albaniac/Teplica/Proteus_USB_Distance/Gerber/Proteus_USB_Distance - CADCAM Mechanical 1.TXT

G04 PROTEUS RS274X GERBER FILE*
%FSLAX24Y24*%
%MOIN*%
%ADD43C,0.0050*%
%ADD73C,0.0080*%
G54D43*
X+11545Y+1278D02*
X+11545Y+1632D01*
X+12293Y+1632D01*
X+12293Y+1278D01*
X+11545Y+1278D01*
X+11547Y-1918D02*
X+11547Y-1564D01*
X+12295Y-1564D01*
X+12295Y-1918D01*
X+11547Y-1918D01*
G54D73*
X-12538Y-8065D02*
X+13058Y-8065D01*
X+13058Y+7624D01*
X-12538Y+7624D01*
X-12538Y-8065D01*
M00*
