albaniac/Teplica/Proteus Teplitca2/GERBER/Teplitca2_1 - CADCAM Mechanical 1.TXT

G04 PROTEUS RS274X GERBER FILE*
%FSLAX24Y24*%
%MOIN*%
%ADD17C,0.0080*%
G54D17*
X-57840Y-34693D02*
X+58563Y-34693D01*
X+58563Y+36302D01*
X-57840Y+36302D01*
X-57840Y-34693D01*
M00*
