albaniac/Teplica/Proteus Teplitca1/GERBER/Teplitca1_1 - CADCAM Mechanical 1.TXT

G04 PROTEUS RS274X GERBER FILE*
%FSLAX24Y24*%
%MOIN*%
%ADD18C,0.0080*%
G54D18*
X-57840Y-34693D02*
X+58563Y-34693D01*
X+58563Y+48073D01*
X-57840Y+48073D01*
X-57840Y-34693D01*
M00*
