albaniac/Teplica/SOFT/lang/en.ini.richTextBox1.rtf

To add SMS to device click the "Add SMS" button - after entering params new SMS will be saved to the device automatically.

By clicking the "SMS list" button you can view entered SMS list, saved locally. This list is for help purposes only.

Any SMS, added by clicking the "Add SMS" button is saved to the device automatically. In the current version of firmware it is not possible to get list of SMS, stored in device. Uniqueness of SMS is computed based on SMS text - if the SMS with such text already exists - it will be overwritten in the device.

Default commands are:

1. #1 - open windows;
2. #0 - close windows;
3. #4 - turn watering on;
4. #6 - turn watering off;
5. #8 - turn device into automatic work mode;
6. #9 - get status SMS*.
7. #5 - request balance (received via SMS);

*You can receive status SMS by simple make call to the device phone number.
