albaniac/Teplica/ProteusGreenhouseDUE0_1/Gerber/ProteusGreenhouseDUE0_7 - CADCAM Mechanical 1.TXT

G04 PROTEUS RS274X GERBER FILE*
%FSLAX24Y24*%
%MOIN*%
%ADD90C,0.0050*%
%ADD10C,0.0080*%
G54D90*
X+56833Y-14618D02*
X+56833Y-14264D01*
X+57581Y-14264D01*
X+57581Y-14618D01*
X+56833Y-14618D01*
X+56833Y-11862D02*
X+56833Y-11508D01*
X+57581Y-11508D01*
X+57581Y-11862D01*
X+56833Y-11862D01*
X+56832Y-20108D02*
X+56832Y-19754D01*
X+57580Y-19754D01*
X+57580Y-20108D01*
X+56832Y-20108D01*
X+56832Y-17352D02*
X+56832Y-16998D01*
X+57580Y-16998D01*
X+57580Y-17352D01*
X+56832Y-17352D01*
G54D10*
X-57840Y-34693D02*
X+58563Y-34693D01*
X+58563Y+36302D01*
X-57840Y+36302D01*
X-57840Y-34693D01*
M00*
