albaniac/Teplica/ProteusGreenhouseDUE0_1/DOC/show.pdf

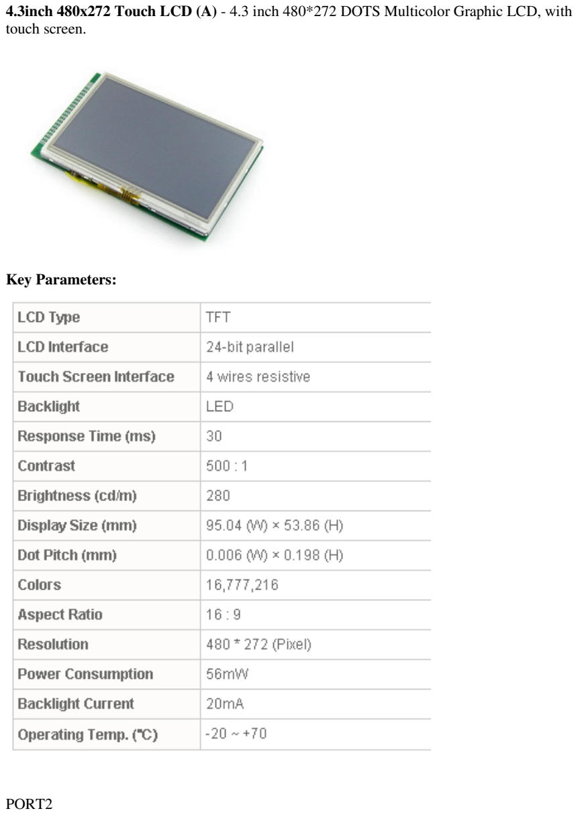
[picture p23: page 1]

4.3inch 480x272 Touch LCD (A) - 4.3 inch 480*272 DOTS Multicolor Graphic LCD, with touch screen.

Key Parameters:

PORT2

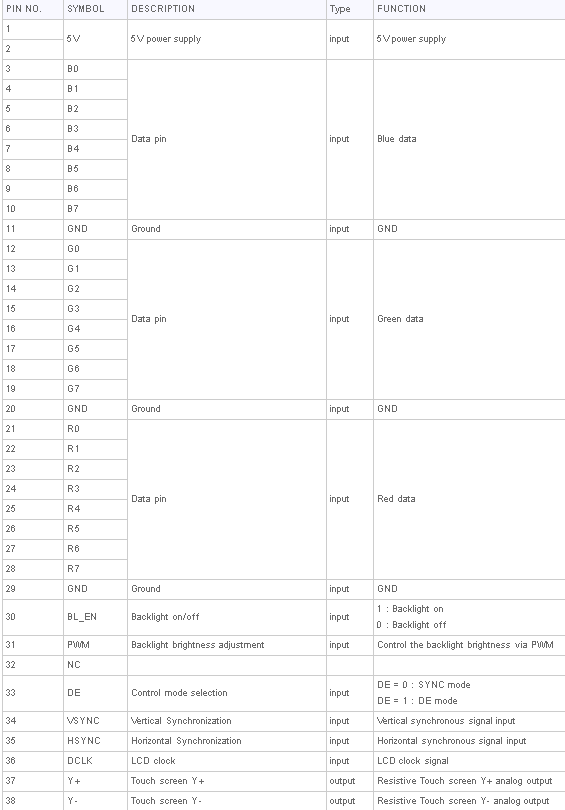
[picture p24: page 2]
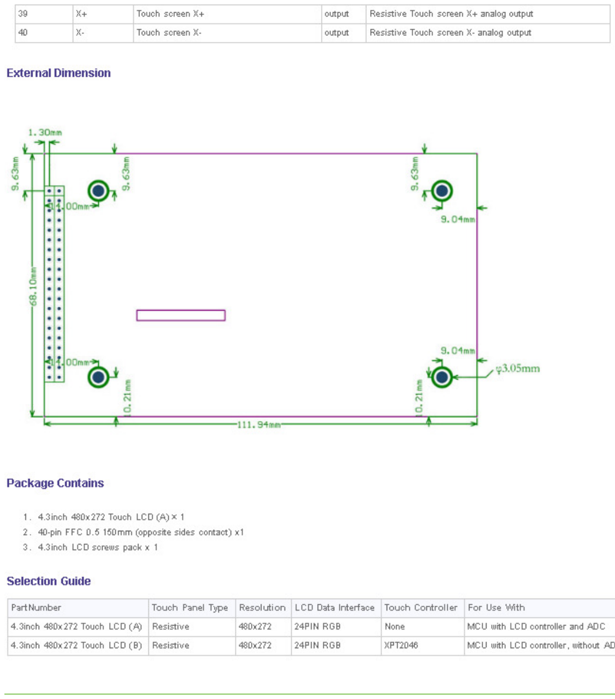
[picture p25: page 3]
