albaniac/Teplica/DOC/HTB1qAwCckSWBuNjSszdq6zeSpXaJ.jpg

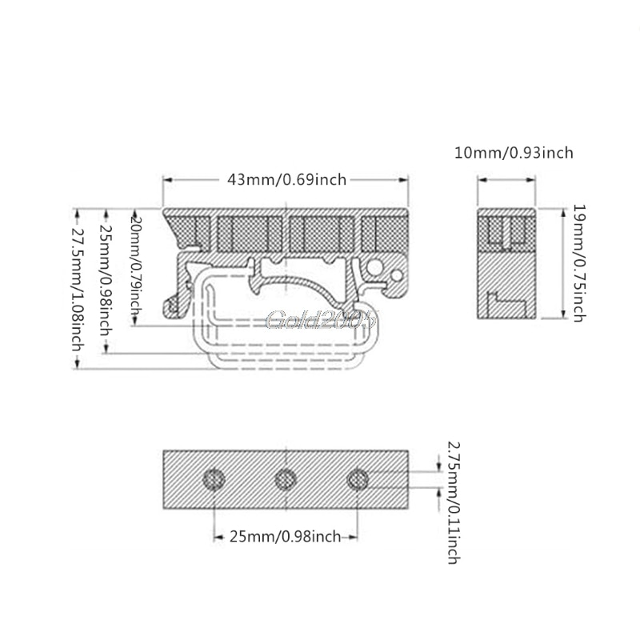
DOC/HTB1qAwCckSWBuNjSszdq6zeSpXaJ.jpg
