albaniac/Teplica/DOC/rj11_02.jpg

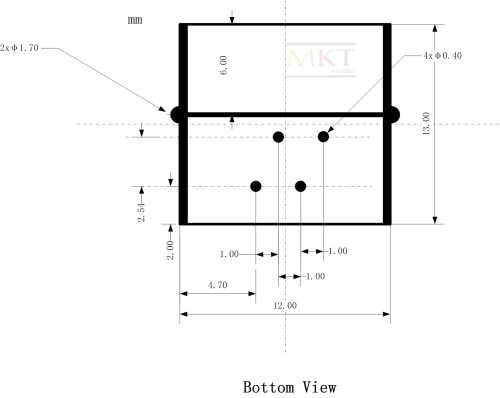
DOC/rj11_02.jpg
