albaniac/Teplica/DOC/rj11_03.jpg

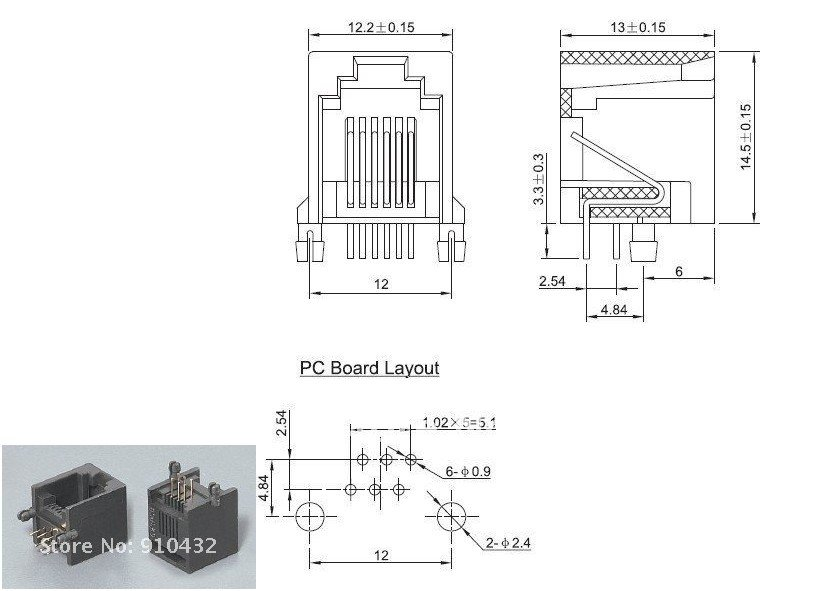
DOC/rj11_03.jpg
