albaniac/Teplica/DOC/rj11_04.jpg

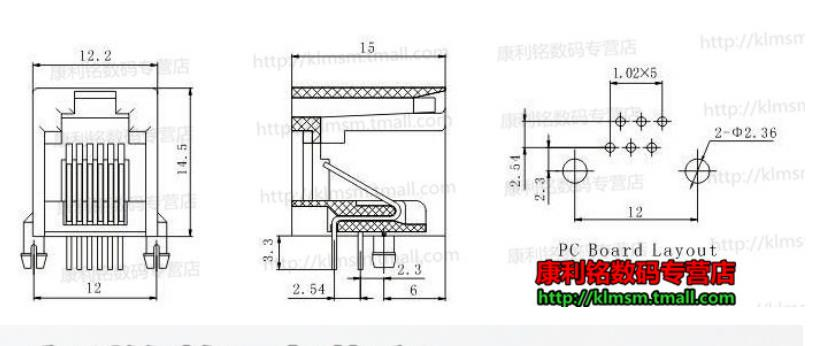
DOC/rj11_04.jpg
