albaniac/Teplica/DOC/RJ11I.gif

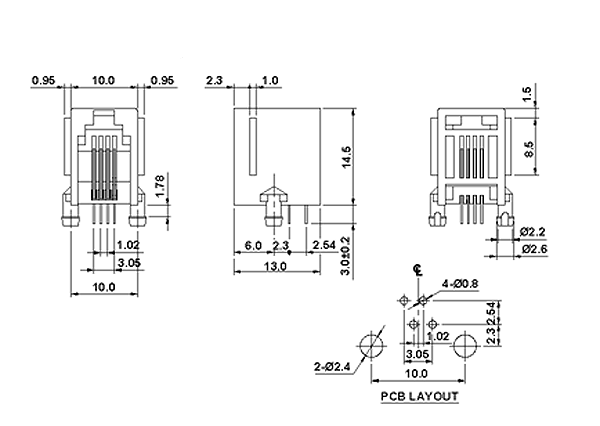
DOC/RJ11I.gif
