albaniac/Teplica/ProteusGreenhouseDUE0_1/DOC/s-l500 (1).jpg

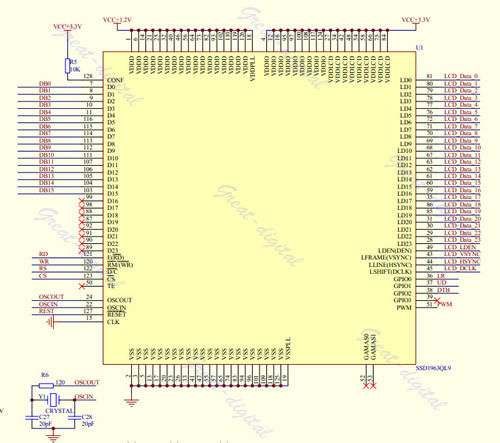
ProteusGreenhouseDUE0_1/DOC/s-l500 (1).jpg
