albaniac/Teplica/ProteusGreenhouseDUE0_1/DOC/s-l500.jpg

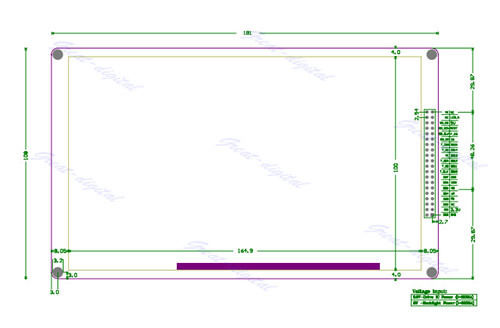
ProteusGreenhouseDUE0_1/DOC/s-l500.jpg
