albaniac/Teplica/ProteusGreenhouseDUE0_1/DOC/SD разъем.png

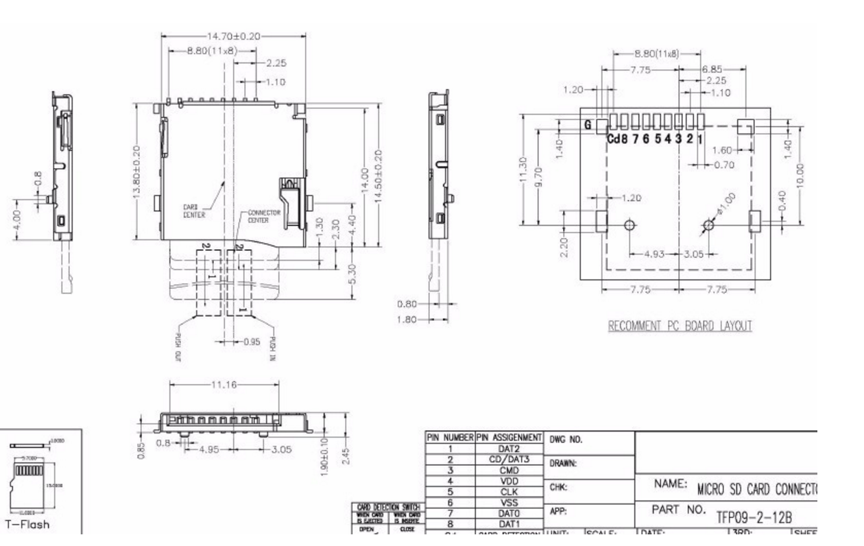
ProteusGreenhouseDUE0_1/DOC/SD разъем.png
