albaniac/Teplica/ProteusGreenhouseDUE0_1/DOC/shield-arduino-sd-card.jpg

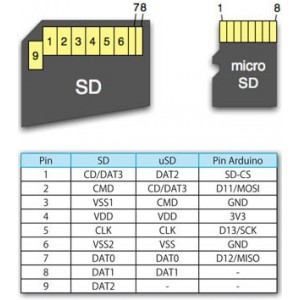
ProteusGreenhouseDUE0_1/DOC/shield-arduino-sd-card.jpg
