albaniac/Teplica/ProteusGreenhouseDUE0_1/DOC/TFT4.3.jpg

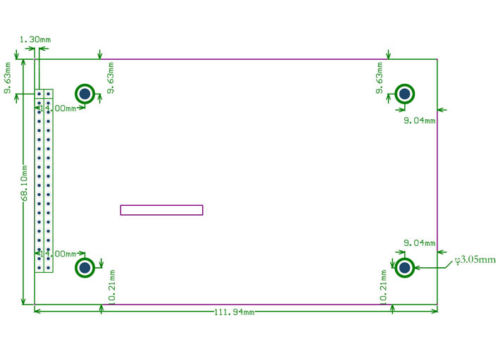
ProteusGreenhouseDUE0_1/DOC/TFT4.3.jpg
