albaniac/Teplica/ProteusGreenhouseDUE0_1/DOC/TFT4.3_1.jpg

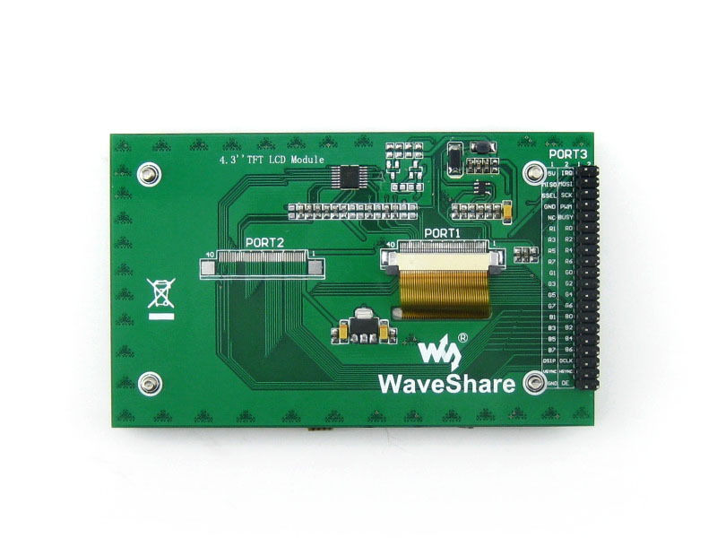
ProteusGreenhouseDUE0_1/DOC/TFT4.3_1.jpg
