albaniac/Teplica/ProteusGreenhouseSTM32_Base_01/DOC/STM32F407ZGT6 module.jpg

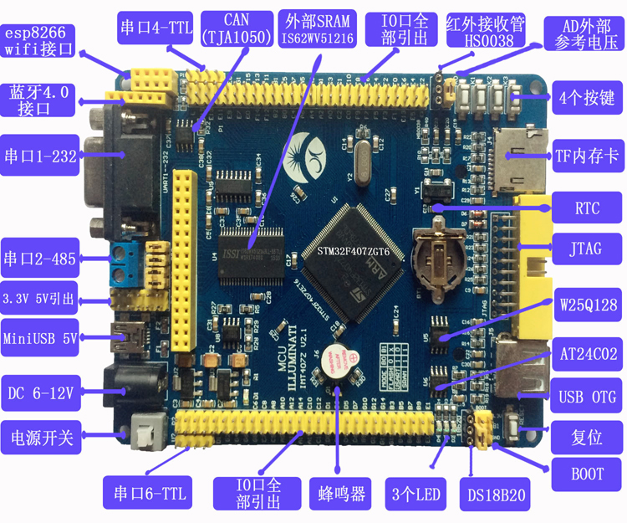
ProteusGreenhouseSTM32_Base_01/DOC/STM32F407ZGT6 module.jpg
