albaniac/Teplica/ProteusGreenhouseSTM32_Base_01/DOC/Подключение дисплея.jpg

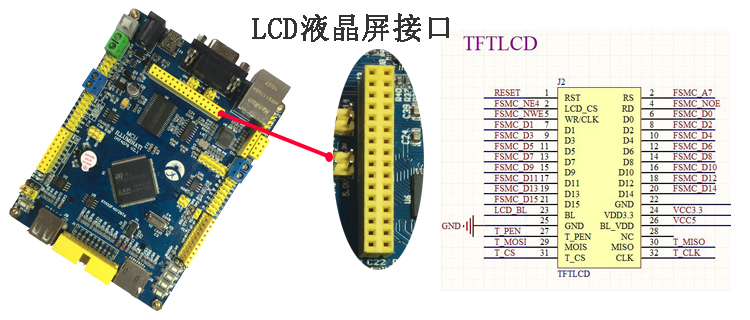
ProteusGreenhouseSTM32_Base_01/DOC/Подключение дисплея.jpg
