albaniac/Teplica/DOC/Цены базовый модуль.xls

Bill Of Materials for Теплица
Design Title |  |  | Теплица
Author |  |  | Мосейчук А.В.
Document Number
Revision |  |  | 1.1
Design Created |  |  | 8 декабря 2013 г.
Design Last Modified |  |  | 22 февраля 2018 г.
Total Parts In Design |  |  | 287
Category | Quantity | References | Value | Цена | Сумма
Capacitors | 29 | C1,C7-C10,C14-C17,C19-C20,C22-C25,C27,C30-C33,C35-C37,C57-C58,C61-C63,C87 | 100n | 0.5 ₽ | 14.5 ₽
Capacitors | 3 | C2,C6,C12 | 2200u | 40.0 ₽ | 120.0 ₽
Capacitors | 1 | C3 | 0.1uF | 0.5 ₽ | 0.5 ₽
Capacitors | 4 | C4-C5,C28,C45 | 47u | 10.0 ₽ | 40.0 ₽
Capacitors | 2 | C11,C44 | 100n | 0.5 ₽ | 1.0 ₽
Capacitors | 1 | C13 | 100u | 0.5 ₽ | 0.5 ₽
Capacitors | 8 | C18,C34,C55,C59,C64-C67 | 10u | 0.5 ₽ | 4.0 ₽
Capacitors | 2 | C21,C54 | 100n | 0.5 ₽ | 1.0 ₽
Capacitors | 21 | C26,C40,C68-C86 | 100n | 0.5 ₽ | 10.5 ₽
Capacitors | 1 | C29 | 1n | 0.5 ₽ | 0.5 ₽
Capacitors | 7 | C38-C39,C41,C50-C51,C53,C60 | 22pF | 0.5 ₽ | 3.5 ₽
Capacitors | 1 | C42 | 100n | 0.5 ₽ | 0.5 ₽
Capacitors | 1 | C43 | 1u | 0.5 ₽ | 0.5 ₽
Capacitors | 4 | C46-C49 | 5pf | 0.5 ₽ | 2.0 ₽
Capacitors | 1 | C52 | 10n | 0.5 ₽ | 0.5 ₽
Capacitors | 1 | C56 | 47u | 10.0 ₽ | 10.0 ₽
Resistors | 9 | R1-R2,R7-R8,R77-R78,R81-R83 | 10K | 0.3 ₽ | 2.7 ₽
Resistors | 1 | R3 | 0 | 0.3 ₽ | 0.3 ₽
Resistors | 2 | R4-R5 | 39 | 0.3 ₽ | 0.6 ₽
Resistors | 1 | R6 | 6.8K | 0.3 ₽ | 0.3 ₽
Resistors | 1 | R9 | 200 | 0.3 ₽ | 0.3 ₽
Resistors | 8 | R10,R14-R16,R38-R40,R47 | 100K | 0.3 ₽ | 2.4 ₽
Resistors | 5 | R11,R19,R49-R50,R54 | 1.0K | 0.3 ₽ | 1.5 ₽
Resistors | 9 | R12,R22-R23,R58,R62,R66,R68,R75,R79 | 10K | 0.3 ₽ | 2.7 ₽
Resistors | 13 | R13,R20-R21,R32-R34,R36,R44,R46,R48,R74,R76,R80 | 10K | 0.3 ₽ | 3.9 ₽
Resistors | 3 | R17,R60-R61 | 51 | 0.3 ₽ | 0.9 ₽
Resistors | 2 | R18,R31 | 1.3 | 0.3 ₽ | 0.6 ₽
Resistors | 1 | R24 | 10K | 0.3 ₽ | 0.3 ₽
Resistors | 4 | R25-R28 | 1.5K | 0.3 ₽ | 1.2 ₽
Resistors | 8 | R29-R30,R37,R59,R63-R65,R71 | 1.0K | 0.3 ₽ | 2.4 ₽
Resistors | 1 | R35 | 5.1K | 0.3 ₽ | 0.3 ₽
Resistors | 3 | R41,R69-R70 | 4,7K | 0.3 ₽ | 0.9 ₽
Resistors | 1 | R42 | 100K | 0.3 ₽ | 0.3 ₽
Resistors | 1 | R43 | 2.7K | 0.3 ₽ | 0.3 ₽
Resistors | 1 | R45 | 47K | 0.3 ₽ | 0.3 ₽
Resistors | 1 | R51 | 3.3K | 0.3 ₽ | 0.3 ₽
Resistors | 1 | R52 | 6.9K | 0.3 ₽ | 0.3 ₽
Resistors | 1 | R53 | 2.2K | 0.3 ₽ | 0.3 ₽
Resistors | 2 | R55-R56 | 1.0K | 0.3 ₽ | 0.6 ₽
Resistors | 1 | R57 | 560 | 0.3 ₽ | 0.3 ₽
Resistors | 1 | R67 | 10K | 0.3 ₽ | 0.3 ₽
Resistors | 1 | R72 | 3.3K | 0.3 ₽ | 0.3 ₽
Resistors | 1 | R73 | 6.8K | 0.3 ₽ | 0.3 ₽
Integrated Circuits | 3 | U1-U2,U19 | MCP23017 | 47.0 ₽ | 141.0 ₽
Integrated Circuits | 1 | U3 | ESP8266_07 | 360.0 ₽ | 360.0 ₽
Integrated Circuits | 1 | U4 | ULN2003A | 6.0 ₽ | 6.0 ₽
Integrated Circuits | 1 | U5 | P82B715TD | 50.0 ₽ | 50.0 ₽
Integrated Circuits | 1 | U6 | ATSAM3X8EA | 420.0 ₽ | 420.0 ₽
Integrated Circuits | 1 | U7 | ATMEGA16U2 | 100.0 ₽ | 100.0 ₽
Integrated Circuits | 1 | U8 | NE555 | 10.0 ₽ | 10.0 ₽
Integrated Circuits | 1 | U9 | LMX358ASA | 10.0 ₽ | 10.0 ₽
Integrated Circuits | 1 | U10 | MAX485 | 10.0 ₽ | 10.0 ₽
Integrated Circuits | 1 | U11 | AT24C32 | 10.0 ₽ | 10.0 ₽
Integrated Circuits | 2 | U12-U13 | 74HC595 | 10.0 ₽ | 20.0 ₽
Integrated Circuits | 1 | U14 | SIM800C | 210.0 ₽ | 210.0 ₽
Integrated Circuits | 1 | U15 | DS3231A | 45.0 ₽ | 45.0 ₽
Integrated Circuits | 1 | U16 | AMS1117 | 8.0 ₽ | 8.0 ₽
Integrated Circuits | 1 | U17 | 74HC125 | 10.0 ₽ | 10.0 ₽
Integrated Circuits | 1 | U18 | DHT22 | 0.0 ₽ | 0.0 ₽
Integrated Circuits | 1 | U20 | LORA1276 | 0.0 ₽ | 0.0 ₽
Integrated Circuits | 2 | U21-U22 | DS18B20 | 80.0 ₽ | 160.0 ₽
Transistors | 2 | Q1,Q3 | BC847B | 5.0 ₽ | 10.0 ₽
Transistors | 9 | Q2,Q4-Q11 | FDN340 | 5.0 ₽ | 45.0 ₽
Diodes | 1 | D1 | AOZ8212CI-05 | 10.0 ₽ | 10.0 ₽
Diodes | 3 | D2,D6,D11 | LED-GREEN | 5.0 ₽ | 15.0 ₽
Diodes | 3 | D3,D5,D10 | LED-RED | 5.0 ₽ | 15.0 ₽
Diodes | 3 | D4,D9,D13 | 1N4148WS-7_1 | 10.0 ₽ | 30.0 ₽
Diodes | 4 | D7-D8,D12,D14 | LED | 5.0 ₽ | 20.0 ₽
Diodes | 2 | D15,D17 | PRTR5V0U2X | 10.0 ₽ | 20.0 ₽
Diodes | 1 | D16 | DL4001 | 7.0 ₽ | 7.0 ₽
Miscellaneous | 1 | CI1 | 3.3V | 100.0 ₽ | 100.0 ₽
Miscellaneous | 1 | EN1 | ENCODER | 0.0 ₽ | 0.0 ₽
Miscellaneous | 2 | F1-F2 | MF-MSMF050-2 500mA | 5.0 ₽ | 10.0 ₽
Miscellaneous | 2 | J1,J3 | CONN-DIL20-1 | 20.0 ₽ | 40.0 ₽
Miscellaneous | 10 | J2,J6,J13,J17,J21-J23,J35-J37 | RJ-4U | 7.0 ₽ | 70.0 ₽
Miscellaneous | 1 | J4 | CONN-2X5-P1_27 | 10.0 ₽ | 10.0 ₽
Miscellaneous | 1 | J5 | CONN-DIL40 | 30.0 ₽ | 30.0 ₽
Miscellaneous | 1 | J7 | SD_TFT | 10.0 ₽ | 10.0 ₽
Miscellaneous | 8 | J8,J10,J14-J15,J24-J26,J31 | CONN-SIL1 | 1.0 ₽ | 8.0 ₽
Miscellaneous | 2 | J9,J40 | USB_MICROB | 20.0 ₽ | 40.0 ₽
Miscellaneous | 3 | J11,J27-J28 | CONN-SIL4 | 5.0 ₽ | 15.0 ₽
Miscellaneous | 1 | J12 | CON_POWER | 10.0 ₽ | 10.0 ₽
Miscellaneous | 4 | J16,J19,J30,J32 | CONN-SIL2 | 3.0 ₽ | 12.0 ₽
Miscellaneous | 1 | J18 | CONN-DIL6 | 5.0 ₽ | 5.0 ₽
Miscellaneous | 1 | J20 | CONN-DIL8 | 5.0 ₽ | 5.0 ₽
Miscellaneous | 2 | J29,J38 | CONN-DIL10 | 10.0 ₽ | 20.0 ₽
Miscellaneous | 1 | J33 | TBLOCK-I2 | 5.0 ₽ | 5.0 ₽
Miscellaneous | 1 | J34 | CONN-SIL3 | 10.0 ₽ | 10.0 ₽
Miscellaneous | 1 | J39 | SIM_KA_179 | 20.0 ₽ | 20.0 ₽
Miscellaneous | 8 | J1_RJ45,J2_RJ45,J3_RJ45,J4_RJ45,J5_RJ45,J6_RJ45,J7_RJ45,J8_RJ45 | CONN-RJ45 | 20.0 ₽ | 160.0 ₽
Miscellaneous | 5 | L1-L4,L7 | 330nH | 5.0 ₽ | 25.0 ₽
Miscellaneous | 1 | LCD1_ST7920 | ST7920 | 0.0 ₽ | 0.0 ₽
Miscellaneous | 1 | LS1 | SOUNDER | 15.0 ₽ | 15.0 ₽
Miscellaneous | 2 | RF1,RF4 | IPEX UFL/IPX | 10.0 ₽ | 20.0 ₽
Miscellaneous | 1 | RF2 | AN1603_868 | 0.0 ₽ | 0.0 ₽
Miscellaneous | 1 | SW1 | BUTTON2 | 5.0 ₽ | 5.0 ₽
Miscellaneous | 1 | SW2 | BUTTON3 | 5.0 ₽ | 5.0 ₽
Miscellaneous | 1 | X1 | CRYSTAL_KX_7 | 15.0 ₽ | 15.0 ₽
Miscellaneous | 1 | X2 | FC145_32768 | 22.0 ₽ | 22.0 ₽
Miscellaneous | 1 | X3 | CSTCE16M0V53R0 | 27.0 ₽ | 27.0 ₽
 | 1 | Печатная плата |  | 300.0 ₽ | 300.0 ₽
 | 1 | DC/DC12 |  | 65.0 ₽ | 65.0 ₽
 | 1 | DC/DC4 |  | 24.0 ₽ | 24.0 ₽
 | 1 | Сборка |  | 3000.0 ₽ | 3000.0 ₽
 | 1 | CR2032 |  | 30.0 ₽ | 30.0 ₽
 |  |  |  |  | 6109.4 ₽
