albaniac/Teplica/DOC/Цены большой модуль.xls

Bill Of Materials for Теплица
Design Title |  |  | Теплица
Author |  |  | Мосейчук А.В.
Document Number
Revision |  |  | 1.1
Design Created |  |  | 8 декабря 2013 г.
Design Last Modified |  |  | 27 января 2018 г.
Total Parts In Design |  |  | 553
Category | Quantity | References | Value | Цена | Сумма
Capacitors | 58 | C1,C7-C10,C14-C27,C32-C33,C35-C41,C66-C73,C134-C155 | 0.22u | 1.0 ₽ | 58.0 ₽
Capacitors | 3 | C2,C6,C12 | 2200u | 40.0 ₽ | 120.0 ₽
Capacitors | 1 | C3 | 0.1uF | 0.5 ₽ | 0.5 ₽
Capacitors | 5 | C4-C5,C28,C30,C88 | 47u | 10.0 ₽ | 50.0 ₽
Capacitors | 4 | C11,C29,C31,C87 | 1n | 0.5 ₽ | 2.0 ₽
Capacitors | 1 | C13 | 100u | 0.5 ₽ | 0.5 ₽
Capacitors | 9 | C34,C102-C104,C128-C131,C133 | 10u | 0.5 ₽ | 4.5 ₽
Capacitors | 7 | C44,C83-C84,C96-C99 | 22pF | 0.5 ₽ | 3.5 ₽
Capacitors | 20 | C82,C106-C121,C123-C125 | 100n | 0.5 ₽ | 10.0 ₽
Capacitors | 1 | C85 | 100n | 0.5 ₽ | 0.5 ₽
Capacitors | 1 | C86 | 1u | 0.5 ₽ | 0.5 ₽
Capacitors | 4 | C90-C93 | 5pf | 0.5 ₽ | 2.0 ₽
Capacitors | 2 | C100,C105 | 10n | 0.5 ₽ | 1.0 ₽
Capacitors | 1 | C101 | 100n | 0.5 ₽ | 0.5 ₽
Resistors | 12 | R1-R2,R7-R8,R11,R13,R17-R18,R20-R21,R180-R181 | 10K | 0.3 ₽ | 3.6 ₽
Resistors | 1 | R3 | 0 | 0.3 ₽ | 0.3 ₽
Resistors | 2 | R4-R5 | 39 | 0.3 ₽ | 0.6 ₽
Resistors | 1 | R6 | 6.8K | 0.3 ₽ | 0.3 ₽
Resistors | 12 | R9,R12,R22,R75,R84,R92,R126,R140,R164,R179,R190,R200 | 10K | 0.3 ₽ | 3.6 ₽
Resistors | 9 | R10,R14-R16,R24,R38-R40,R47 | 100K | 0.3 ₽ | 2.7 ₽
Resistors | 1 | R19 | 11k | 0.3 ₽ | 0.3 ₽
Resistors | 36 | R23,R88-R90,R93-R106,R111-R115,R117-R118,R121-R125,R182-R187 | 0 | 0.3 ₽ | 10.8 ₽
Resistors | 4 | R25-R28 | 1.5K | 0.3 ₽ | 1.2 ₽
Resistors | 14 | R29-R30,R32-R33,R37,R81,R86-R87,R91,R107-R110,R131 | 1.0K | 0.3 ₽ | 4.2 ₽
Resistors | 1 | R31 | 11 | 0.3 ₽ | 0.3 ₽
Resistors | 16 | R34,R44,R48,R144-R148,R153,R162,R173,R175,R177,R188-R189,R192 | 10K | 0.3 ₽ | 4.8 ₽
Resistors | 10 | R35,R165-R172,R196 | 100 | 0.3 ₽ | 3.0 ₽
Resistors | 7 | R36,R42,R49-R50,R191,R193-R194 | 100K | 0.3 ₽ | 2.1 ₽
Resistors | 5 | R41,R127-R130 | 4,7K | 0.3 ₽ | 1.5 ₽
Resistors | 1 | R43 | 2.7K | 0.3 ₽ | 0.3 ₽
Resistors | 10 | R45,R149-R152,R154,R163,R174,R176,R178 | 47K | 0.3 ₽ | 3.0 ₽
Resistors | 2 | R46,R195 | 100 | 0.3 ₽ | 0.6 ₽
Resistors | 1 | R51 | 3.3K | 0.3 ₽ | 0.3 ₽
Resistors | 1 | R52 | 6.9K | 0.3 ₽ | 0.3 ₽
Resistors | 2 | R70-R71 | 1.0K | 0.3 ₽ | 0.6 ₽
Resistors | 2 | R72-R73 | 22 | 0.3 ₽ | 0.6 ₽
Resistors | 1 | R74 | 560 | 0.3 ₽ | 0.3 ₽
Resistors | 2 | R77,R79 | 22 | 0.3 ₽ | 0.6 ₽
Resistors | 1 | R116 | 10K | 0.3 ₽ | 0.3 ₽
Resistors | 1 | R132 | 6.8K | 0.3 ₽ | 0.3 ₽
Resistors | 1 | R133 | 3.3K | 0.3 ₽ | 0.3 ₽
Resistors | 5 | R134-R137,R156 | 1.0K | 0.3 ₽ | 1.5 ₽
Resistors | 1 | R138 | 3.3K | 0.3 ₽ | 0.3 ₽
Resistors | 1 | R139 | 6.8K | 0.3 ₽ | 0.3 ₽
Resistors | 3 | R141-R143 | 510 | 0.3 ₽ | 0.9 ₽
Resistors | 1 | R155 | 2.2K | 0.3 ₽ | 0.3 ₽
Resistors | 3 | R157-R159 | 51 | 0.3 ₽ | 0.9 ₽
Resistors | 1 | R161 | 11K | 0.3 ₽ | 0.3 ₽
Resistors | 1 | R201 | 200 | 0.3 ₽ | 0.3 ₽
Integrated Circuits | 1 | U1 | ATSAM3X8EA | 420.0 ₽ | 420.0 ₽
Integrated Circuits | 1 | U2 | ATMEGA16U2 | 100.0 ₽ | 100.0 ₽
Integrated Circuits | 6 | U3-U5,U7-U8,U28 | MCP23S17/MCP20S17 | 50.0 ₽ | 300.0 ₽
Integrated Circuits | 3 | U6,U21-U22 | DS18B20 | 80.0 ₽ | 240.0 ₽
Integrated Circuits | 1 | U9 | LMX358ASA | 10.0 ₽ | 10.0 ₽
Integrated Circuits | 1 | U10 | MAX485 | 10.0 ₽ | 10.0 ₽
Integrated Circuits | 3 | U11,U29-U30 | P82B715TD | 50.0 ₽ | 150.0 ₽
Integrated Circuits | 4 | U12-U15 | 74HC595 | 10.0 ₽ | 40.0 ₽
Integrated Circuits | 1 | U16 | AMS1117 | 8.0 ₽ | 8.0 ₽
Integrated Circuits | 1 | U17 | 74HC125 | 10.0 ₽ | 10.0 ₽
Integrated Circuits | 2 | U18,U23 | DHT22 | 0.0 ₽ | 0.0 ₽
Integrated Circuits | 1 | U20 | DS3231A | 45.0 ₽ | 45.0 ₽
Integrated Circuits | 1 | U24 | SIM800C | 210.0 ₽ | 210.0 ₽
Integrated Circuits | 2 | U25-U26 | AT24C32 | 10.0 ₽ | 20.0 ₽
Integrated Circuits | 1 | U27 | NE555 | 10.0 ₽ | 10.0 ₽
Transistors | 12 | Q1,Q3,Q6-Q8,Q10-Q16 | BC847B | 5.0 ₽ | 60.0 ₽
Transistors | 3 | Q2,Q4-Q5 | FDN340 | 5.0 ₽ | 15.0 ₽
Transistors | 5 | Q9,Q17-Q20 | FDN340P | 5.0 ₽ | 25.0 ₽
Diodes | 3 | D1,D8,D38 | AOZ8212CI-05 | 10.0 ₽ | 30.0 ₽
Diodes | 4 | D2,D5,D11-D12 | LED-GREEN | 5.0 ₽ | 20.0 ₽
Diodes | 4 | D3-D4,D10,D22 | LED-RED | 5.0 ₽ | 20.0 ₽
Diodes | 1 | D6 | DL4001 | 10.0 ₽ | 10.0 ₽
Diodes | 83 | D7,D9,D13-D20,D26-D32,D36-D37,D45-D48,D57-D76,D100-D139 | 1N4148WS-7_1 | 10.0 ₽ | 830.0 ₽
Diodes | 7 | D21,D23-D25,D33-D35 | LED | 5.0 ₽ | 35.0 ₽
Miscellaneous | 1 | BAT1 |  | 20.0 ₽ | 20.0 ₽
Miscellaneous | 2 | DSW1-DSW2 | DIPSW_2 | 10.0 ₽ | 20.0 ₽
Miscellaneous | 1 | EN1 | ENCODER | 0.0 ₽ | 0.0 ₽
Miscellaneous | 2 | F1-F2 | MF-MSMF050-2 500mA | 5.0 ₽ | 10.0 ₽
Miscellaneous | 4 | J1-J4 | TBLOCK-M12 | 50.0 ₽ | 200.0 ₽
Miscellaneous | 13 | J5-J6,J15,J17,J31,J35,J39-J40,J47,J67-J69,J77 | RJ-4U | 7.0 ₽ | 91.0 ₽
Miscellaneous | 3 | J7-J8,J13 | CONN-DIL20-1 | 20.0 ₽ | 60.0 ₽
Miscellaneous | 2 | J9,J27 | USB_MICROB | 20.0 ₽ | 40.0 ₽
Miscellaneous | 1 | J10 | CONN-2X5-P1_27 | 10.0 ₽ | 10.0 ₽
Miscellaneous | 2 | J11,J72 | PWMH | 0.0 ₽ | 0.0 ₽
Miscellaneous | 3 | J12,J36,J75 | CONN-DIL6 | 10.0 ₽ | 30.0 ₽
Miscellaneous | 1 | J14 | CONN-DIL40 | 30.0 ₽ | 30.0 ₽
Miscellaneous | 1 | J16 | SD_TFT | 10.0 ₽ | 10.0 ₽
Miscellaneous | 11 | J18,J20,J28,J32-J33,J44-J45,J49-J50,J52,J60 | CONN-SIL1 | 0.0 ₽ | 0.0 ₽
Miscellaneous | 2 | J19,J38 | CONN-DIL8 | 0.0 ₽ | 0.0 ₽
Miscellaneous | 2 | J21,J70 | POWER | 15.0 ₽ | 30.0 ₽
Miscellaneous | 2 | J22,J71 | ADCL | 5.0 ₽ | 10.0 ₽
Miscellaneous | 1 | J23 | ADCH | 5.0 ₽ | 5.0 ₽
Miscellaneous | 1 | J24 | CONN-DIL36 | 0.0 ₽ | 0.0 ₽
Miscellaneous | 1 | J25 | COMMUNICATION | 0.0 ₽ | 0.0 ₽
Miscellaneous | 2 | J26,J73 | PWML | 0.0 ₽ | 0.0 ₽
Miscellaneous | 3 | J29,J53-J54 | CONN-SIL4 | 5.0 ₽ | 15.0 ₽
Miscellaneous | 1 | J30 | CON_POWER | 10.0 ₽ | 10.0 ₽
Miscellaneous | 4 | J34,J37,J58,J61 | CONN-SIL2 | 5.0 ₽ | 20.0 ₽
Miscellaneous | 1 | J41 | SIM_HOLDER | 24.0 ₽ | 24.0 ₽
Miscellaneous | 21 | J42,J10_RJ45,J11_RJ45,J12_RJ45,J13_RJ45,J14_RJ45,J15_RJ45,J16_RJ45,J17_RJ45,J18_RJ45,J19_RJ45,J1_RJ45,J20_RJ45,J2_RJ45,J3_RJ45,J4_RJ45,J5_RJ45,J6_RJ45,J7_RJ45,J8_RJ45,J9_RJ45 | CONN-RJ45 | 20.0 ₽ | 420.0 ₽
Miscellaneous | 1 | J46 | CONN-DIL12 | 10.0 ₽ | 10.0 ₽
Miscellaneous | 1 | J48 | CONN-SIL8 | 10.0 ₽ | 10.0 ₽
Miscellaneous | 6 | J55,J59,J63-J66 | CONN-SIL3 | 10.0 ₽ | 60.0 ₽
Miscellaneous | 1 | J57 | CONN-DIL10 | 10.0 ₽ | 10.0 ₽
Miscellaneous | 1 | J62 | TBLOCK-I2 | 5.0 ₽ | 5.0 ₽
Miscellaneous | 4 | L1-L4 | 330nH | 5.0 ₽ | 20.0 ₽
Miscellaneous | 1 | LCD1 | ST7920 | 0.0 ₽ | 0.0 ₽
Miscellaneous | 1 | LED1 | CON4_LEDRGB | 10.0 ₽ | 10.0 ₽
Miscellaneous | 1 | LS1 | SOUNDER | 15.0 ₽ | 15.0 ₽
Miscellaneous | 1 | RF1 | RF-MCX-2S | 10.0 ₽ | 10.0 ₽
Miscellaneous | 1 | RF2 | IPEX UFL/IPX | 10.0 ₽ | 10.0 ₽
Miscellaneous | 1 | RV1 | 10K | 20.0 ₽ | 20.0 ₽
Miscellaneous | 1 | SW1 | BUTTON2 | 5.0 ₽ | 5.0 ₽
Miscellaneous | 1 | SW2 | BUTTON3 | 5.0 ₽ | 5.0 ₽
Miscellaneous | 1 | X1 | CSTCE12M0G55Z-R0 | 27.0 ₽ | 27.0 ₽
Miscellaneous | 1 | X2 | CRYSTAL_32768 | 22.0 ₽ | 22.0 ₽
Miscellaneous | 1 | X4 | CSTCE16M0V53R0 | 27.0 ₽ | 27.0 ₽
 | 1 | Печатная плата |  | 1000.0 ₽ | 1000.0 ₽
 | 1 | DC/DC12 |  | 65.0 ₽ | 65.0 ₽
 | 1 | DC/DC4 |  | 24.0 ₽ | 24.0 ₽
 | 1 | CR2032 |  | 30.0 ₽ | 30.0 ₽
 | 1 | Сборка |  | 3500.0 ₽ | 3500.0 ₽
 | 1 | ESP8266_01 |  | 120.0 ₽ | 120.0 ₽
 |  |  |  |  | FALSE
