albaniac/Teplica/ProteusGreenhouseDUE0_1/Gerber/ProteusGreenhouseDUE0_7 - CADCAM Top Solder Resist.TXT

G04 PROTEUS RS274X GERBER FILE*
%FSLAX24Y24*%
%MOIN*%
%ADD47C,0.0500*%
%ADD91R,0.1000X0.1000*%
%ADD92C,0.1780*%
%ADD21R,0.0120X0.0610*%
%ADD22R,0.0610X0.0120*%
%ADD93C,0.1181*%
%ADD94R,0.0600X0.0600*%
%ADD25R,0.0390X0.0370*%
%ADD26R,0.0370X0.0390*%
%ADD95R,0.0710X0.0260*%
%ADD96R,0.1540X0.0690*%
%ADD29R,0.0490X0.0710*%
%ADD72R,0.0570X0.0470*%
%ADD73R,0.0240X0.0710*%
%ADD97R,0.0400X0.0900*%
%ADD31R,0.0220X0.0590*%
%ADD39C,0.1000*%
%ADD33R,0.0570X0.0370*%
%ADD98R,0.0700X0.0600*%
%AMDIL089*4,1,8,-0.0600,0.0280,
-0.0480,0.0400,0.0480,0.0400,0.0600,0.0280,0.0600,-0.0280,
0.0480,-0.0400,-0.0480,-0.0400,-0.0600,-0.0280,-0.0600,0.0280,0*
*%
%ADD99DIL089*%
%ADD100R,0.0600X0.0700*%
%ADD32C,0.0800*%
%ADD101C,0.2100*%
%ADD102C,0.1300*%
%ADD40R,0.0650X0.0430*%
%ADD41R,0.0430X0.0650*%
%ADD103R,0.0450X0.1000*%
%ADD104R,0.1000X0.0450*%
%ADD44C,0.1320*%
%ADD105C,0.1500*%
%ADD106R,0.0700X0.0700*%
%ADD66C,0.0700*%
%ADD48R,0.0370X0.0570*%
%ADD45C,0.1200*%
%ADD107R,0.0800X0.1000*%
%ADD108R,0.1700X0.1000*%
%ADD109R,0.0550X0.0550*%
%ADD110R,0.0750X0.0240*%
%ADD111R,0.0240X0.0750*%
%ADD112R,0.0318X0.0829*%
%ADD113R,0.0829X0.0318*%
%ADD54R,0.1260X0.0770*%
%ADD114R,0.1500X0.0987*%
%ADD115R,0.1460X0.0560*%
%ADD57R,0.0350X0.0160*%
%ADD116R,0.0700X0.1500*%
%ADD117C,0.1100*%
%ADD60R,0.0610X0.0870*%
%ADD61R,0.0710X0.0450*%
%ADD62R,0.0930X0.0960*%
%ADD118R,0.0550X0.0600*%
%ADD119R,0.0600X0.0550*%
%ADD65R,0.0890X0.0710*%
%ADD59C,0.0900*%
%ADD67C,0.0550*%
%ADD120R,0.1223X0.0790*%
%ADD121C,0.0760*%
%ADD74R,0.0410X0.0180*%
%ADD75R,0.0180X0.0410*%
%ADD122R,0.1100X0.2200*%
%ADD10C,0.0080*%
G54D47*
X+45750Y-14250D03*
X+45750Y-15000D03*
X-22750Y+8000D03*
X-22750Y+8750D03*
X-20750Y+26750D03*
X-9000Y+27250D03*
X-16250Y+24250D03*
X-29000Y+24250D03*
X-15750Y-24500D03*
X-1000Y-24500D03*
X+15500Y-24500D03*
X-4750Y-500D03*
X-4750Y-4000D03*
X-4000Y-4000D03*
X-4000Y-250D03*
X+41750Y+8000D03*
X+14000Y-30250D03*
X+54000Y+17250D03*
X+0Y-30250D03*
X-31750Y+11000D03*
X-41000Y+21000D03*
X+49500Y-15000D03*
X+29500Y+12000D03*
X+29500Y+11500D03*
X-24750Y-6750D03*
X-42000Y+16500D03*
X-35000Y-20500D03*
X+46500Y+11750D03*
X+44500Y-15750D03*
X+53500Y-18000D03*
X+53500Y+8750D03*
X-40500Y+13750D03*
X-40500Y+11750D03*
X+13000Y+15000D03*
X-7500Y+33250D03*
X-21000Y+15250D03*
X-21000Y+12000D03*
X-21000Y+12750D03*
X-13500Y-17500D03*
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
