albaniac/Teplica/Proteus_USB_Distance/Gerber/Proteus_USB_Distance - CADCAM Bottom Solder Resist.TXT

G04 PROTEUS RS274X GERBER FILE*
%FSLAX24Y24*%
%MOIN*%
%ADD32C,0.0500*%
%ADD14C,0.1400*%
%ADD35R,0.1000X0.1000*%
%ADD19C,0.0550*%
%AMDIL031*4,1,8,-0.0600,0.0280,
-0.0480,0.0400,0.0480,0.0400,0.0600,0.0280,0.0600,-0.0280,
0.0480,-0.0400,-0.0480,-0.0400,-0.0600,-0.0280,-0.0600,0.0280,0*
*%
%ADD37DIL031*%
%ADD42C,0.1000*%
%ADD73C,0.0080*%
G54D32*
X-2500Y+250D03*
X-2000Y-3000D03*
X+9000Y-5500D03*
X+6558Y-308D03*
X+1125Y+2800D03*
X+1750Y-1500D03*
X+10697Y+2786D03*
X+5620Y-1980D03*
X+5812Y-3394D03*
X+4750Y+1000D03*
X+4750Y-2750D03*
X+0Y-750D03*
X+3750Y+3500D03*
X-500Y+250D03*
X+1500Y-3000D03*
X-500Y+1750D03*
X+3266Y+500D03*
X-1993Y+3504D03*
X-1635Y+4678D03*
X-500Y-250D03*
X-2996Y+3403D03*
X-3672Y-38D03*
X-1189Y-2060D03*
X-5790Y-4220D03*
X-5681Y+3160D03*
X+10704Y+5241D03*
X+10693Y+4079D03*
X+1750Y+3000D03*
X-4710Y-2739D03*
X+2011Y+534D03*
X-7795Y+2861D03*
G54D14*
X-11344Y+6530D03*
X+11883Y+6530D03*
X-11344Y-6855D03*
X+11883Y-6855D03*
G54D35*
X+3110Y+5733D03*
X+3110Y+4733D03*
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
