albaniac/Teplica/Proteus TeplicaMotor/TeplicaMotor2/TeplicaMotor2 - CADCAM Top Solder Resist.TXT

G04 PROTEUS RS274X GERBER FILE*
%FSLAX24Y24*%
%MOIN*%
%ADD26C,0.0500*%
%ADD27C,0.1400*%
%ADD28R,0.0550X0.0600*%
%ADD22C,0.0800*%
%ADD15C,0.1200*%
%ADD29C,0.1100*%
%ADD19R,0.0370X0.0570*%
%ADD72R,0.0600X0.0700*%
%ADD73R,0.1000X0.1000*%
%ADD30C,0.2900*%
%ADD31C,0.1500*%
%ADD21R,0.0830X0.0830*%
%ADD23C,0.0080*%
G54D26*
X-32440Y+2598D03*
X-33807Y+13836D03*
X-34308Y+16568D03*
X-32750Y+16250D03*
X-28385Y+9330D03*
X-31496Y+8385D03*
X-35108Y+16635D03*
X-34212Y+2755D03*
X-34629Y+10192D03*
X-35633Y+6714D03*
X-35393Y+2362D03*
X-31000Y+7559D03*
X-28988Y+9330D03*
X-33000Y+2250D03*
X-35000Y+8188D03*
X-33742Y+11132D03*
X-35300Y+13469D03*
X-35270Y+12544D03*
G54D27*
X-22670Y+5834D03*
X-22670Y+1110D03*
X-23457Y+3472D03*
X-17867Y+5834D03*
X-17867Y+1110D03*
G54D28*
X-35039Y+472D03*
X-34669Y+1222D03*
X-35409Y+1222D03*
G54D22*
X-29717Y+4383D03*
X-29245Y+3438D03*
X-28796Y+4383D03*
X-28339Y+3438D03*
G54D15*
X-31331Y+2297D03*
X-26725Y+2336D03*
G54D27*
X-22658Y+12488D03*
X-22658Y+7763D03*
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
