albaniac/Teplica/Proteus Teplitca2/GERBER/Teplitca2_1 - CADCAM Top Solder Resist.TXT

G04 PROTEUS RS274X GERBER FILE*
%FSLAX24Y24*%
%MOIN*%
%ADD41C,0.0500*%
%ADD42R,0.1000X0.1000*%
%ADD43C,0.1780*%
%ADD44C,0.1300*%
%ADD20C,0.1320*%
%ADD45C,0.0800*%
%ADD46C,0.2100*%
%ADD23R,0.0570X0.0370*%
%ADD47R,0.0600X0.0550*%
%ADD25R,0.0370X0.0570*%
%ADD48C,0.1500*%
%ADD27R,0.0430X0.0650*%
%ADD28R,0.0650X0.0430*%
%ADD49R,0.0700X0.0600*%
%ADD50R,0.0600X0.0700*%
%ADD73R,0.0930X0.0960*%
%ADD30R,0.0960X0.0930*%
%ADD26C,0.1200*%
%ADD51C,0.0900*%
%ADD17C,0.0080*%
G54D41*
X-29000Y+12750D03*
X-32500Y+14250D03*
X-18250Y+8250D03*
X-27500Y+8250D03*
X-40000Y+25750D03*
X-30250Y+25500D03*
X-18000Y+25750D03*
X-14000Y+25750D03*
X-11600Y+24710D03*
X-8250Y+25750D03*
X-5750Y+25500D03*
X-3000Y+25500D03*
X+22500Y+25000D03*
X+25900Y+24740D03*
X+27990Y+24720D03*
X-47000Y+17250D03*
X-45730Y+7740D03*
X+40750Y+25500D03*
X+42000Y+25750D03*
X+12750Y-20250D03*
X+41250Y-2750D03*
X+24500Y+2250D03*
X+36260Y-7760D03*
X+26500Y-11000D03*
X+26500Y-27000D03*
X+29500Y-15250D03*
X-30250Y+14250D03*
X-28250Y+1750D03*
X-23000Y+1750D03*
X-40000Y+17250D03*
X-22250Y+9250D03*
X+42610Y+12250D03*
X+21750Y-10907D03*
X-49750Y+7000D03*
X+20500Y-16000D03*
X+33000Y+27250D03*
X+16250Y+21500D03*
X+33000Y+21500D03*
X+35500Y+26750D03*
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
