albaniac/Teplica/Proteus TeplicaMotor/Gerber/TeplicaMotor1 - CADCAM Bottom Solder Resist.TXT

G04 PROTEUS RS274X GERBER FILE*
%FSLAX24Y24*%
%MOIN*%
%ADD27C,0.0500*%
%ADD28C,0.1400*%
%ADD72C,0.0800*%
%ADD73C,0.1100*%
%ADD31R,0.1000X0.1000*%
%ADD19C,0.0600*%
%ADD32C,0.2900*%
%ADD24C,0.0700*%
%ADD33C,0.1500*%
%ADD25C,0.0080*%
G54D27*
X-31000Y+6000D03*
X-31000Y+12250D03*
X-33000Y+11750D03*
X-34000Y+11750D03*
X-35000Y+9500D03*
X-30500Y+1250D03*
X-30250Y+10500D03*
X-32750Y+16250D03*
X-32750Y+13000D03*
X-30250Y+12500D03*
X-33250Y+10000D03*
X-33250Y+9000D03*
X-35250Y+15000D03*
X-32000Y+5250D03*
X-35314Y+4830D03*
X-35500Y+4000D03*
X-37145Y+9645D03*
X-28500Y+9250D03*
X-33500Y+10500D03*
X-26750Y+13500D03*
X-26750Y+4250D03*
X-33500Y+3500D03*
X-33582Y+17952D03*
X-13140Y+13550D03*
G54D28*
X-22670Y+5834D03*
X-22670Y+1110D03*
X-23457Y+3472D03*
X-17867Y+5834D03*
X-17867Y+1110D03*
G54D72*
X-28289Y+14108D03*
X-28762Y+15053D03*
X-29211Y+14108D03*
X-29667Y+15053D03*
G54D28*
X-26675Y+16194D03*
X-31281Y+16155D03*
X-22658Y+12488D03*
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
