albaniac/Teplica/Proteus Teplitca1/GERBER/Teplitca1_1 - CADCAM Top Solder Resist.TXT

G04 PROTEUS RS274X GERBER FILE*
%FSLAX24Y24*%
%MOIN*%
%ADD22C,0.0500*%
%ADD45R,0.1000X0.1000*%
%ADD46C,0.1780*%
%ADD47C,0.1300*%
%ADD48R,0.0700X0.0700*%
%ADD36C,0.0700*%
%ADD23C,0.1320*%
%ADD49C,0.0800*%
%ADD50C,0.2100*%
%ADD51C,0.1100*%
%ADD27R,0.0570X0.0370*%
%ADD28R,0.0370X0.0570*%
%ADD52R,0.0600X0.0700*%
%ADD53R,0.0700X0.0600*%
%ADD54R,0.0600X0.0550*%
%ADD55R,0.1000X0.0450*%
%ADD56C,0.1500*%
%ADD32R,0.0330X0.0200*%
%ADD33R,0.0200X0.0330*%
%ADD34R,0.0930X0.0960*%
%ADD35R,0.0960X0.0930*%
%ADD57C,0.1400*%
%ADD26C,0.0900*%
%ADD18C,0.0080*%
G54D22*
X-41000Y+37500D03*
X-35500Y+38500D03*
X-33500Y+38250D03*
X-29500Y+38000D03*
X-27500Y+38000D03*
X-23750Y+37750D03*
X-18250Y+36500D03*
X-13500Y+38500D03*
X-11500Y+37750D03*
X-5500Y+37750D03*
X+10500Y+38000D03*
X+13750Y+38000D03*
X-45000Y+35250D03*
X-46750Y+32500D03*
X-47500Y+28000D03*
X-48000Y+25000D03*
X-46000Y+21500D03*
X-46250Y+18750D03*
X-47140Y+11564D03*
X+41328Y+38239D03*
X+47250Y+38500D03*
X-24000Y-18750D03*
X+18250Y-22000D03*
X-53000Y+23000D03*
X-53416Y+27590D03*
X-53468Y+34565D03*
X-53500Y-750D03*
X-11260Y+43780D03*
X+51000Y+1500D03*
X-6250Y+4500D03*
X+25750Y+6250D03*
X-33000Y+250D03*
X-30326Y+8556D03*
X-22159Y+11035D03*
X+37250Y+11250D03*
X+27500Y-27000D03*
X+40328Y+3900D03*
X+41390Y+3500D03*
X+16930Y-11750D03*
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
