albaniac/Teplica/Proteus Teplitca2/Teplitca2_1.PDF

J27
J21

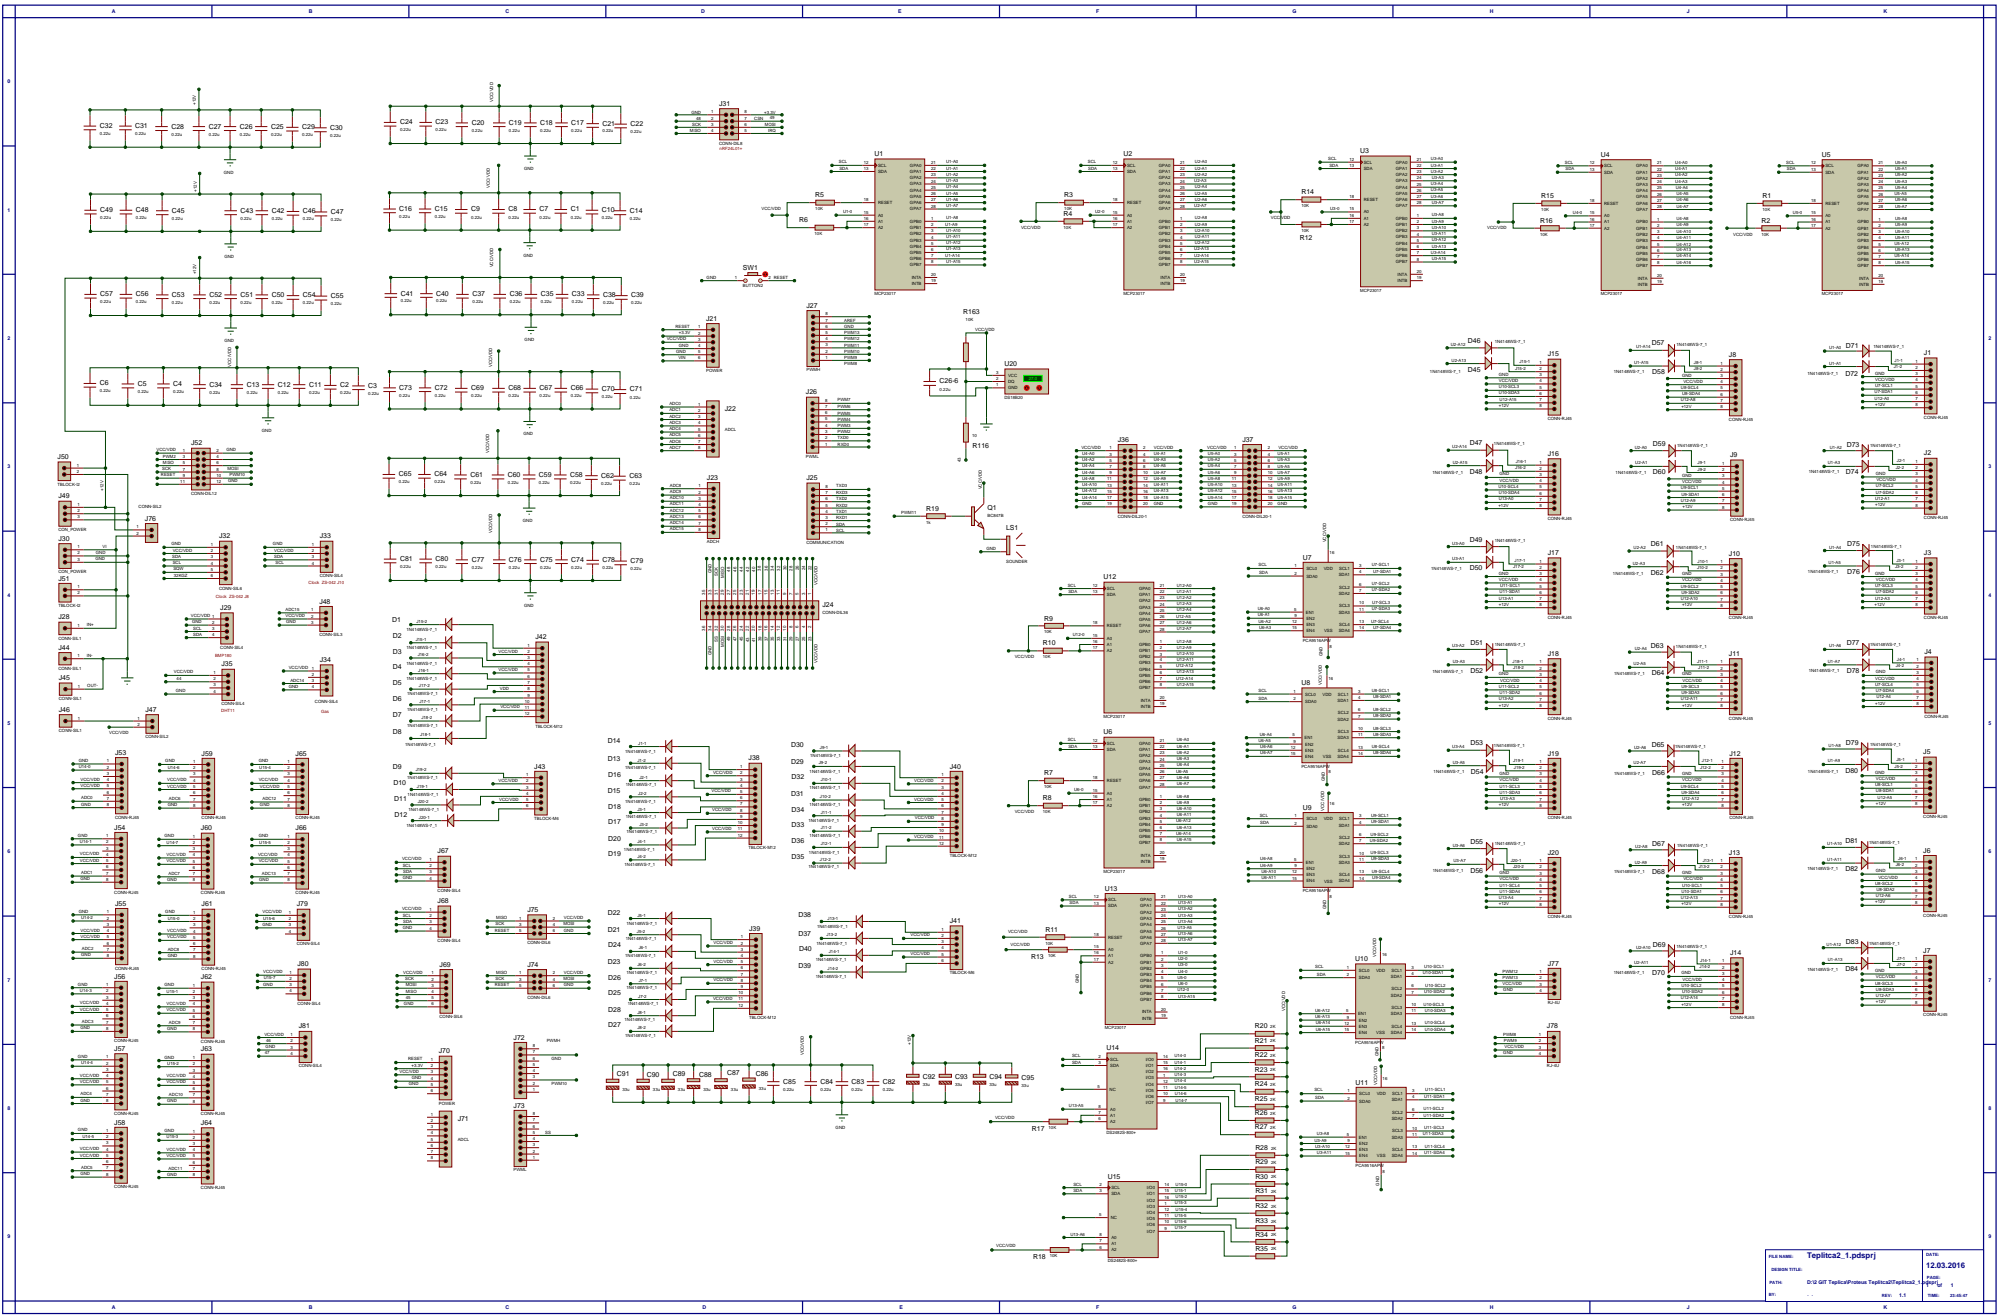
[picture p61: page 1]

VCC/VDD

VCC/VDD VCC/VDD VCC/VDD

VCC/VDD VCC/VDD GND GND
