albaniac/Teplica/ProteusGreenhouseDUE0_1/DOC/New Project.pdf

J5

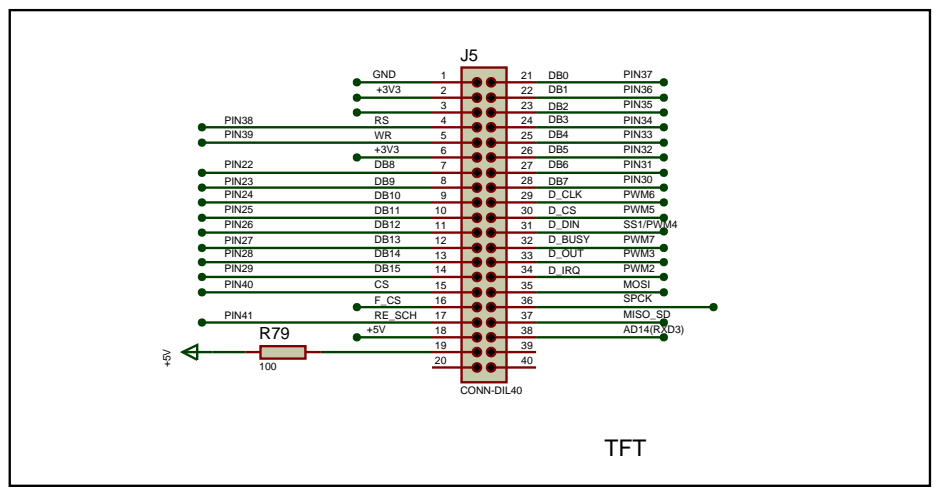
[picture p62: page 1]
GND +3V3; D_CLK; PWM6; PWM5; D_DIN; SS1/PWM4; D_BUSY; PWM7; D_OUT; PWM3; D_IRQ; PWM2; MOSI SPCK MISO_SD AD14(RXD3); PIN37; PIN36; PIN35; PIN34; PIN33; PIN32; PIN31; PIN30; PIN22; PIN23; PIN24; PIN25; PIN26; PIN27; PIN28; PIN29; PIN39; PIN38; PIN40; PIN41; RE_SCH

CONN-DIL40
Разъем TFT дисплея
