albaniac/Teplica/Proteus universal module DUE/Universal controller_SAM3X8E_01.PDF

J11

C7

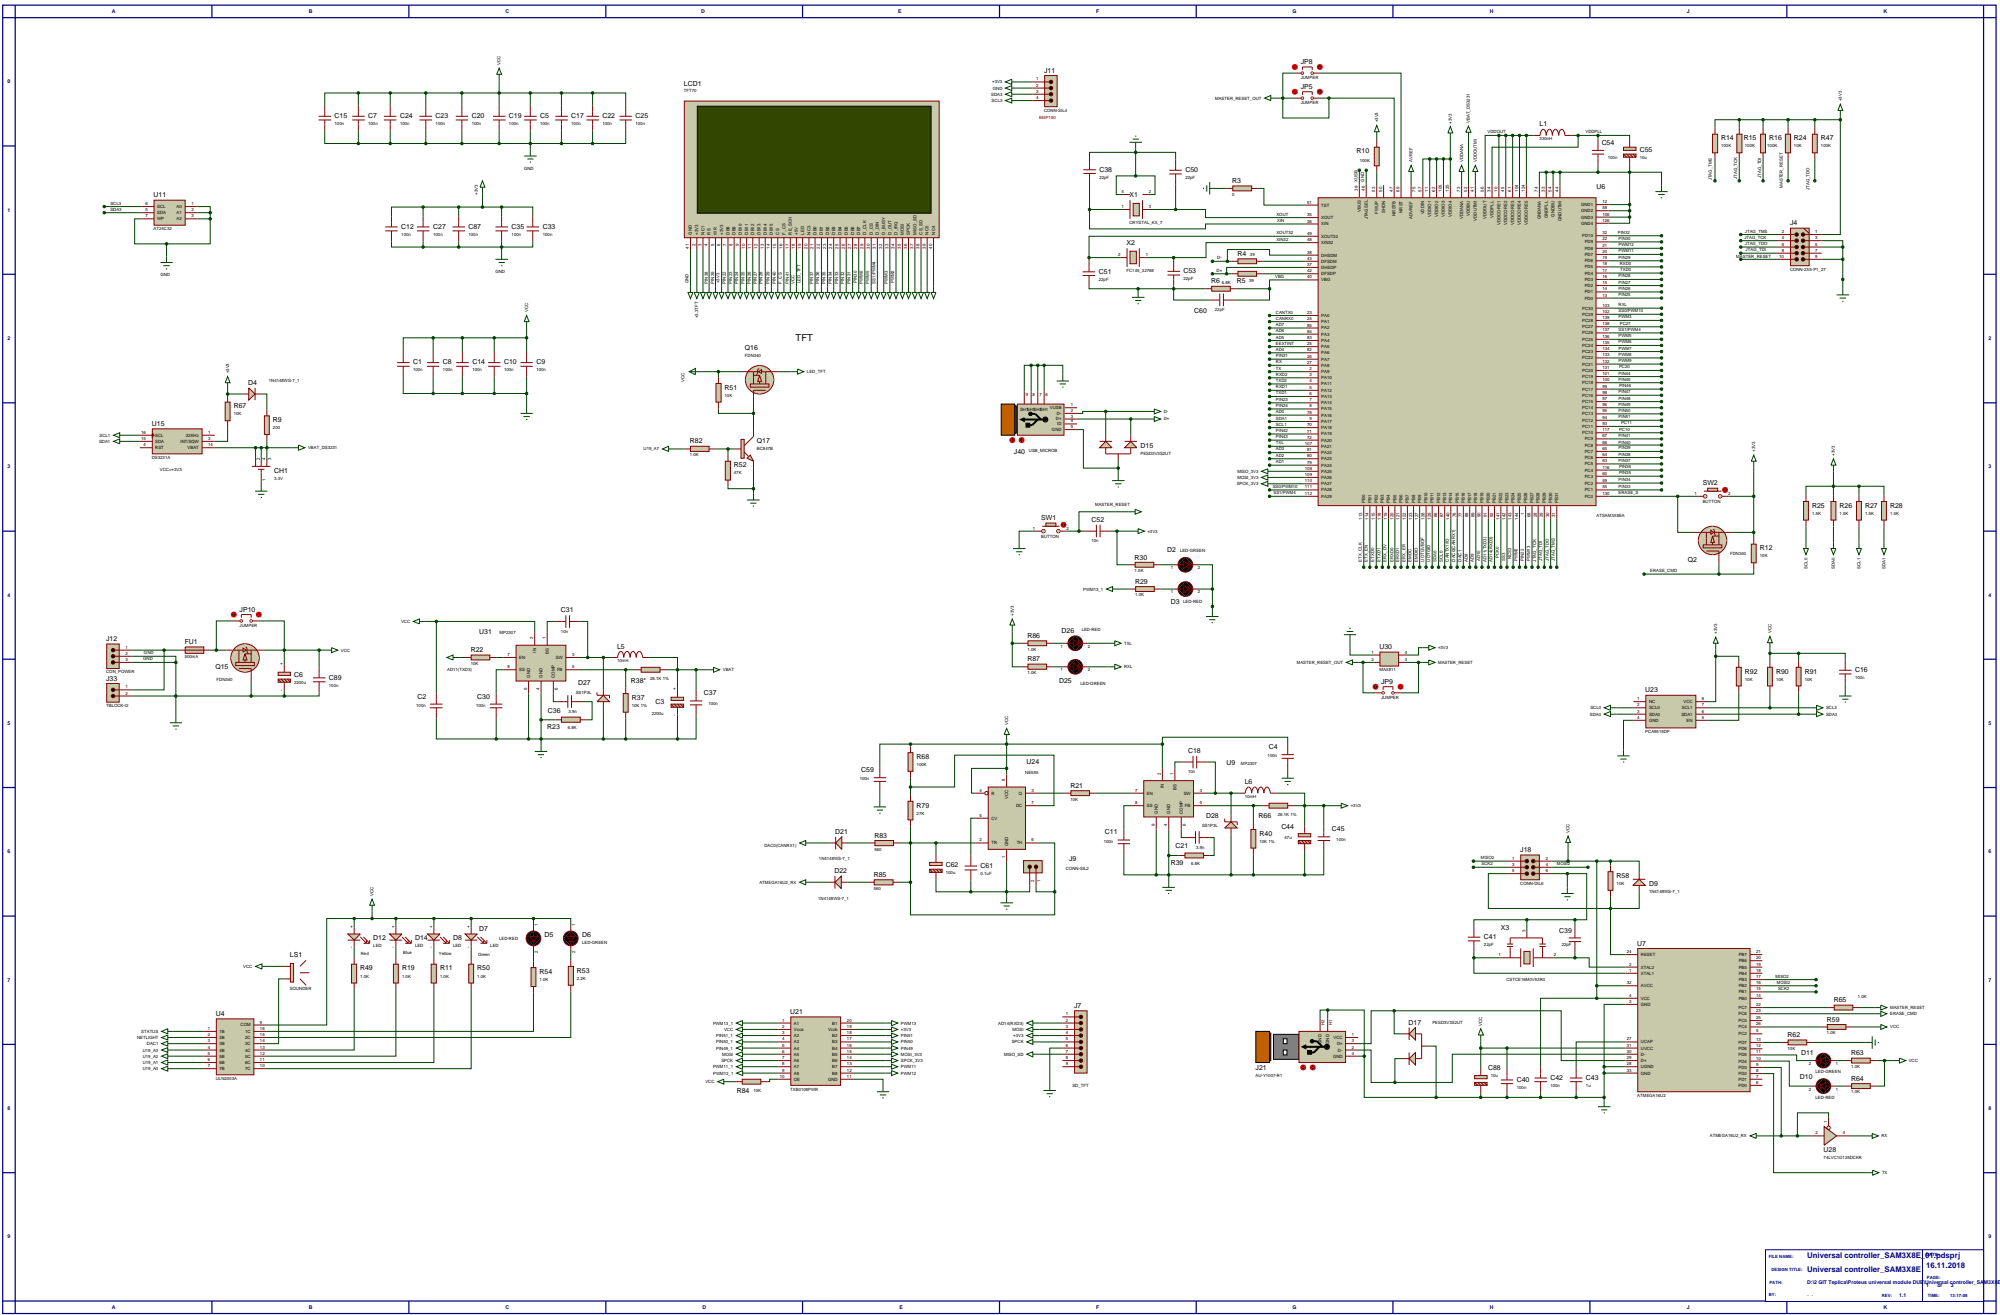
[picture p63: page 1]

R2

R8

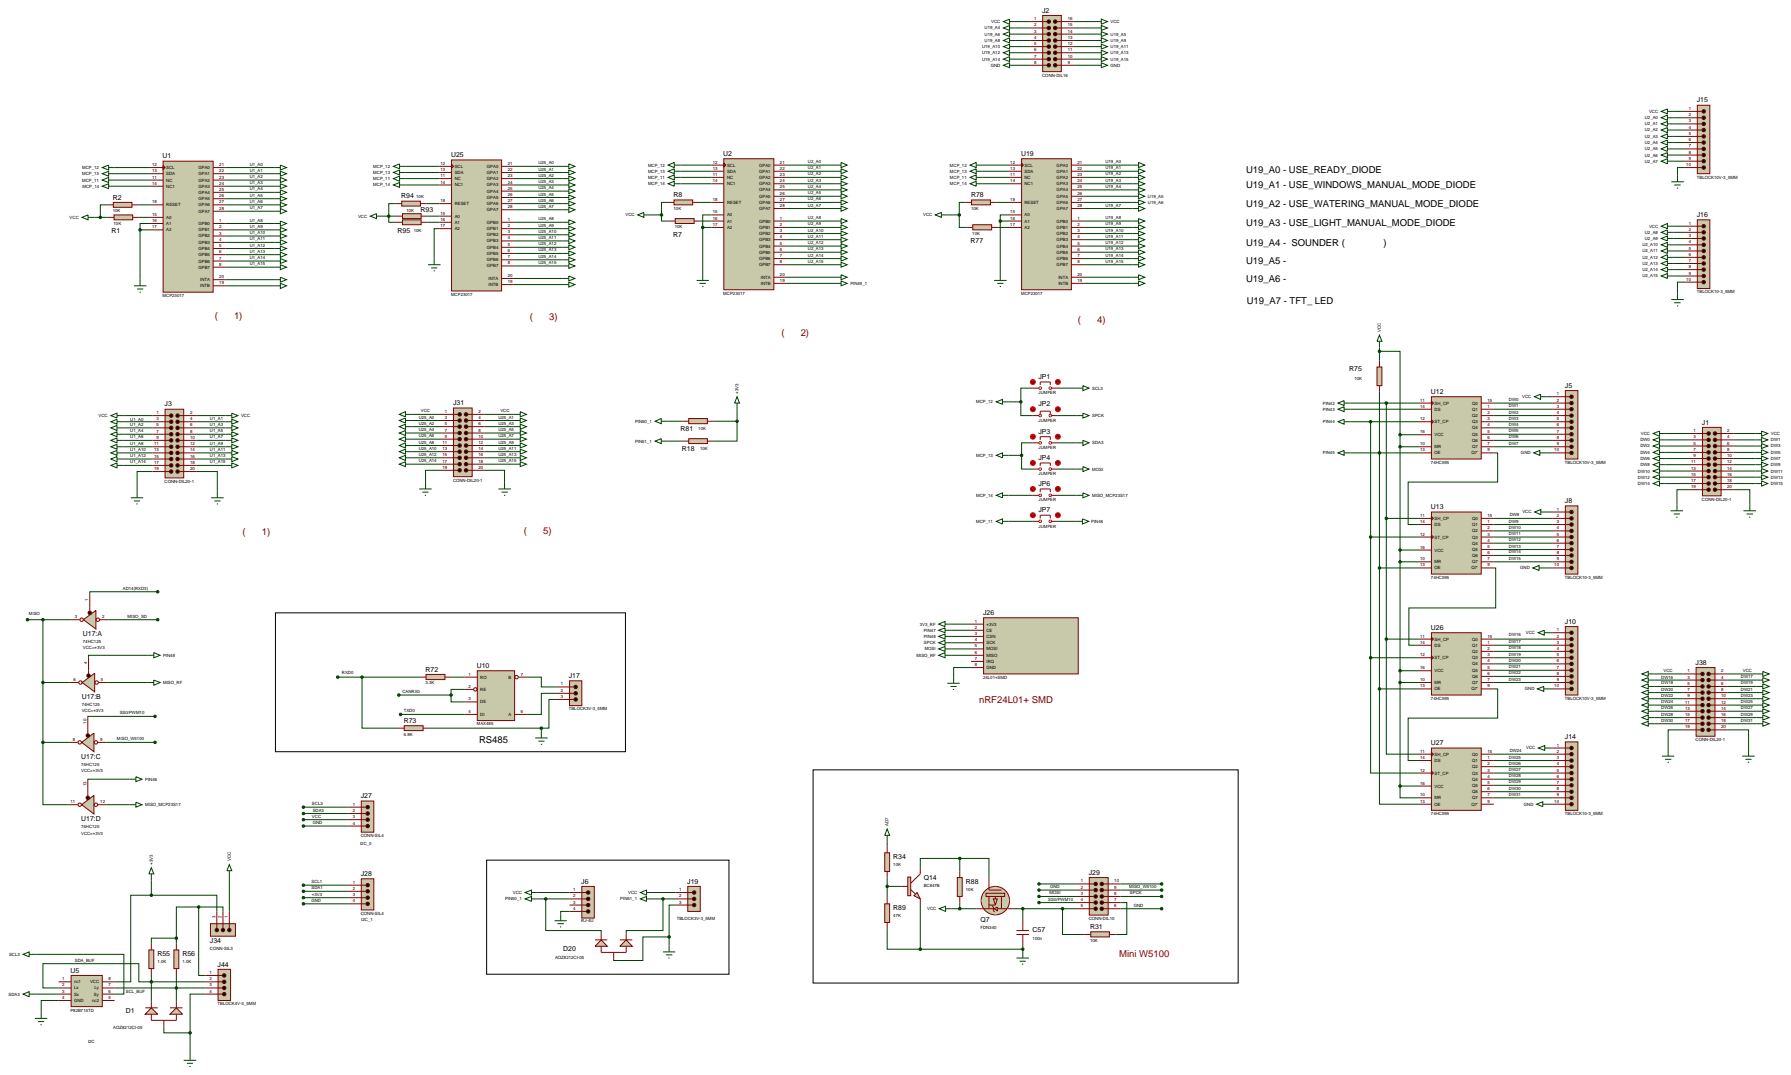
[picture p64: page 2]

на которых висят универсальные модули

C26

C70

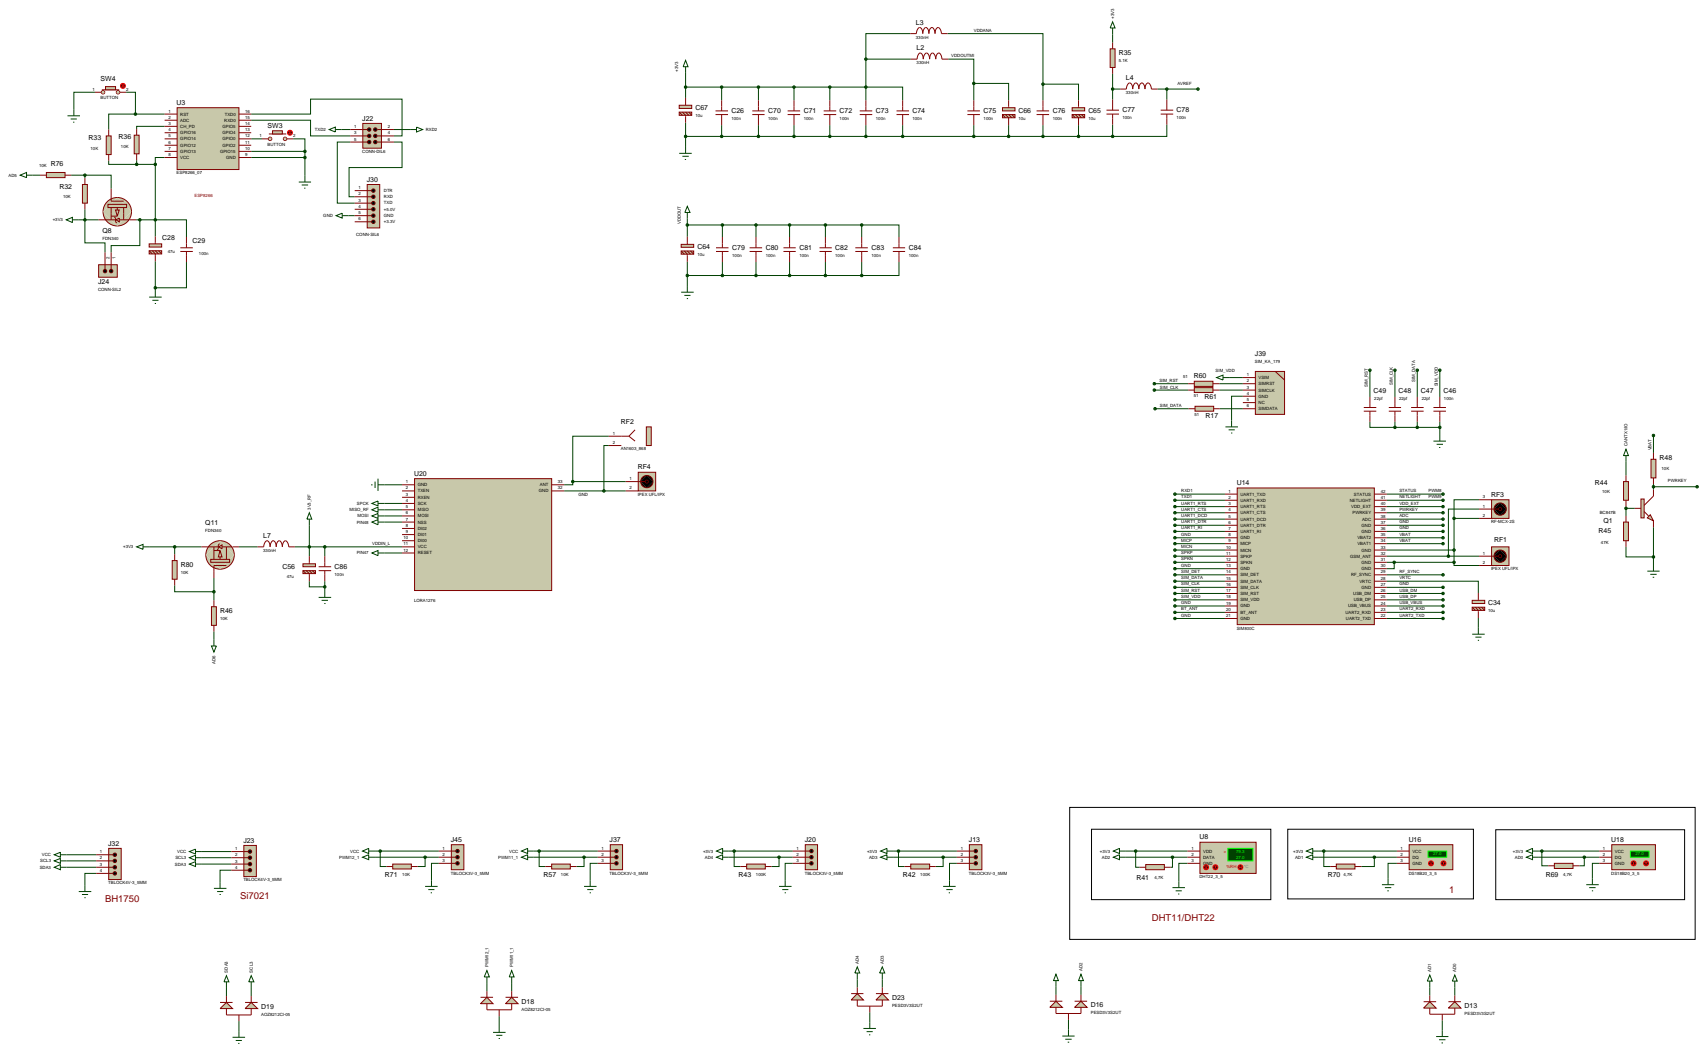
[picture p65: page 3]
