albaniac/Teplica/Port_extender/Port_extender_01.PDF

U2

U3

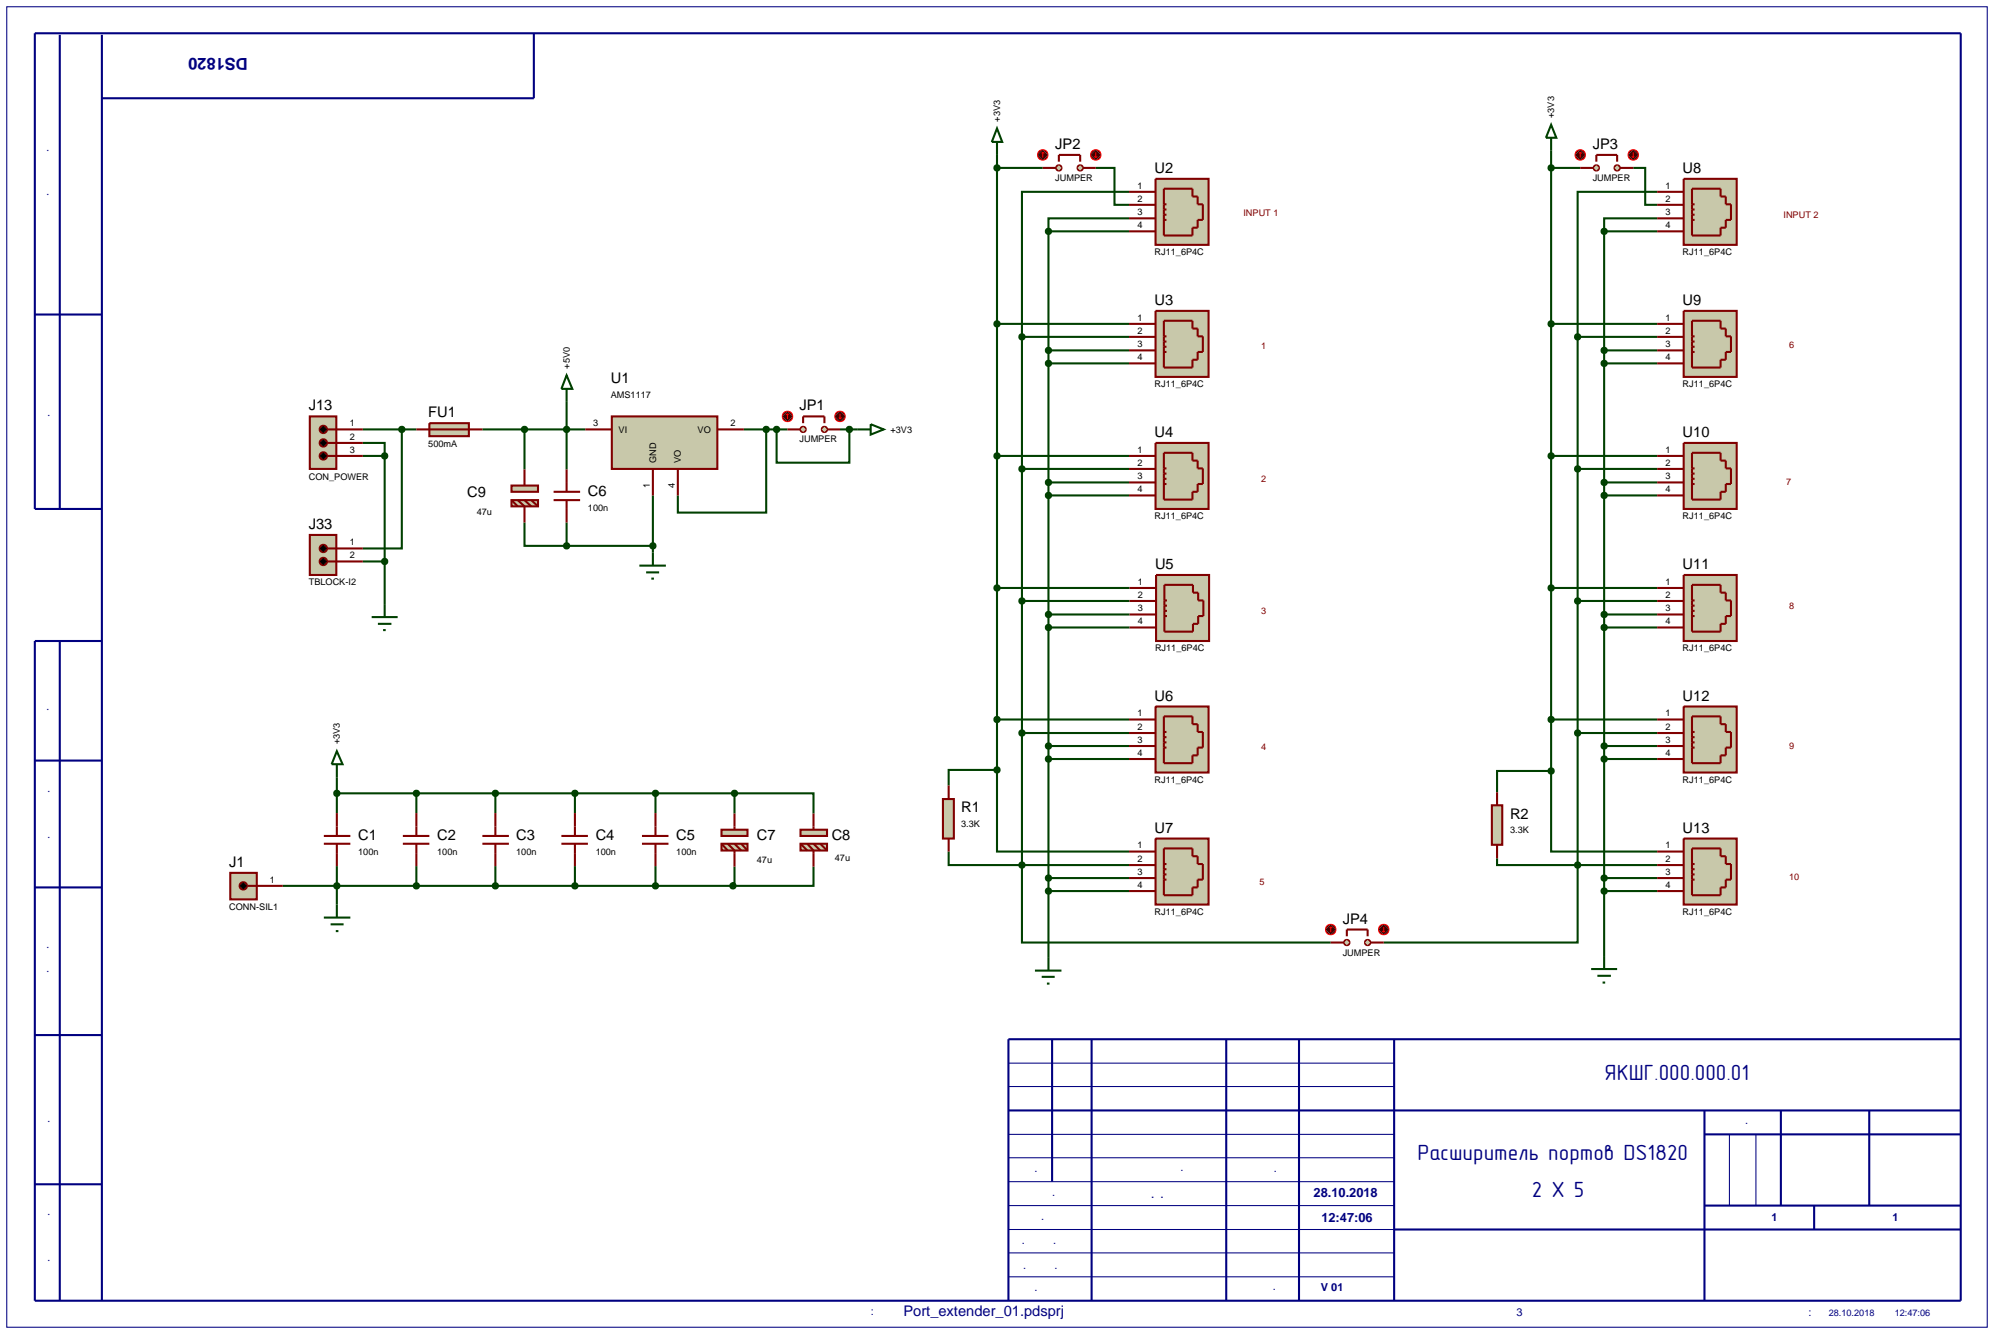
[picture p66: page 1]

Инв. № подл. Подп. и дата Взам. инв. № Инв. № дубл. Справ. № Перв. примен. Подп. и дата

ЯКШГ.000.000.01

Расширитель портов DS1820 2 X 5 | Лит. | Масса | Масштаб

Изм. | Лист | № докум. | Подп. | Дата

Разраб. | | Мосейчук А.В. | | 28.10.2018
Пров. | | | 12:47:06 | | Лист 1 1 | Листов
Т.контр.

Н.контр.
Утв. | | Ревиз. | V 01
