albaniac/Teplica/ProteusGreenhouseDUE_Base_02/GreenhouseDUE_Base_Maxi_R.PDF

J11

C7

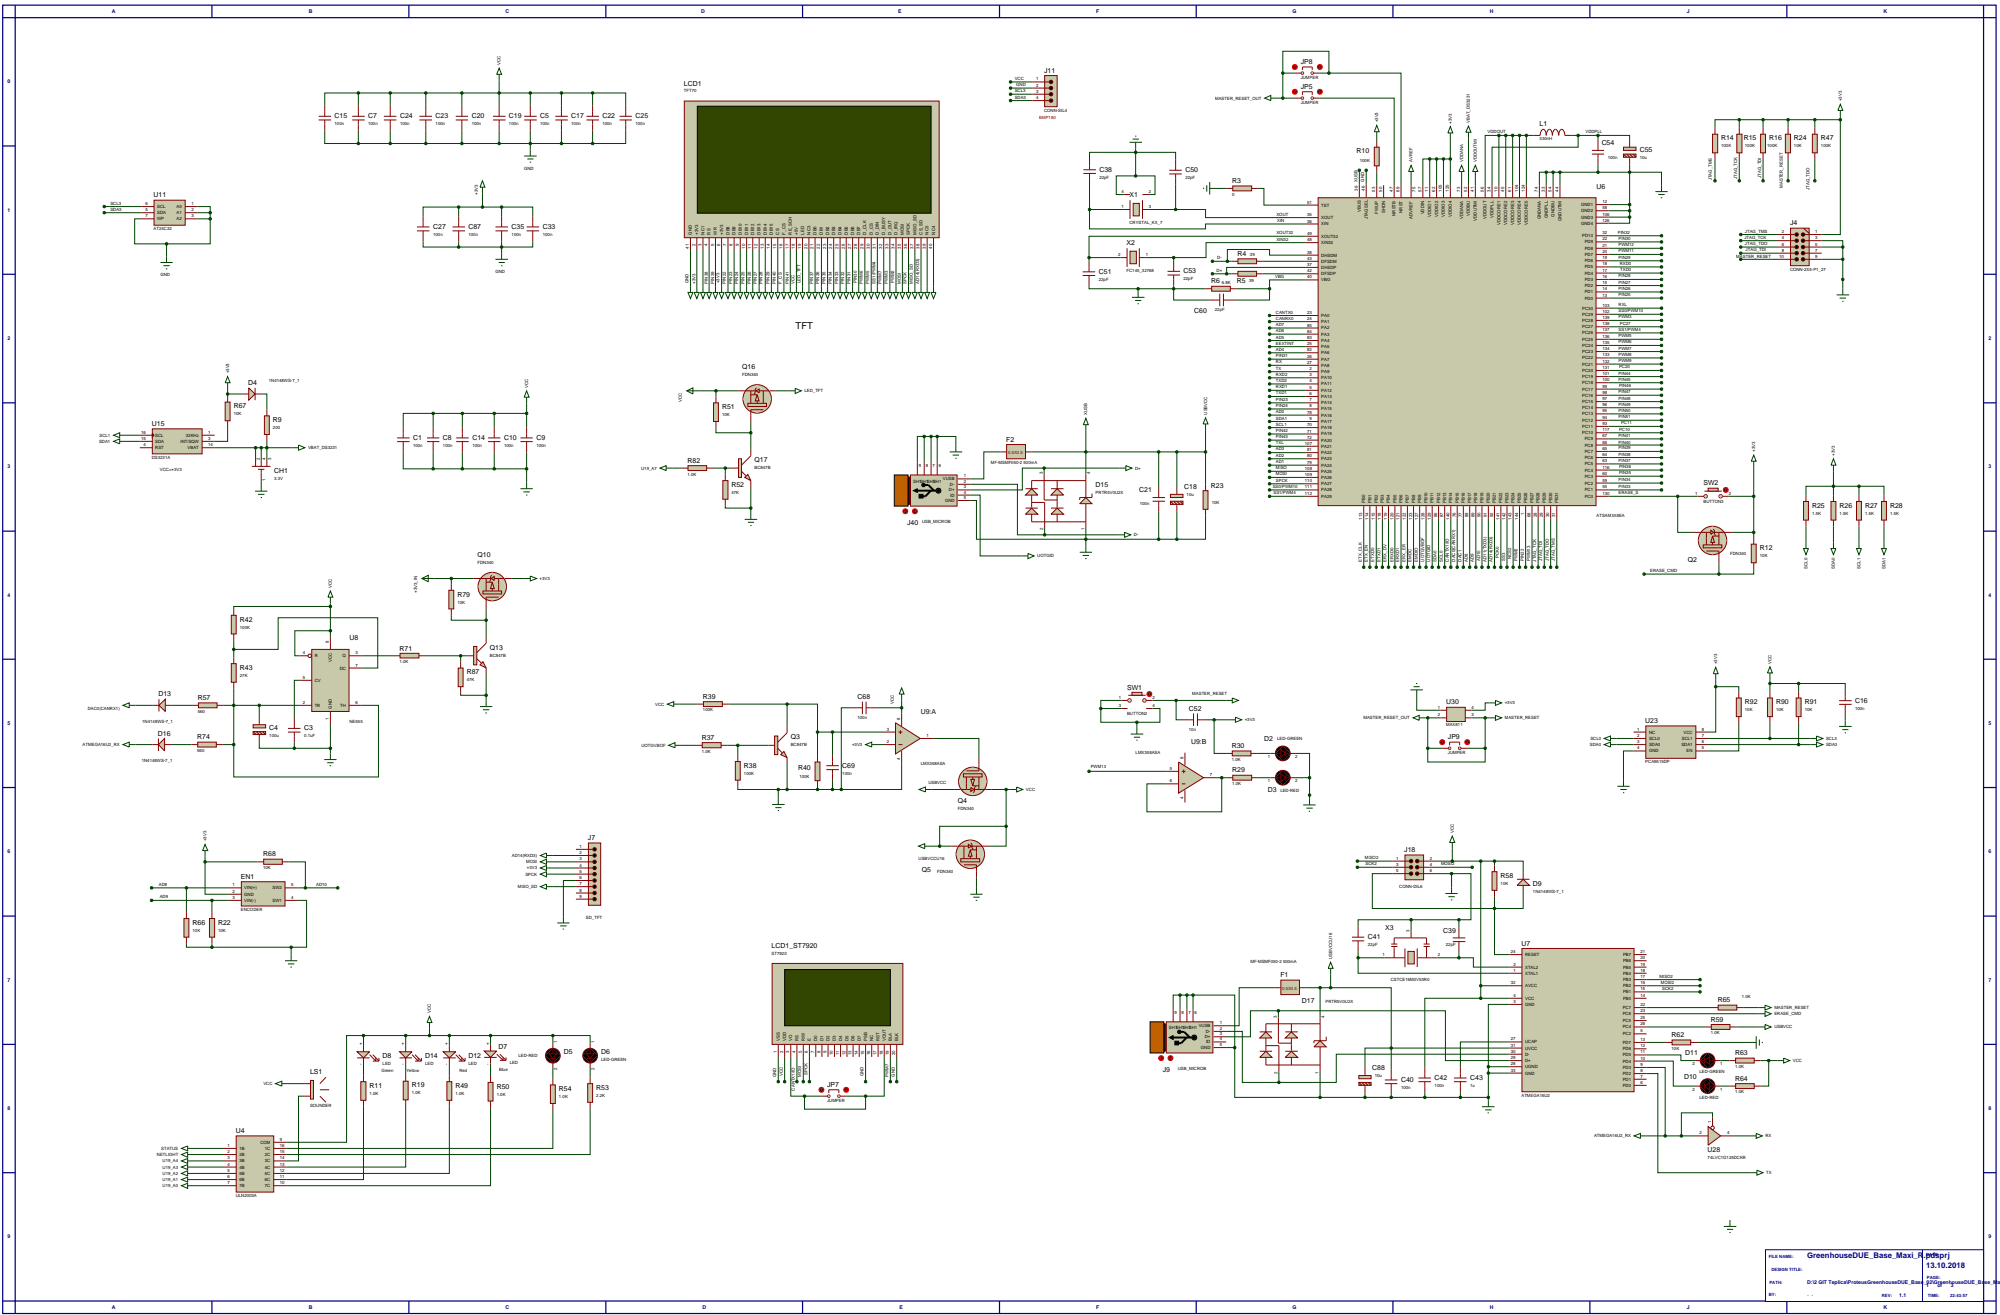
[picture p67: page 1]

J1

J5

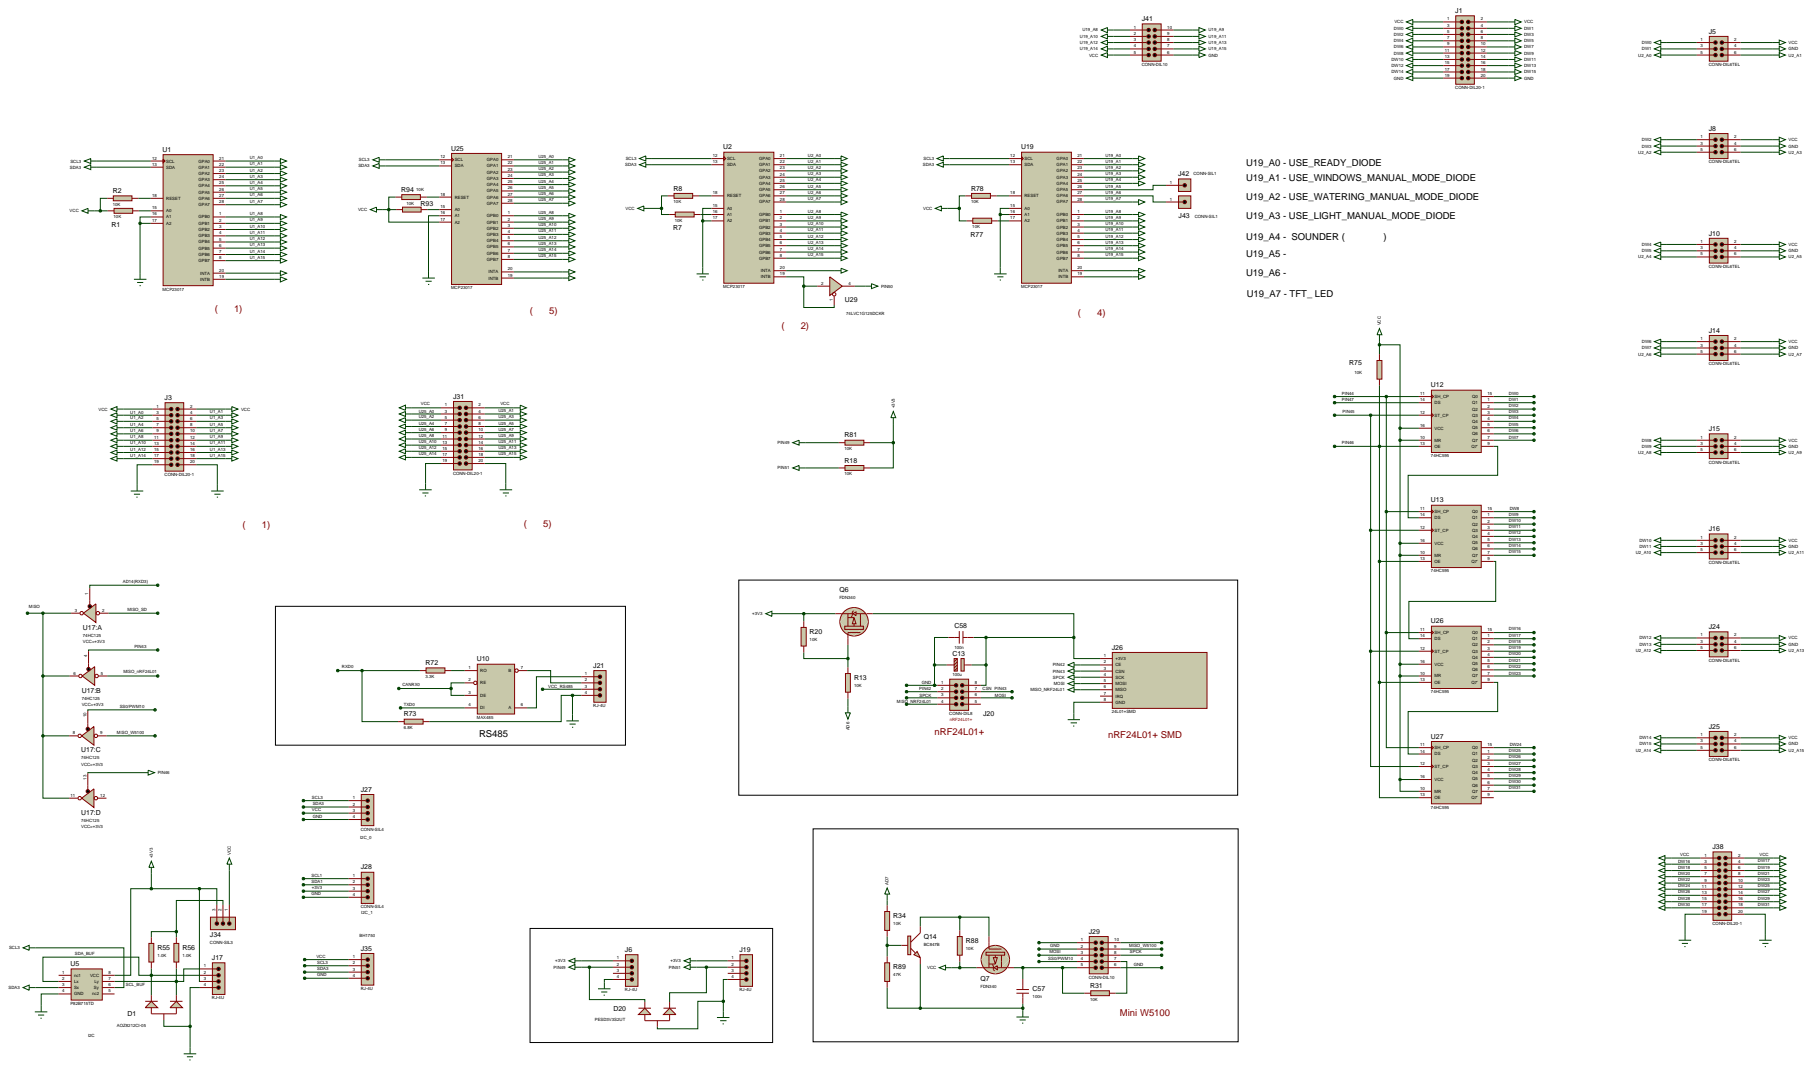
[picture p68: page 2]

на которых висят универсальные модули

C26

C70

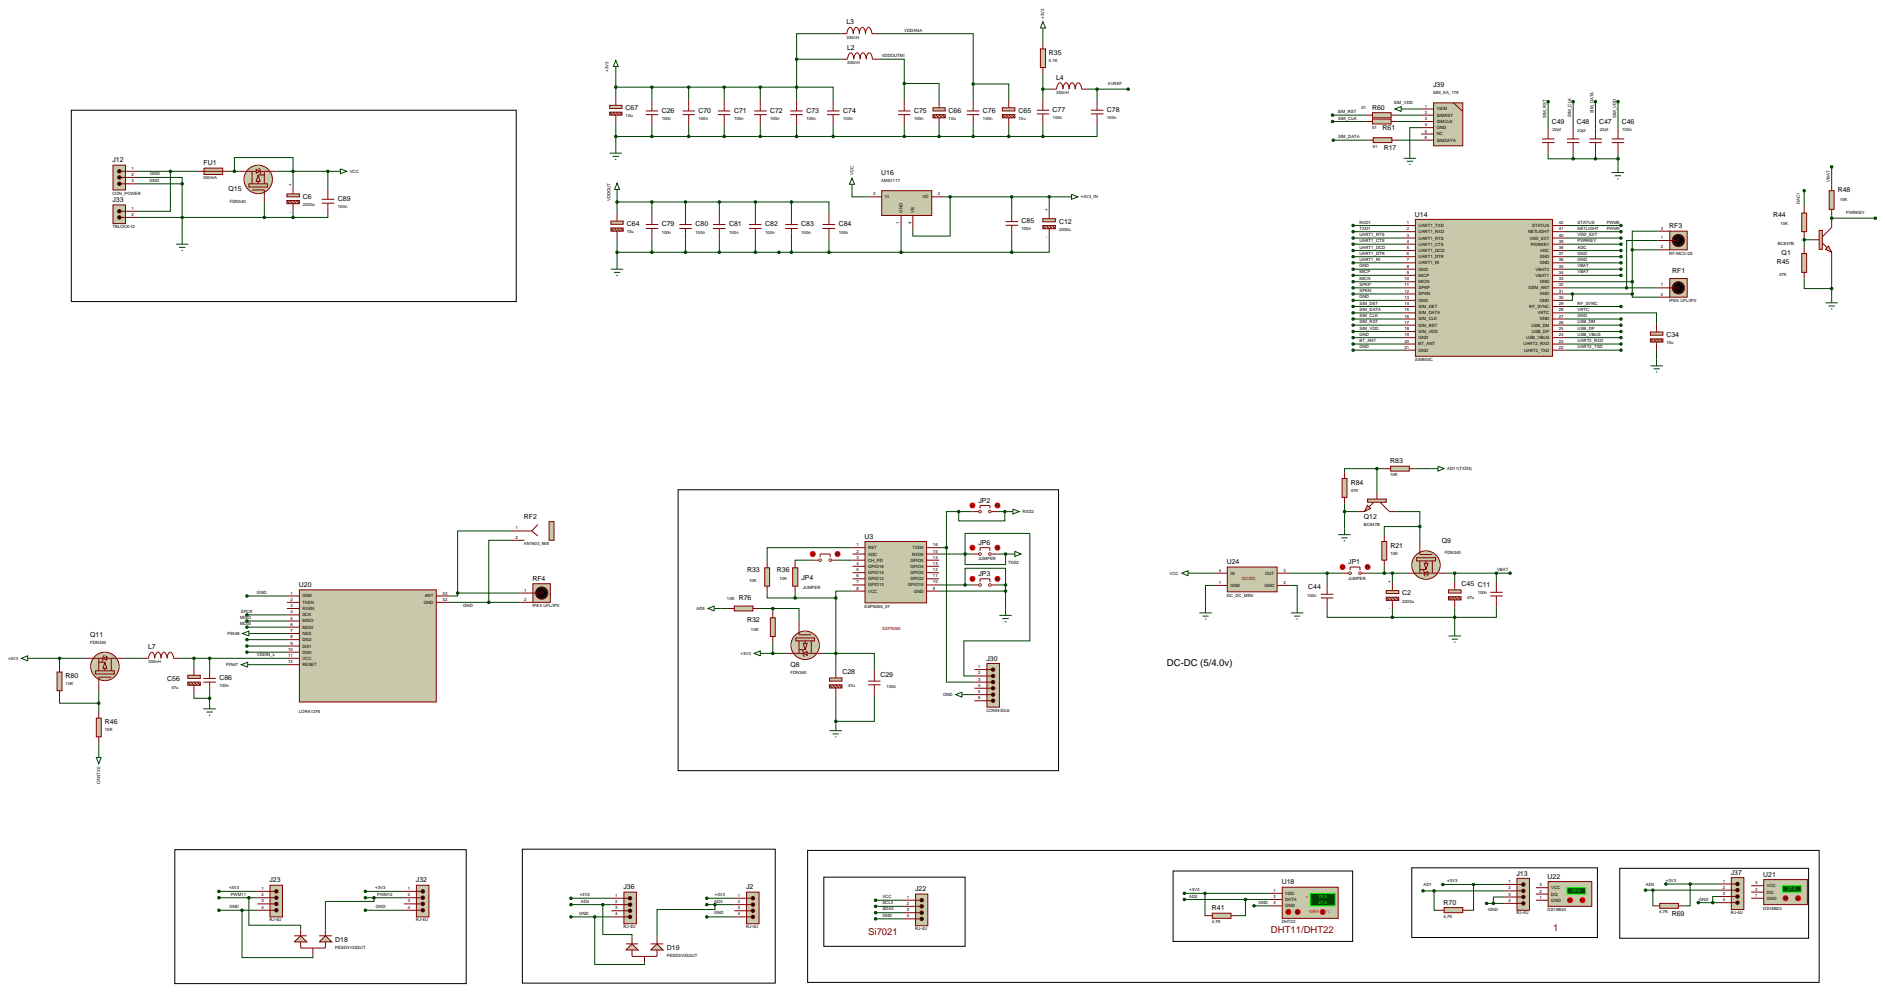
[picture p69: page 3]
