albaniac/Teplica/ProteusGreenhouseDUE_Base_02/GreenhouseDUE_Base_Maxi.PDF

J11

C7

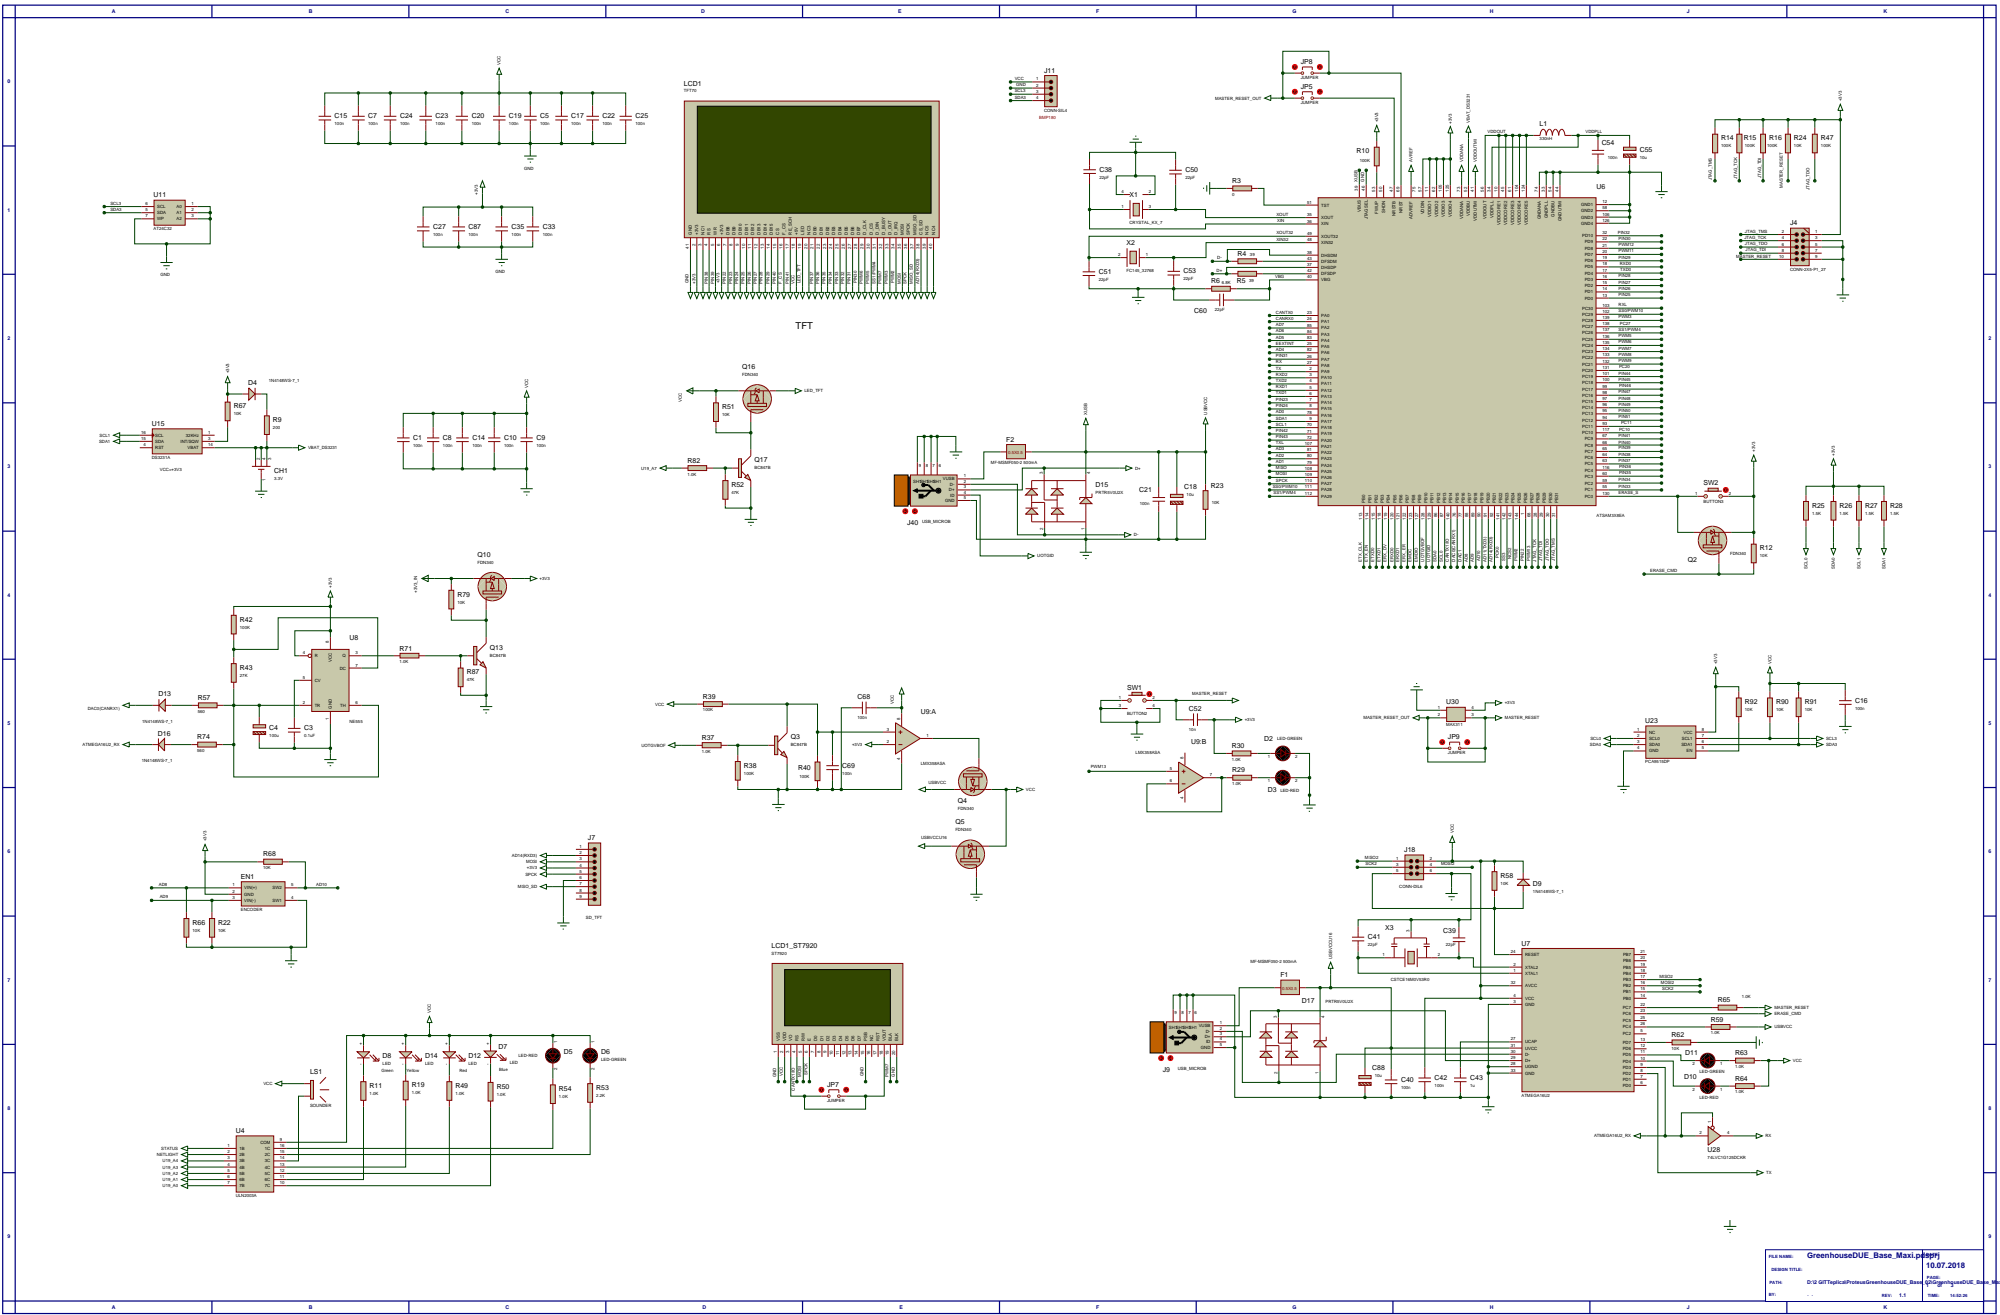
[picture p70: page 1]

J1

J5

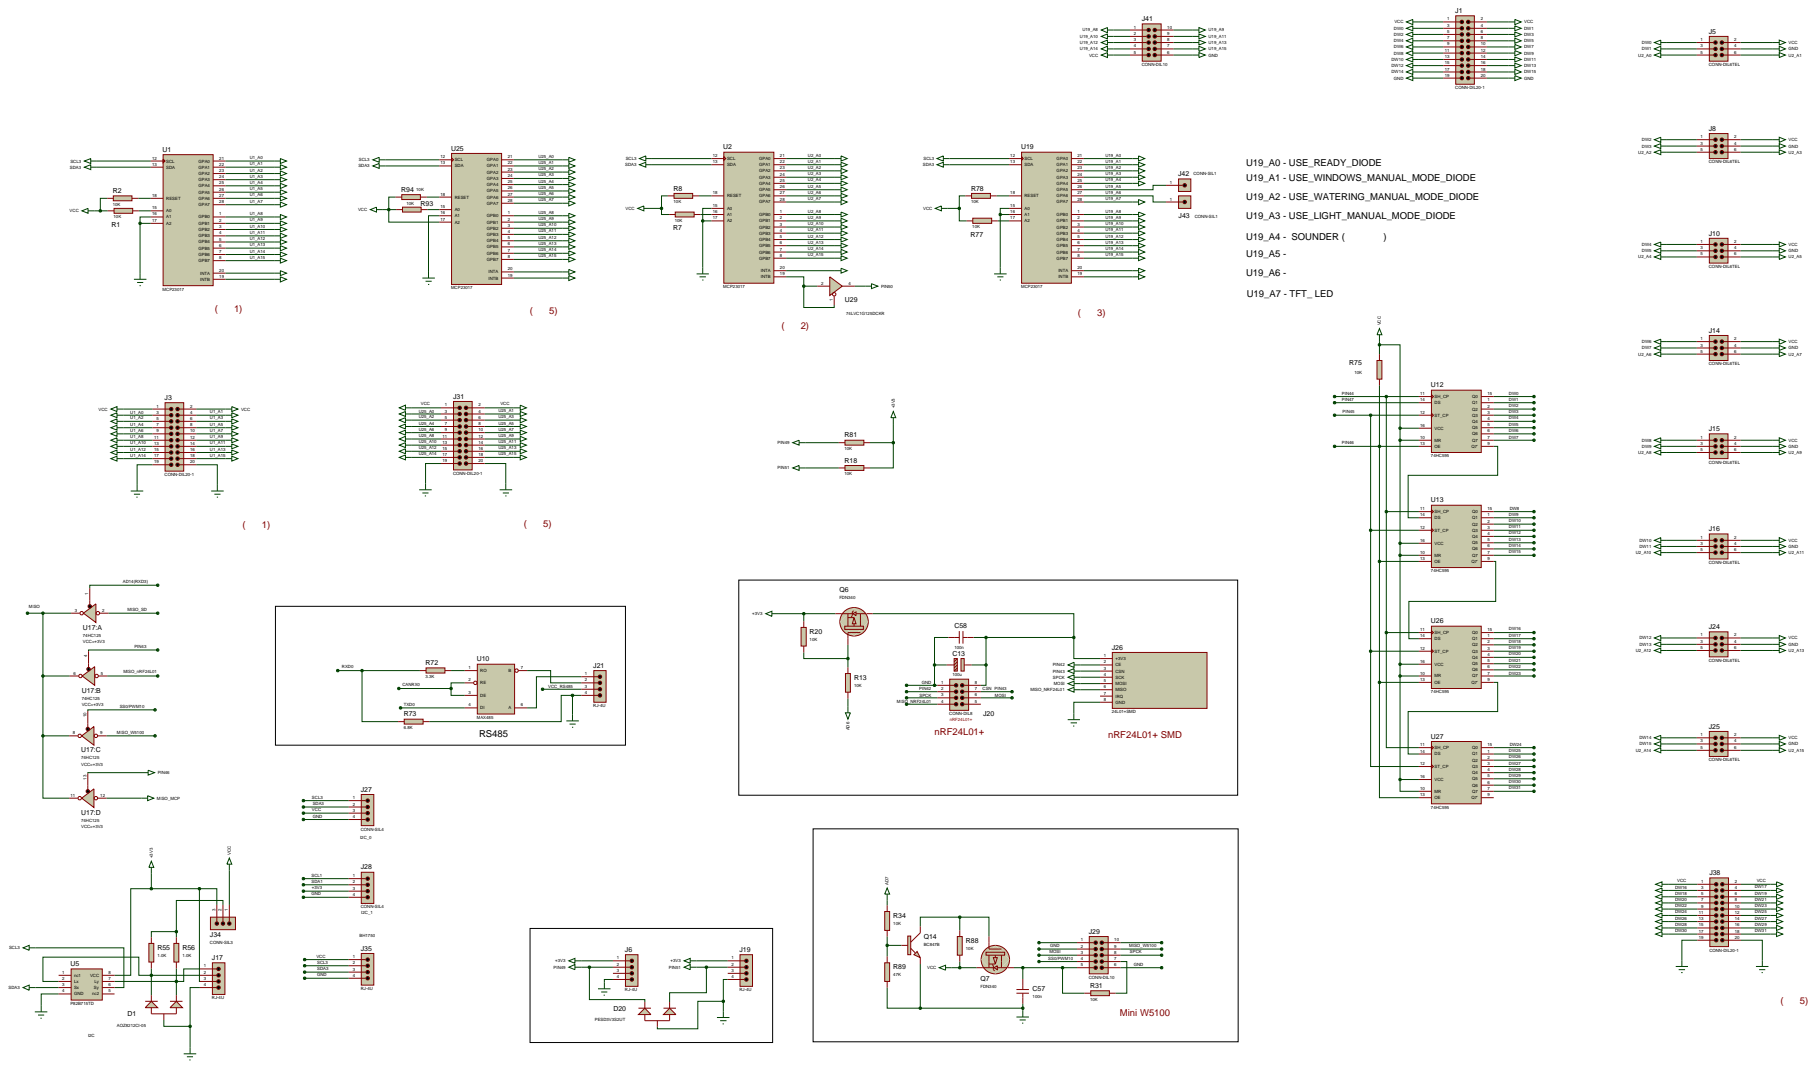
[picture p71: page 2]

на которых висят универсальные модули

C26

C70

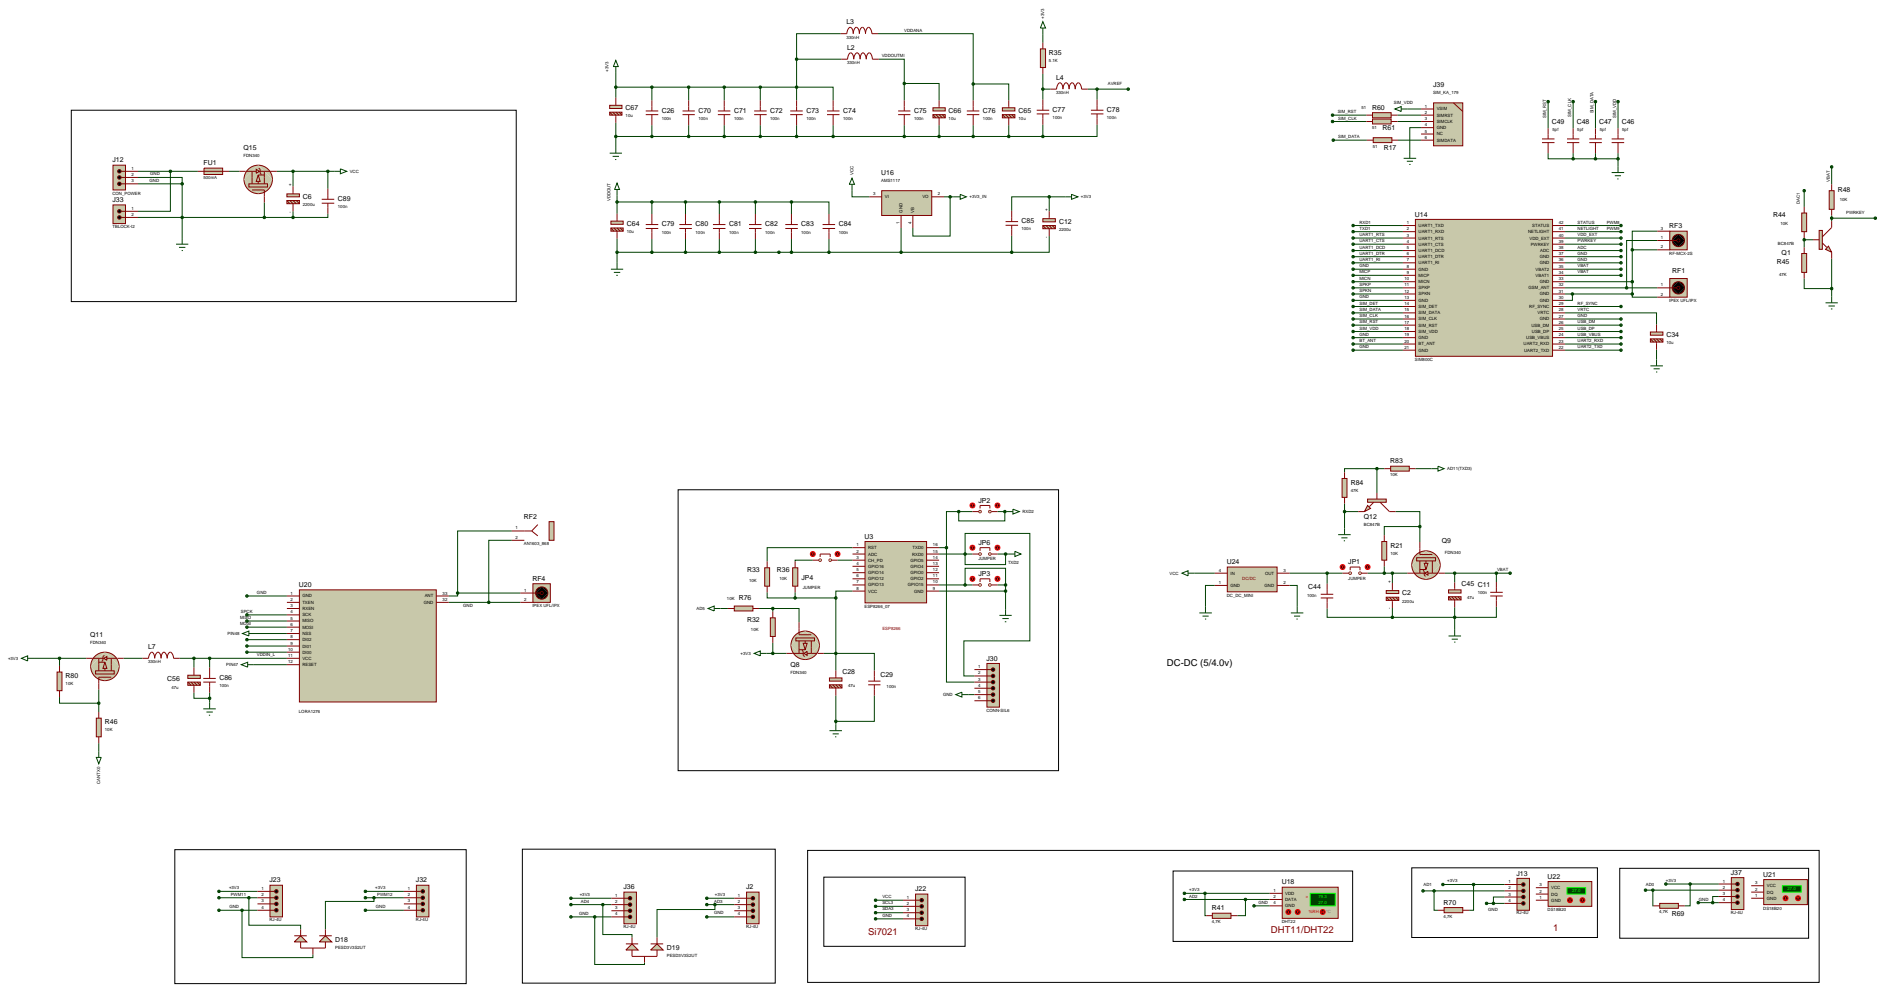
[picture p72: page 3]
