albaniac/Teplica/Внешний сторожевой таймер/NE555_Dog.PDF

U2

R5

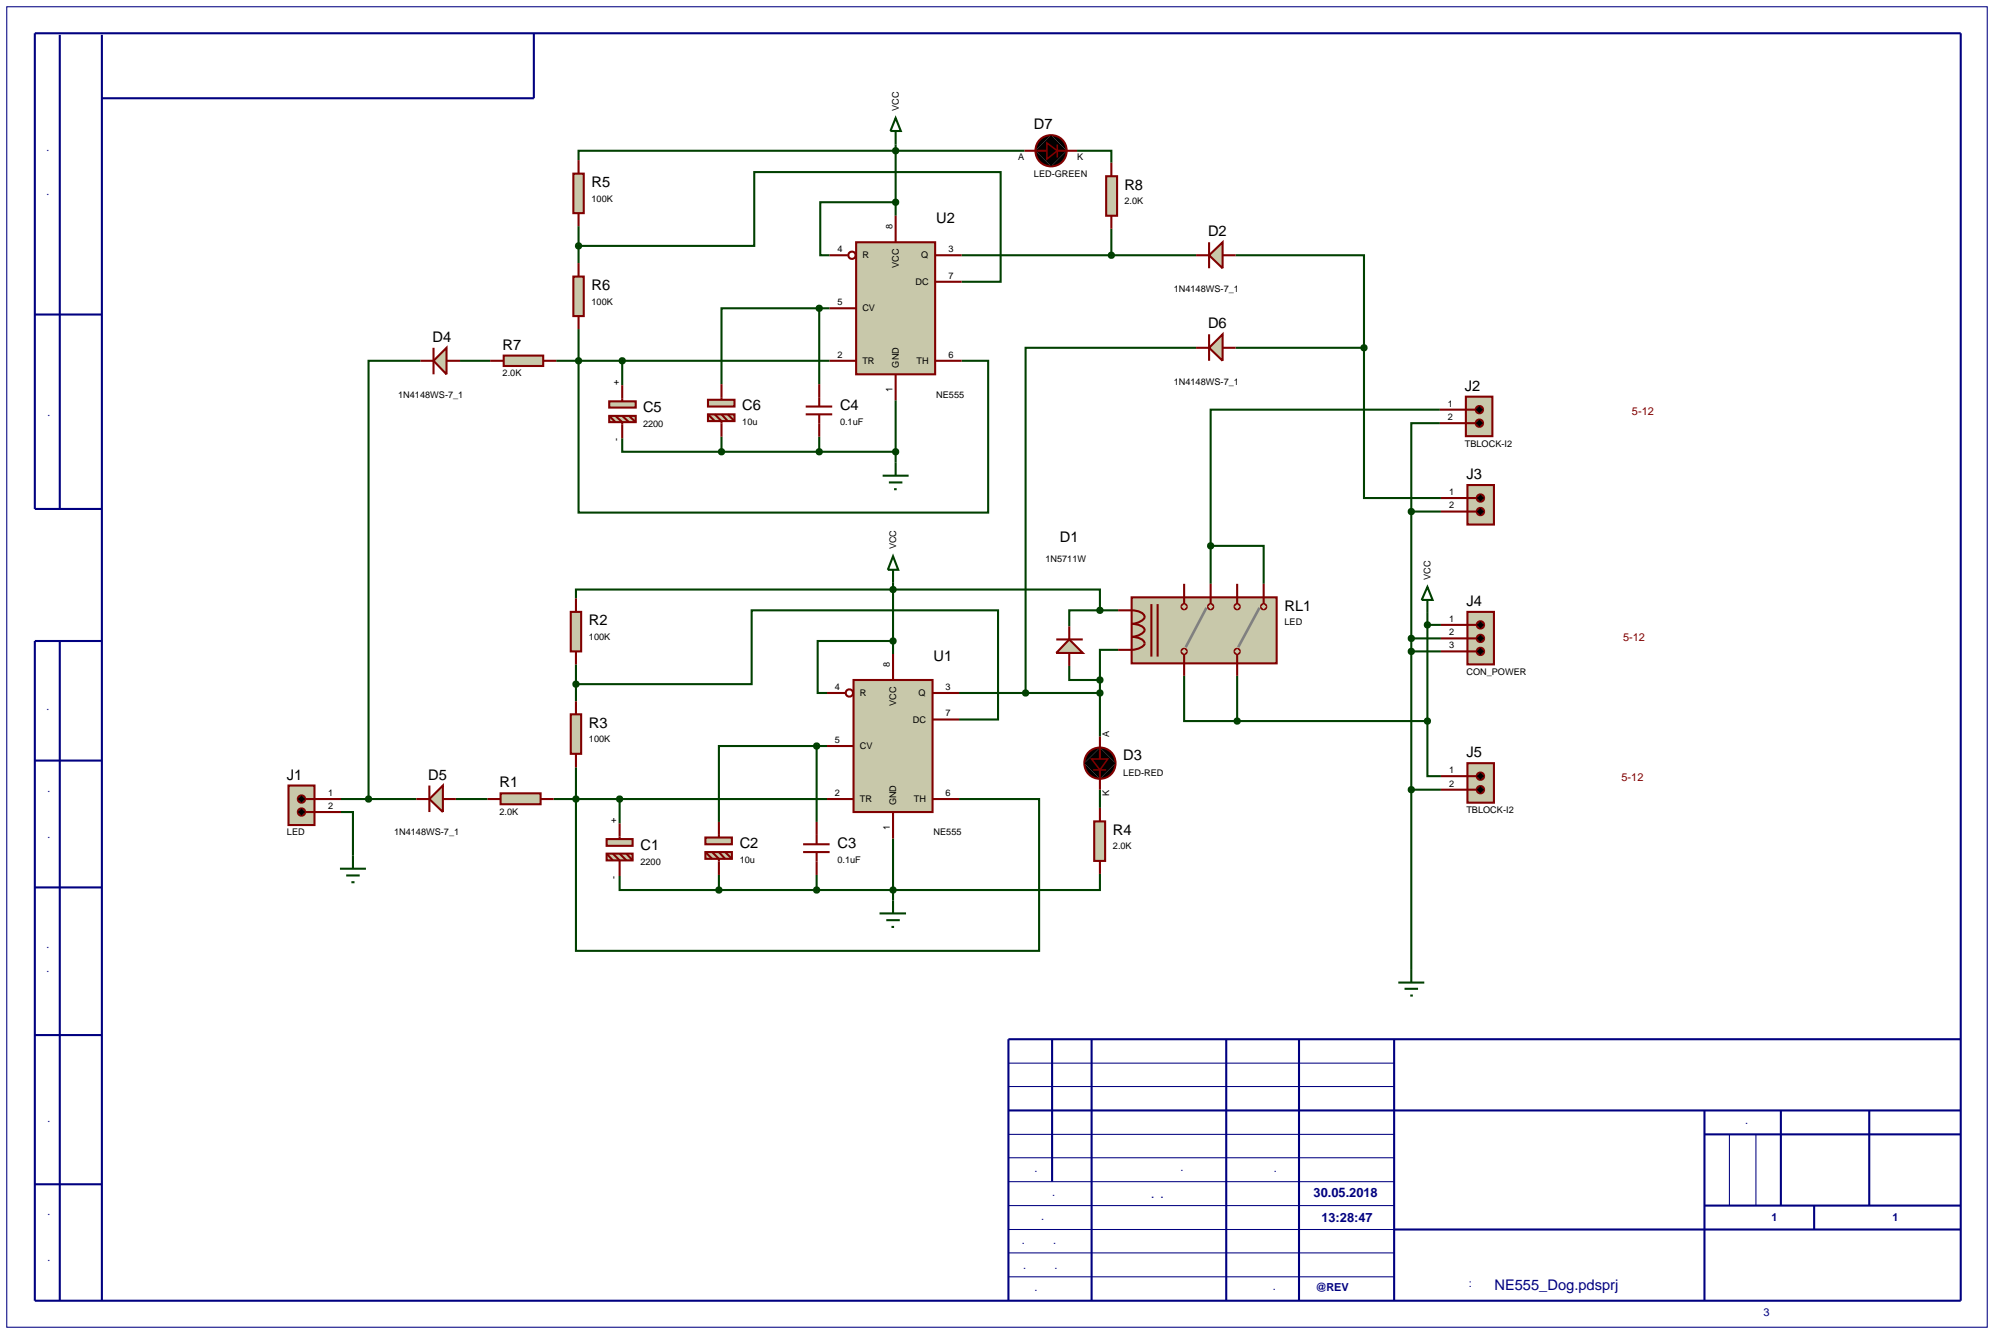
[picture p73: page 1]

Инв. № подл. Подп. и дата Взам. инв. № Инв. № дубл. Справ. № Перв. примен. Подп. и дата

Сторожевой таймер

Внешний двойной | Лит. | Масса | Масштаб

Изм. | Лист | № докум. | Подп. | Дата

Разраб. | | Мосейчук А.В. | | 30.05.2018
Пров. | | | 13:28:47 | | Лист 1 | Листов 1
Т.контр. | | | | Файл проекта: NE555_Dog.pdsprj

Н.контр.
Утв. | | Ревиз. | @REV
