albaniac/Teplica/ProteusGreenhouseDUE0_1/Сторожевой таймер.pdf

R42

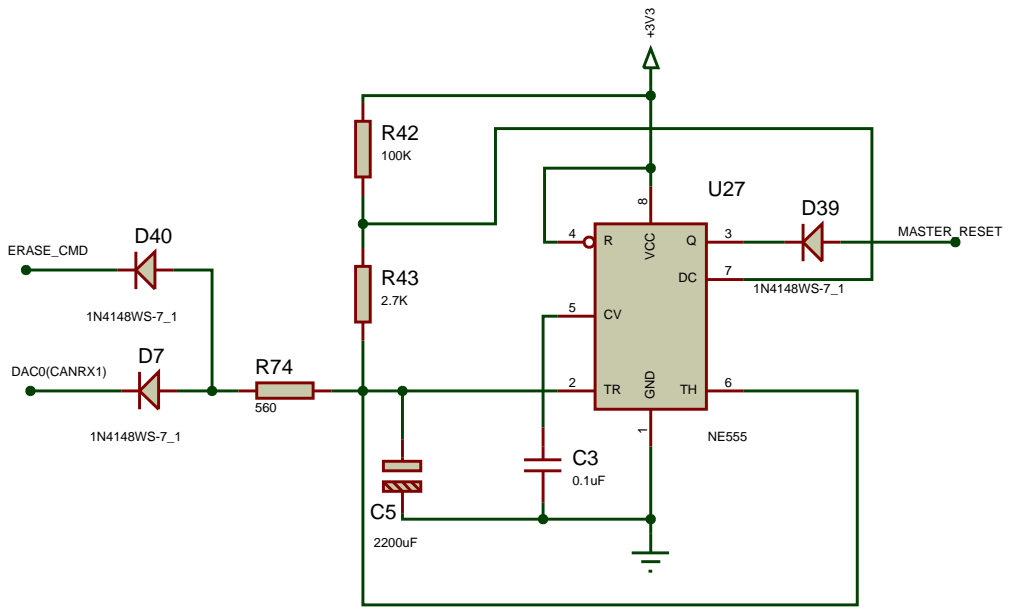
[picture p74: page 1]
