albaniac/Teplica/ProteusGreenhouseDUE0_1/ProteusGreenhouseDUE0_7_2_1.PDF

J26

J22

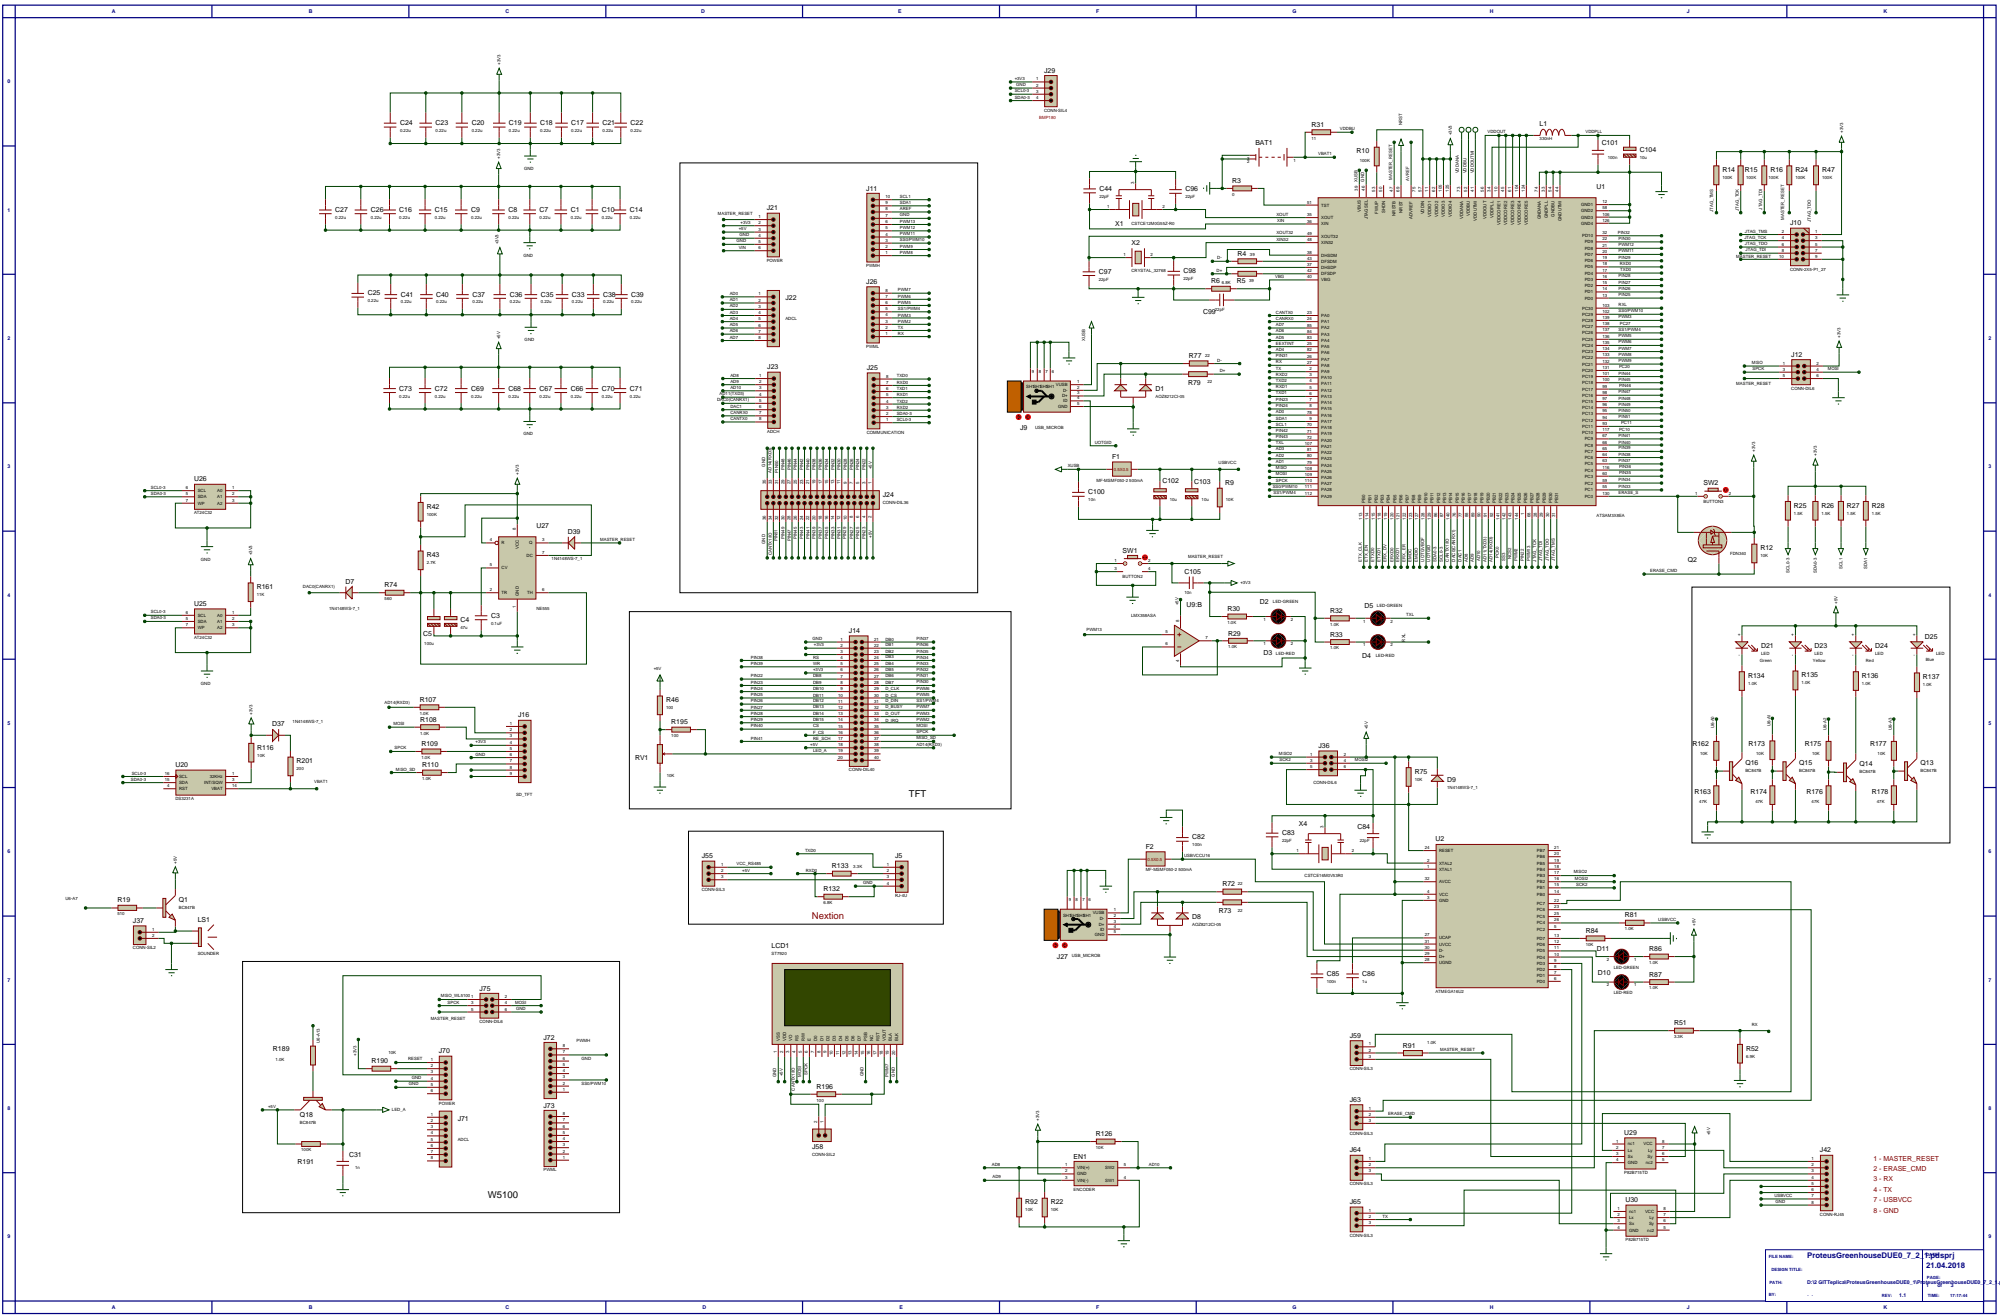
[picture p75: page 1]

## J1_RJ45

## J2_RJ45

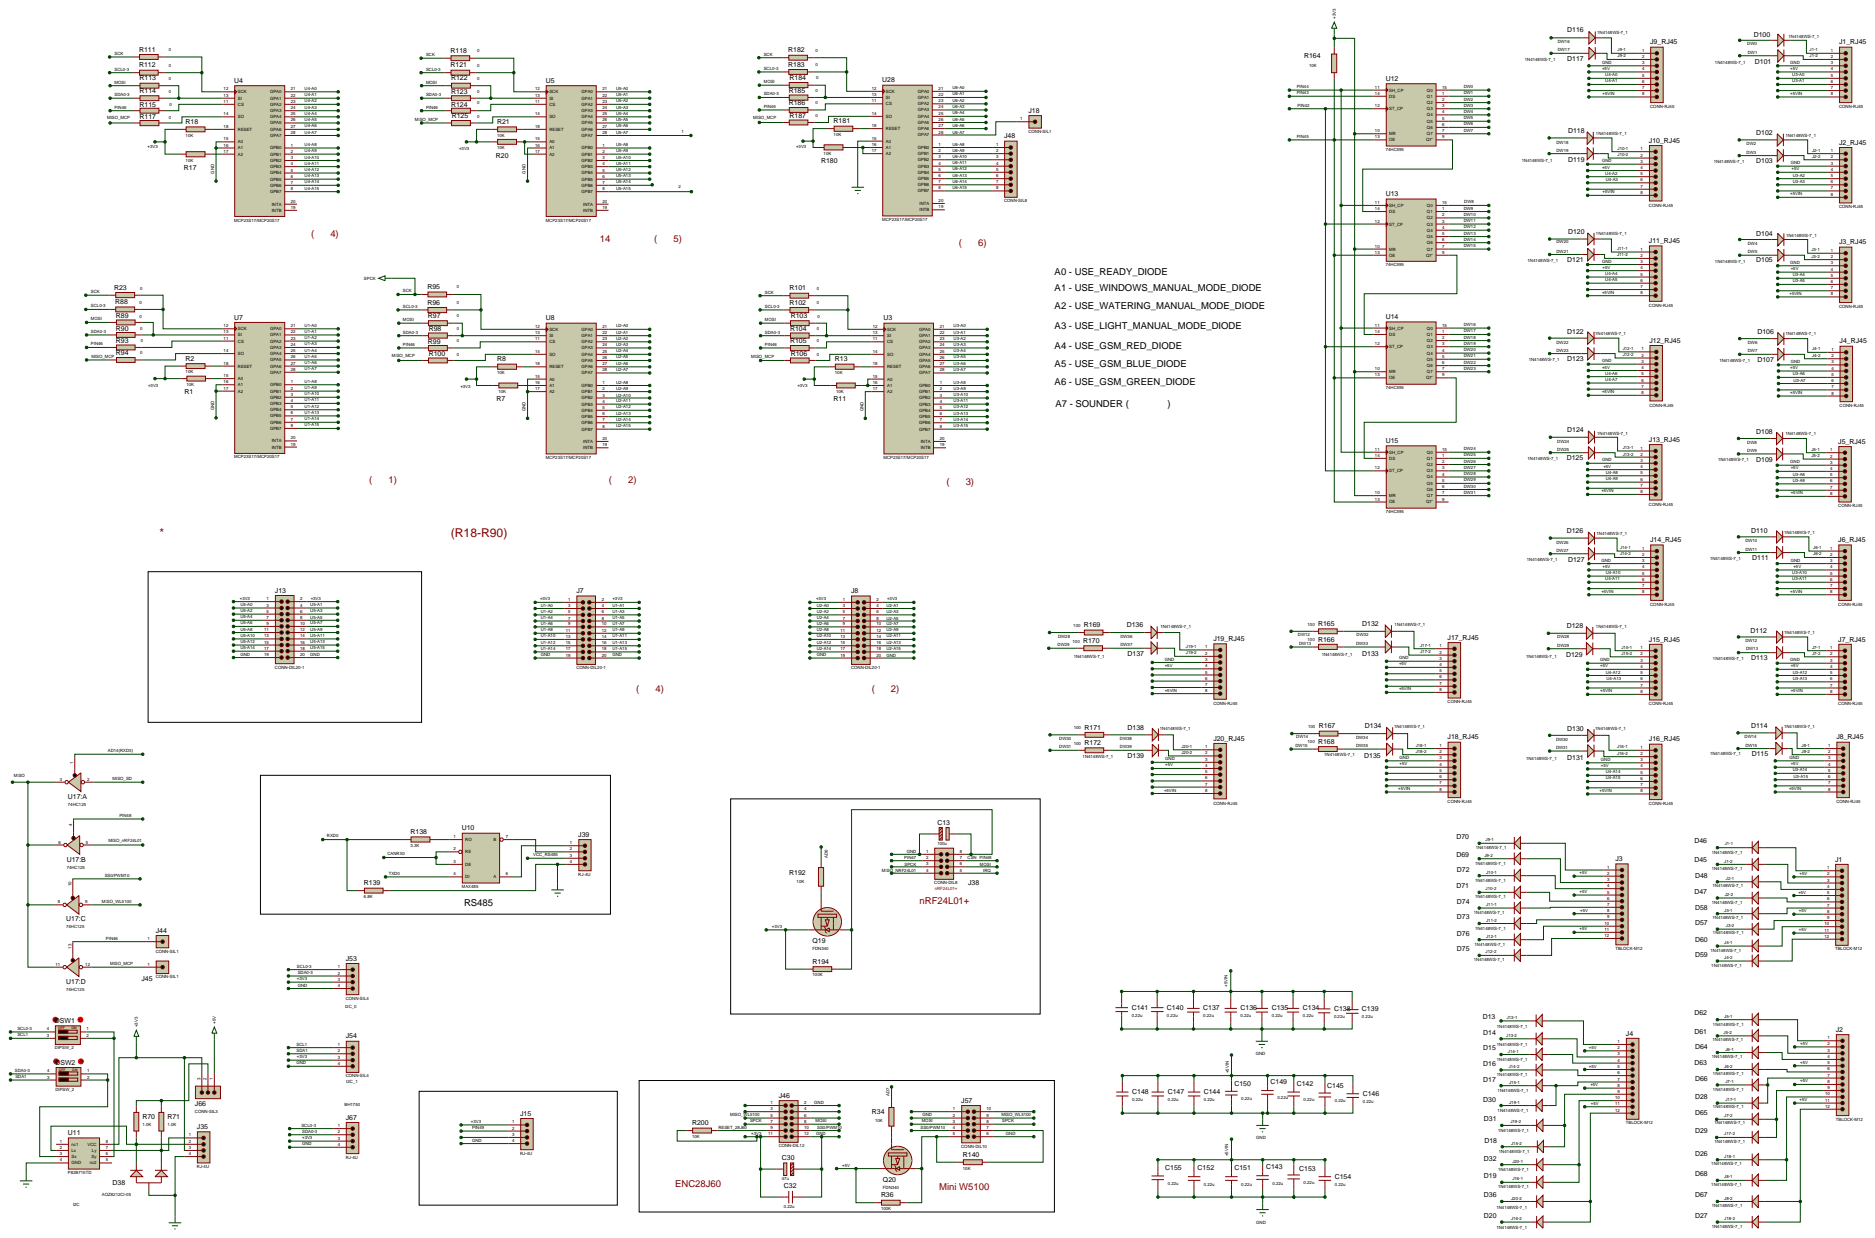
[picture p76: page 2]

* Устанавливать резисторы управляющих сигналов(R18-R90) в зависимости от типа микросхем

C106

C107

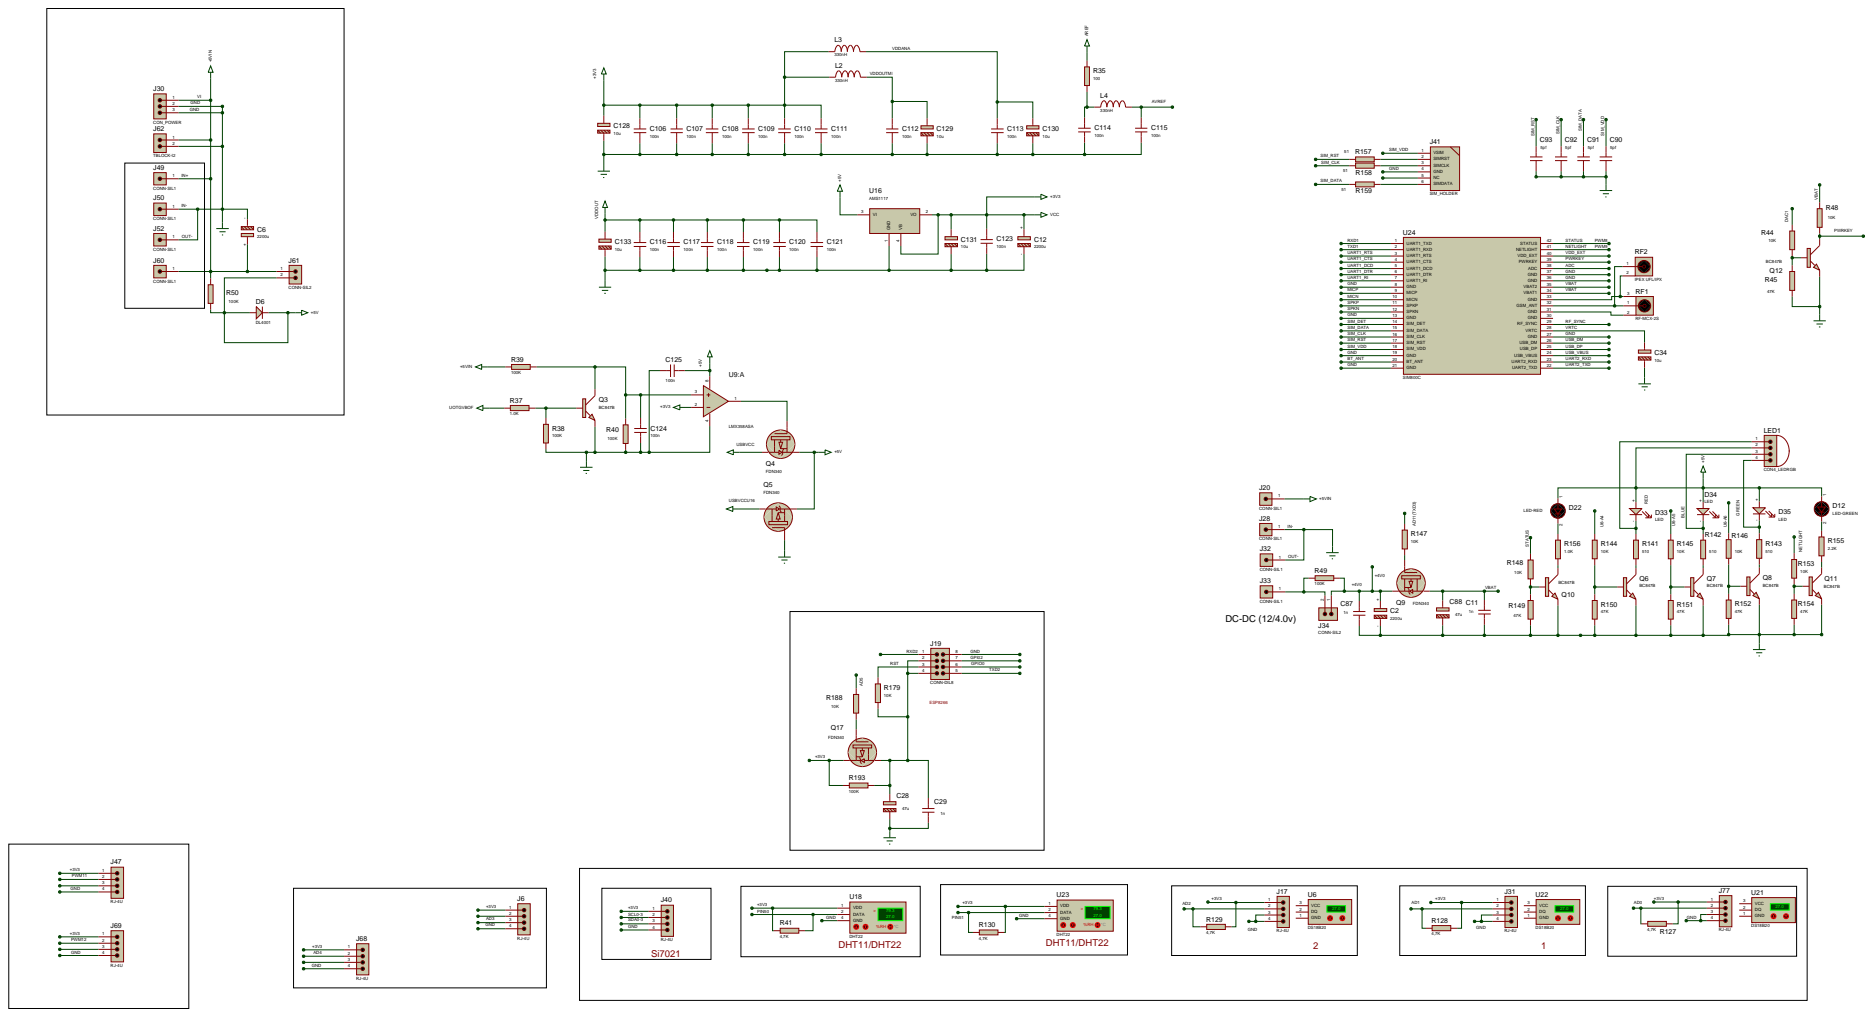
[picture p77: page 3]
