albaniac/Teplica/External_module/External_module.PDF

D4

D10

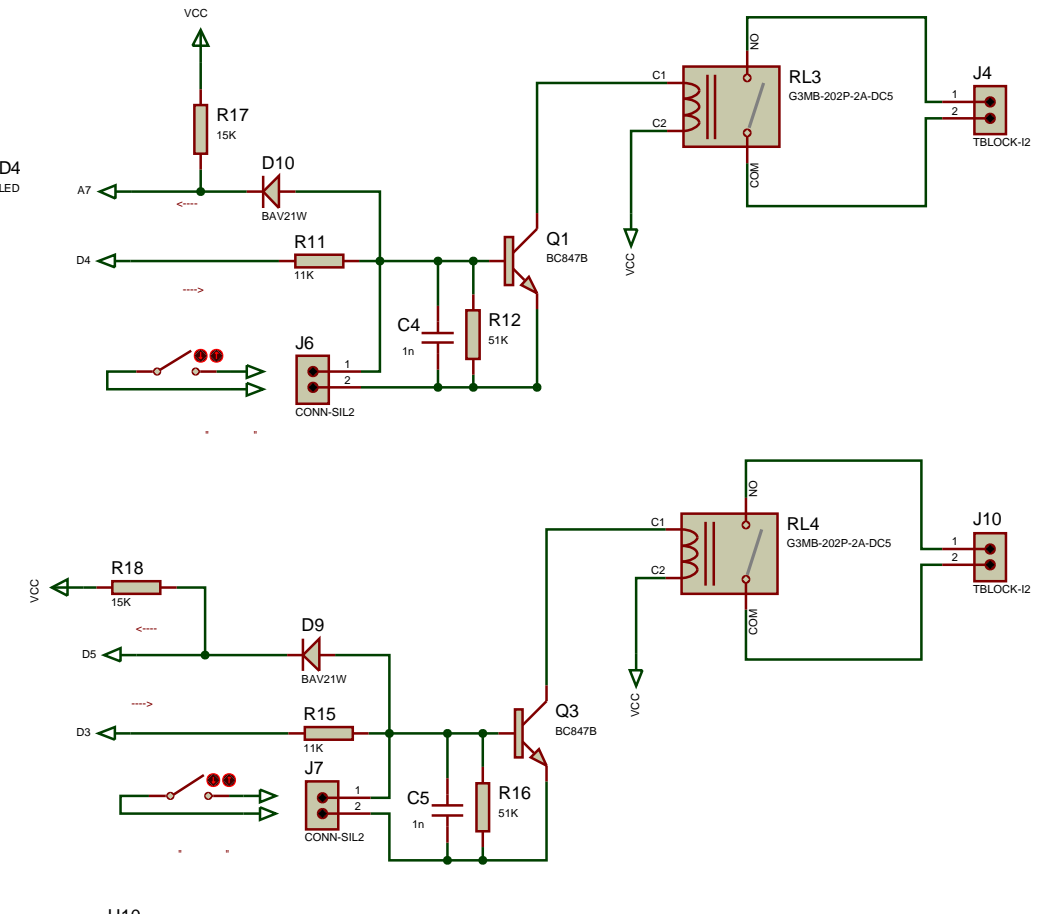
[picture p78: page 1]

Мотор открыто COM NO

Подключение геркона "Открыто"
Блокирует включение реле и отправляет сигнал контроллеру
