albaniac/Teplica/External_module/Execution_moduleI2C_4.PDF

J2

D1

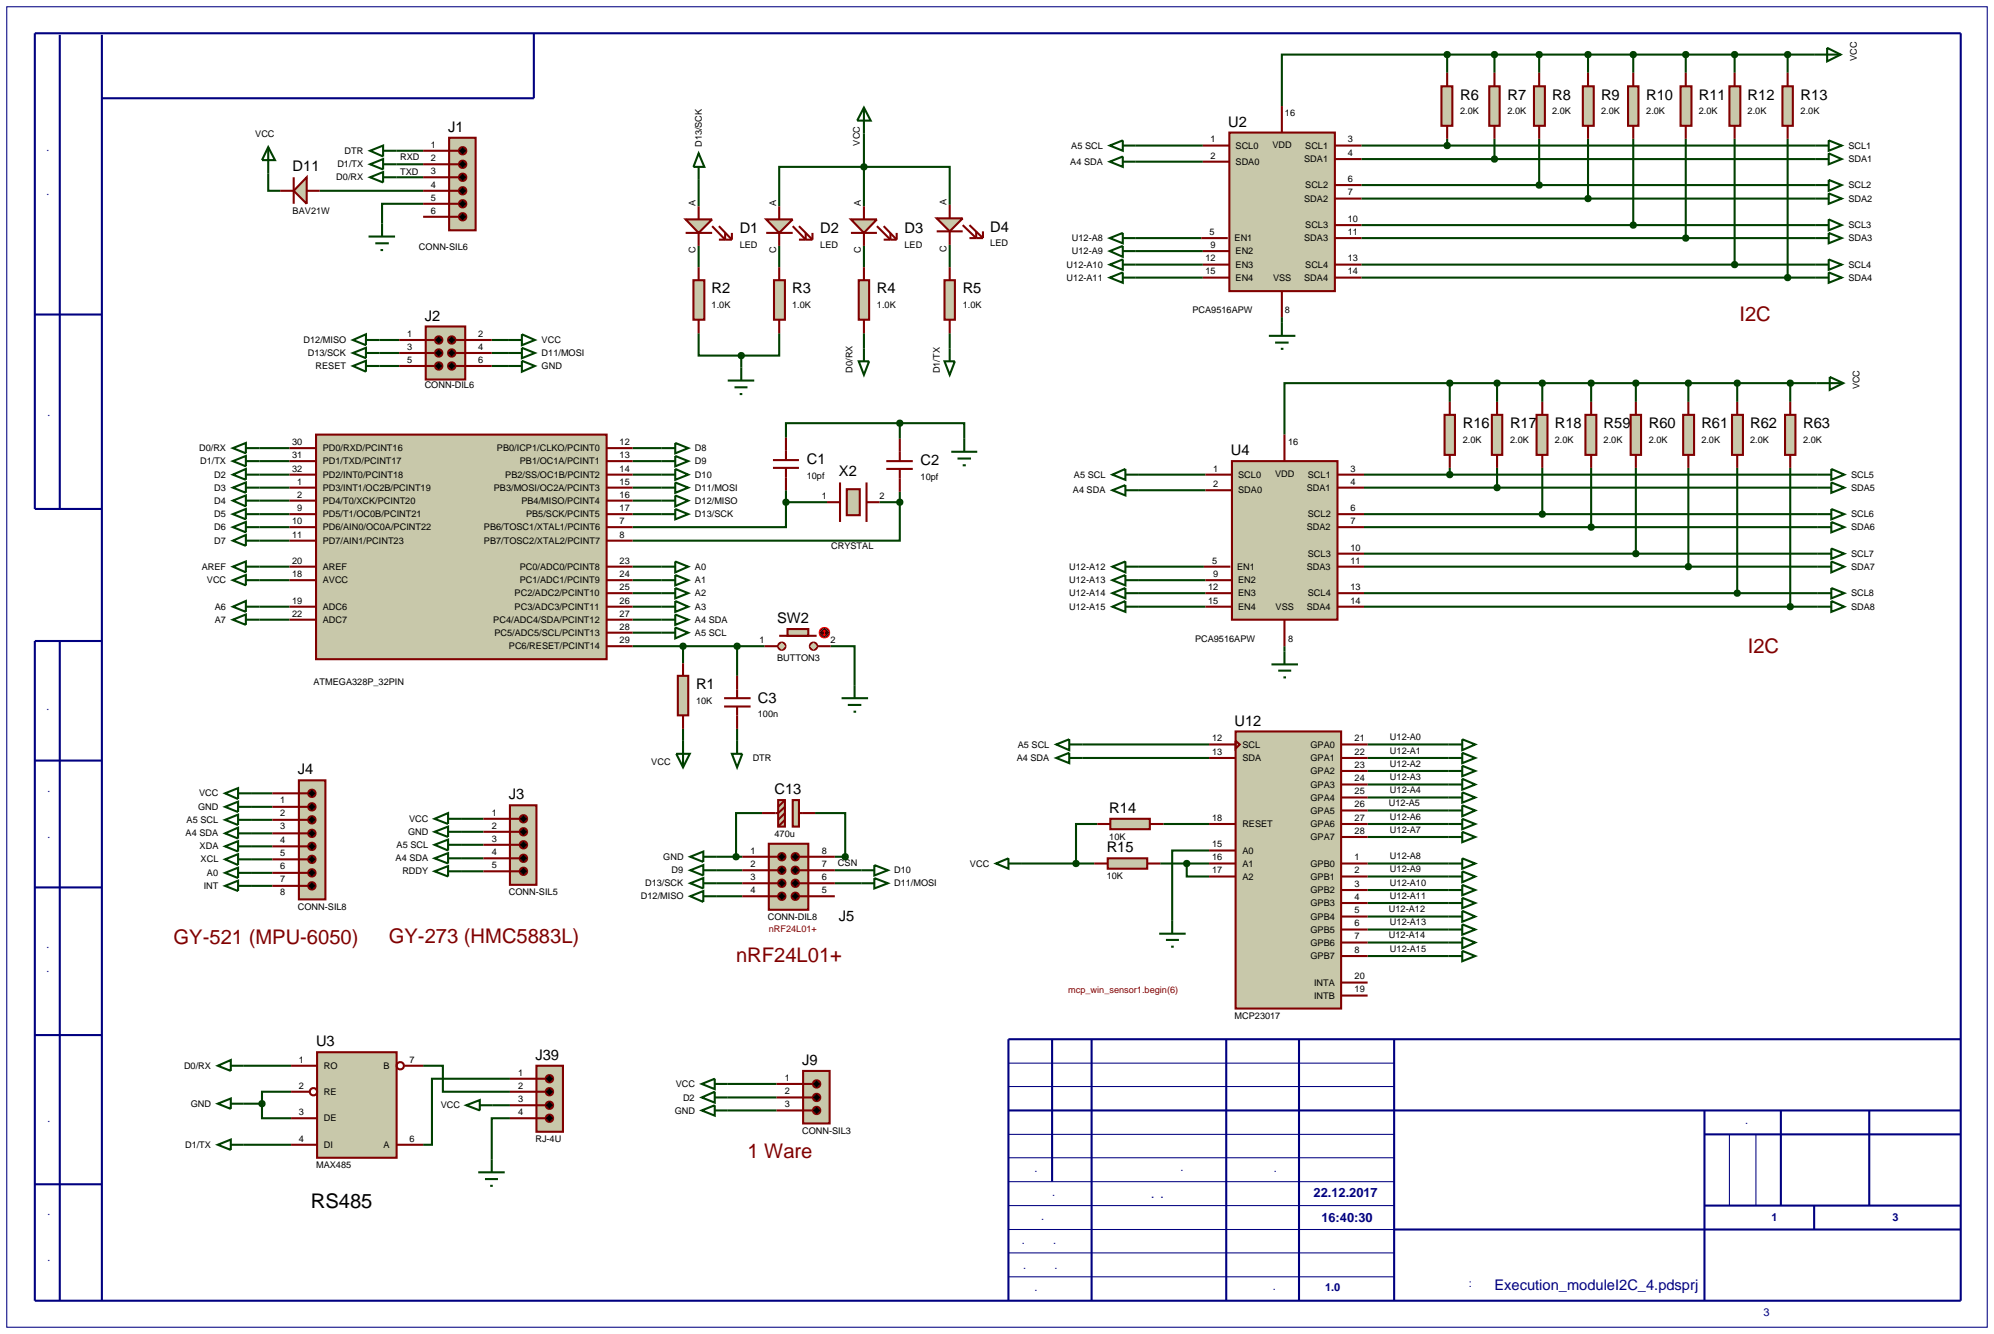
[picture p79: page 1]

Инв. № подл. Подп. и дата Взам. инв. № Инв. № дубл. Справ. № Перв. примен. Подп. и дата

Многофункциональный контроллер

Микроконтроллер | Лит. | Масса | Масштаб

Изм. | Лист | № докум. | Подп. | Дата

Разраб. | | Мосейчук А.В. | | 22.12.2017
Пров. | | | 16:40:30 | | Лист 1 3 | Листов
Т.контр. | | | | Файл проекта: Execution_moduleI2C_4.pdsprj

Н.контр.
Утв. | | Ревиз. | 1.0

RL3

Q6

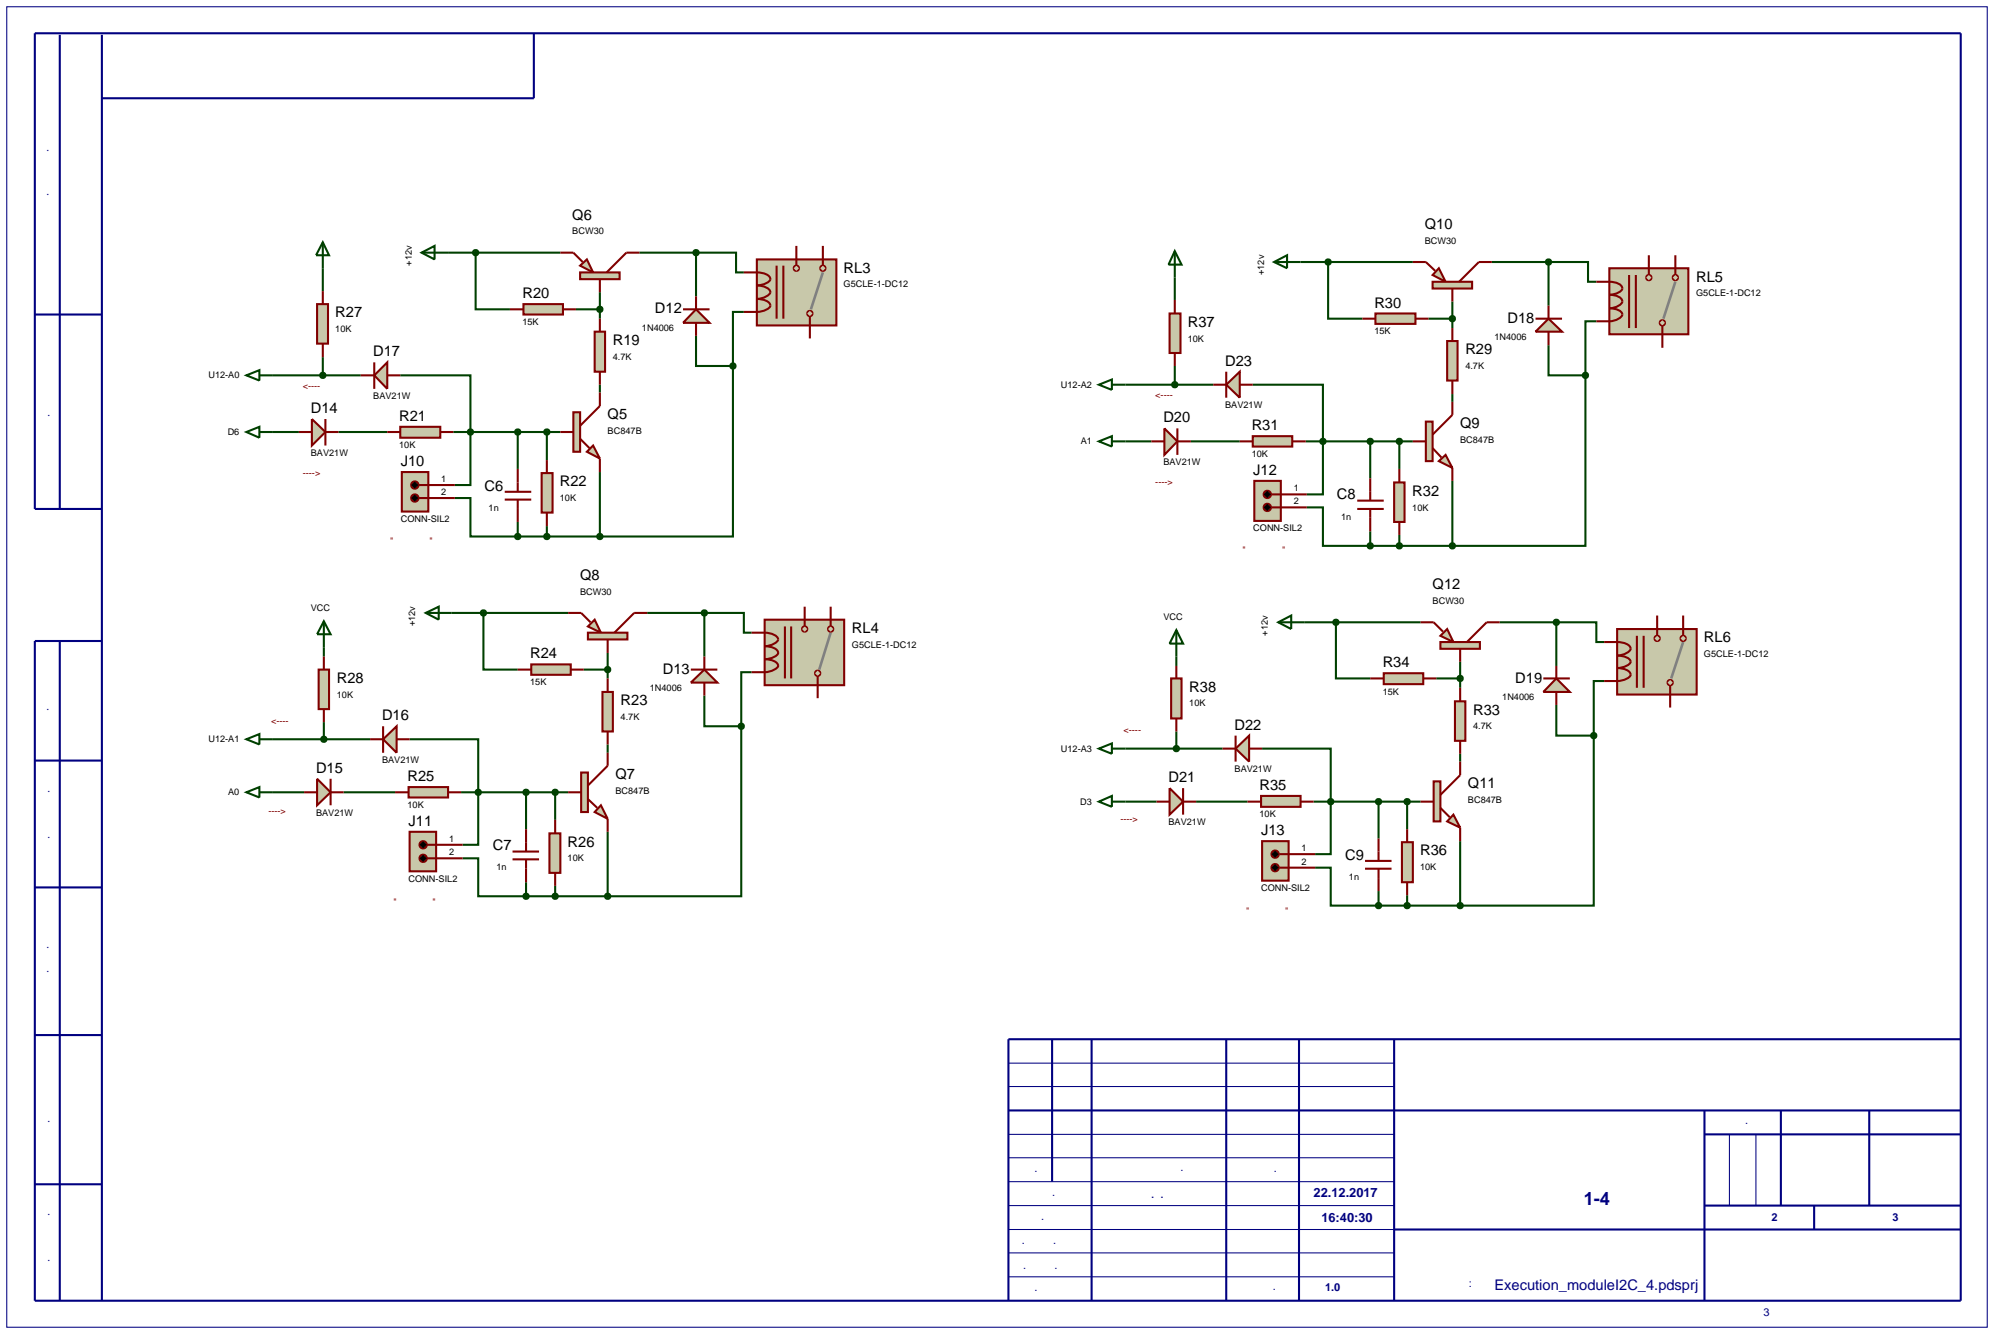
[picture p80: page 2]

Инв. № подл. Подп. и дата Взам. инв. № Инв. № дубл. Справ. № Перв. примен. Подп. и дата

Многофункциональный контроллер

Лит. | Масса | Масштаб

Изм. | Лист | № докум. | Подп. | Дата

Разраб. | | | | 22.12.2017 | Блок реле 1-4 Мосейчук А.В.
Пров. | | | 16:40:30 | | Лист 2 | Листов 3

RL7

Q14

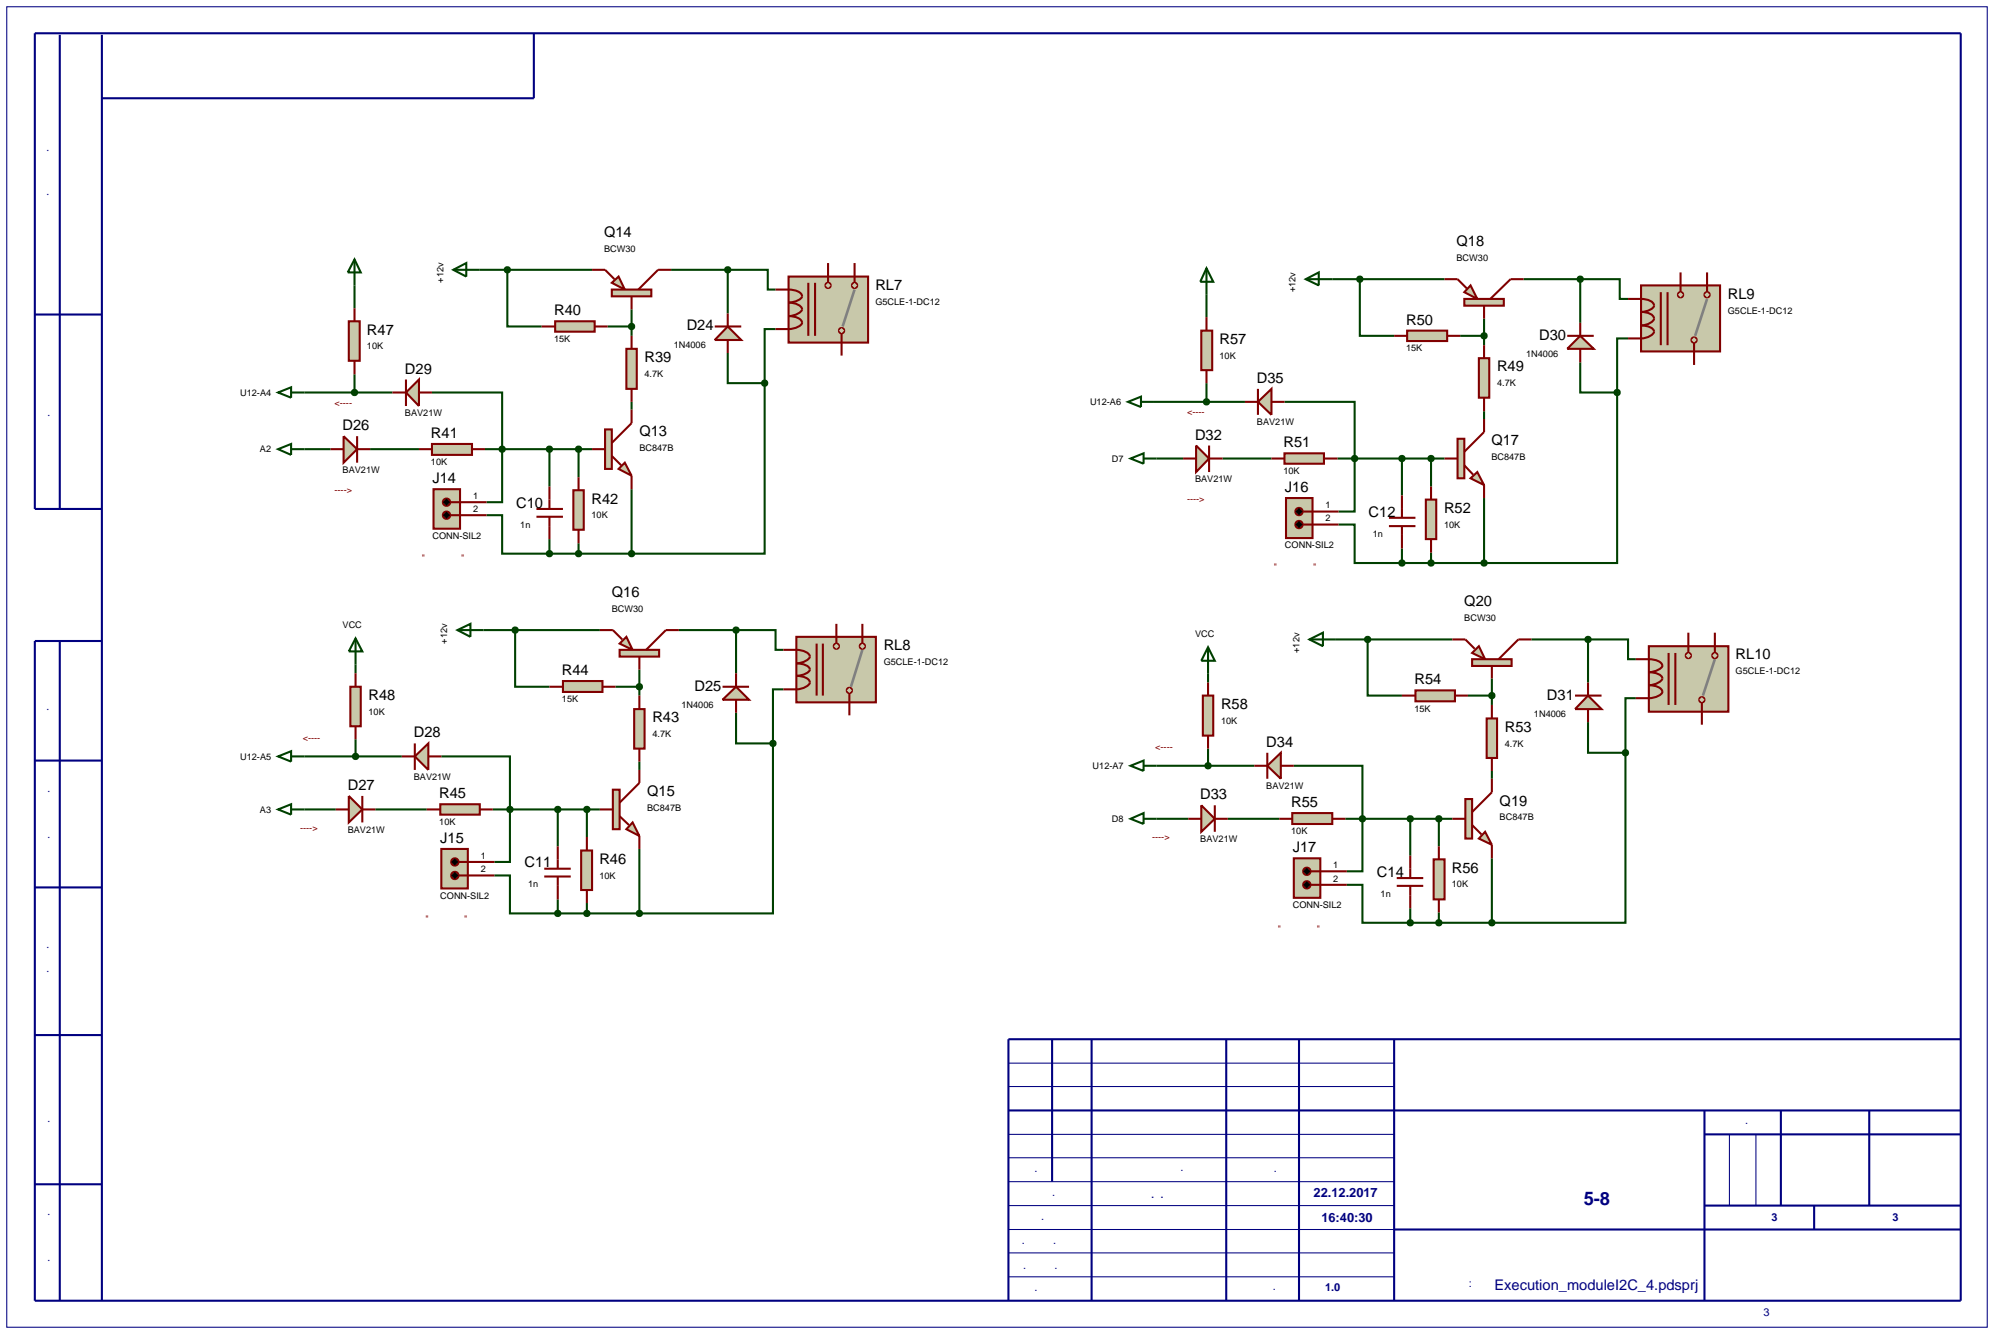
[picture p81: page 3]

Инв. № подл. Подп. и дата Взам. инв. № Инв. № дубл. Справ. № Перв. примен. Подп. и дата

Многофункциональный контроллер

Лит. | Масса | Масштаб

Изм. | Лист | № докум. | Подп. | Дата

Разраб. | | | | 22.12.2017 | Блок реле 5-8 Мосейчук А.В.
Пров. | | | 16:40:30 | | Лист 3 | Листов 3
