albaniac/Teplica/External_module/Execution_moduleI2C_4_1.PDF

J2

D1

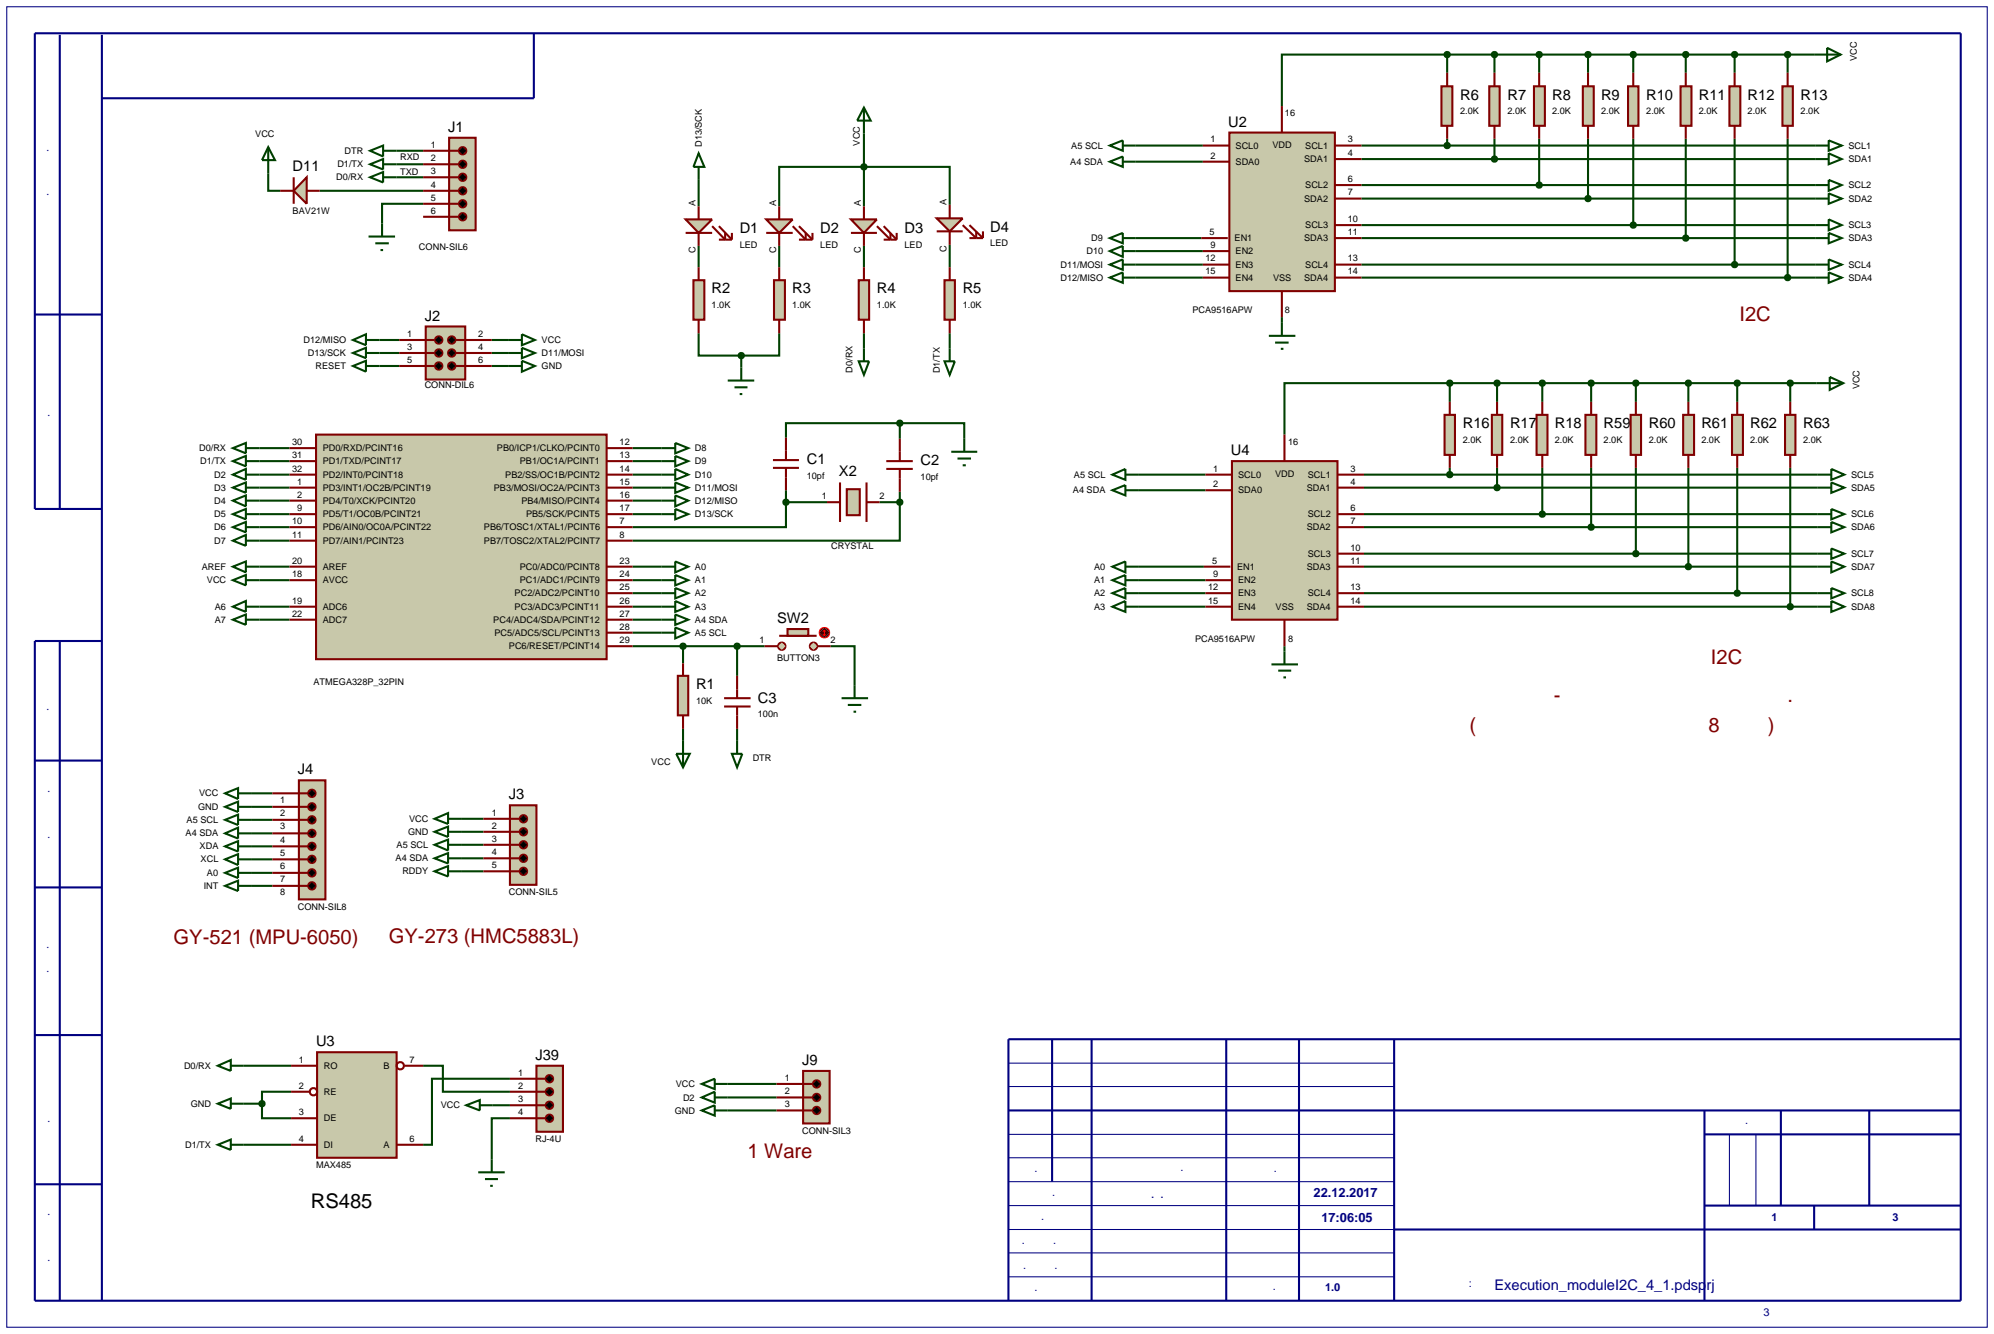
[picture p82: page 1]

Инв. № подл. Подп. и дата Взам. инв. № Инв. № дубл. Справ. № Перв. примен. Подп. и дата

Резервный расширитель I2C
Вариант - без управления окнами.
(только измерение углов 8 окон)

Многофункциональный контроллер

Микроконтроллер | Лит. | Масса | Масштаб

Изм. | Лист | № докум. | Подп. | Дата

Разраб. | | Мосейчук А.В. | | 22.12.2017
Пров. | | | 17:06:05 | | Лист 1 3 | Листов
Т.контр. | | | | Файл проекта: Execution_moduleI2C_4_1.pdsprj

Н.контр.
Утв. | | Ревиз. | 1.0

RL3

Q6

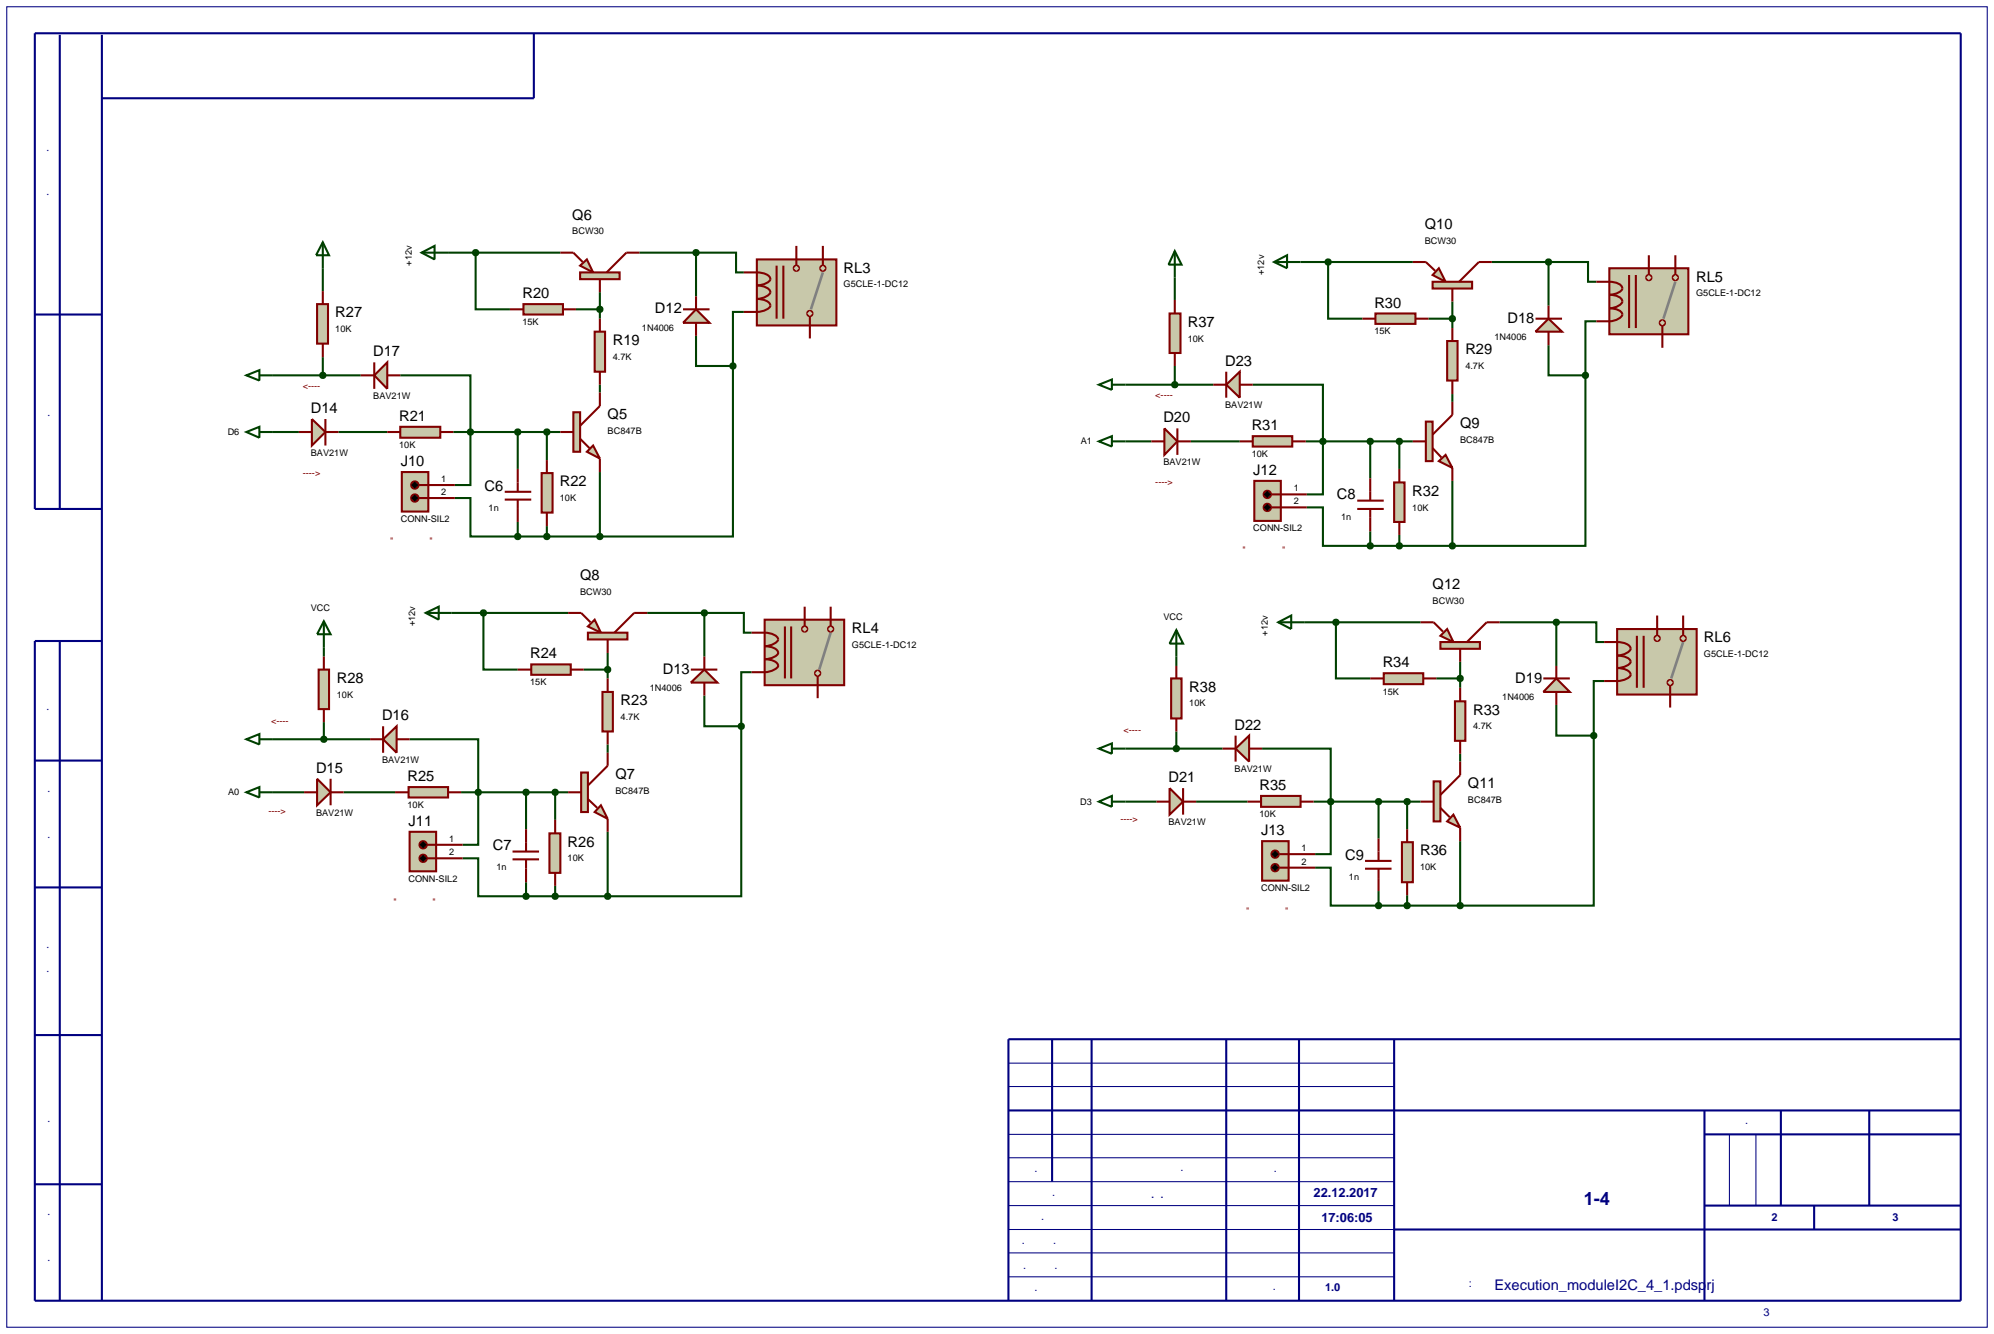
[picture p83: page 2]

Инв. № подл. Подп. и дата Взам. инв. № Инв. № дубл. Справ. № Перв. примен. Подп. и дата

Многофункциональный контроллер

Лит. | Масса | Масштаб

Изм. | Лист | № докум. | Подп. | Дата

Разраб. | | | | 22.12.2017 | Блок реле 1-4 Мосейчук А.В.
Пров. | | | 17:06:05 | | Лист 2 3 | Листов

RL7

Q14

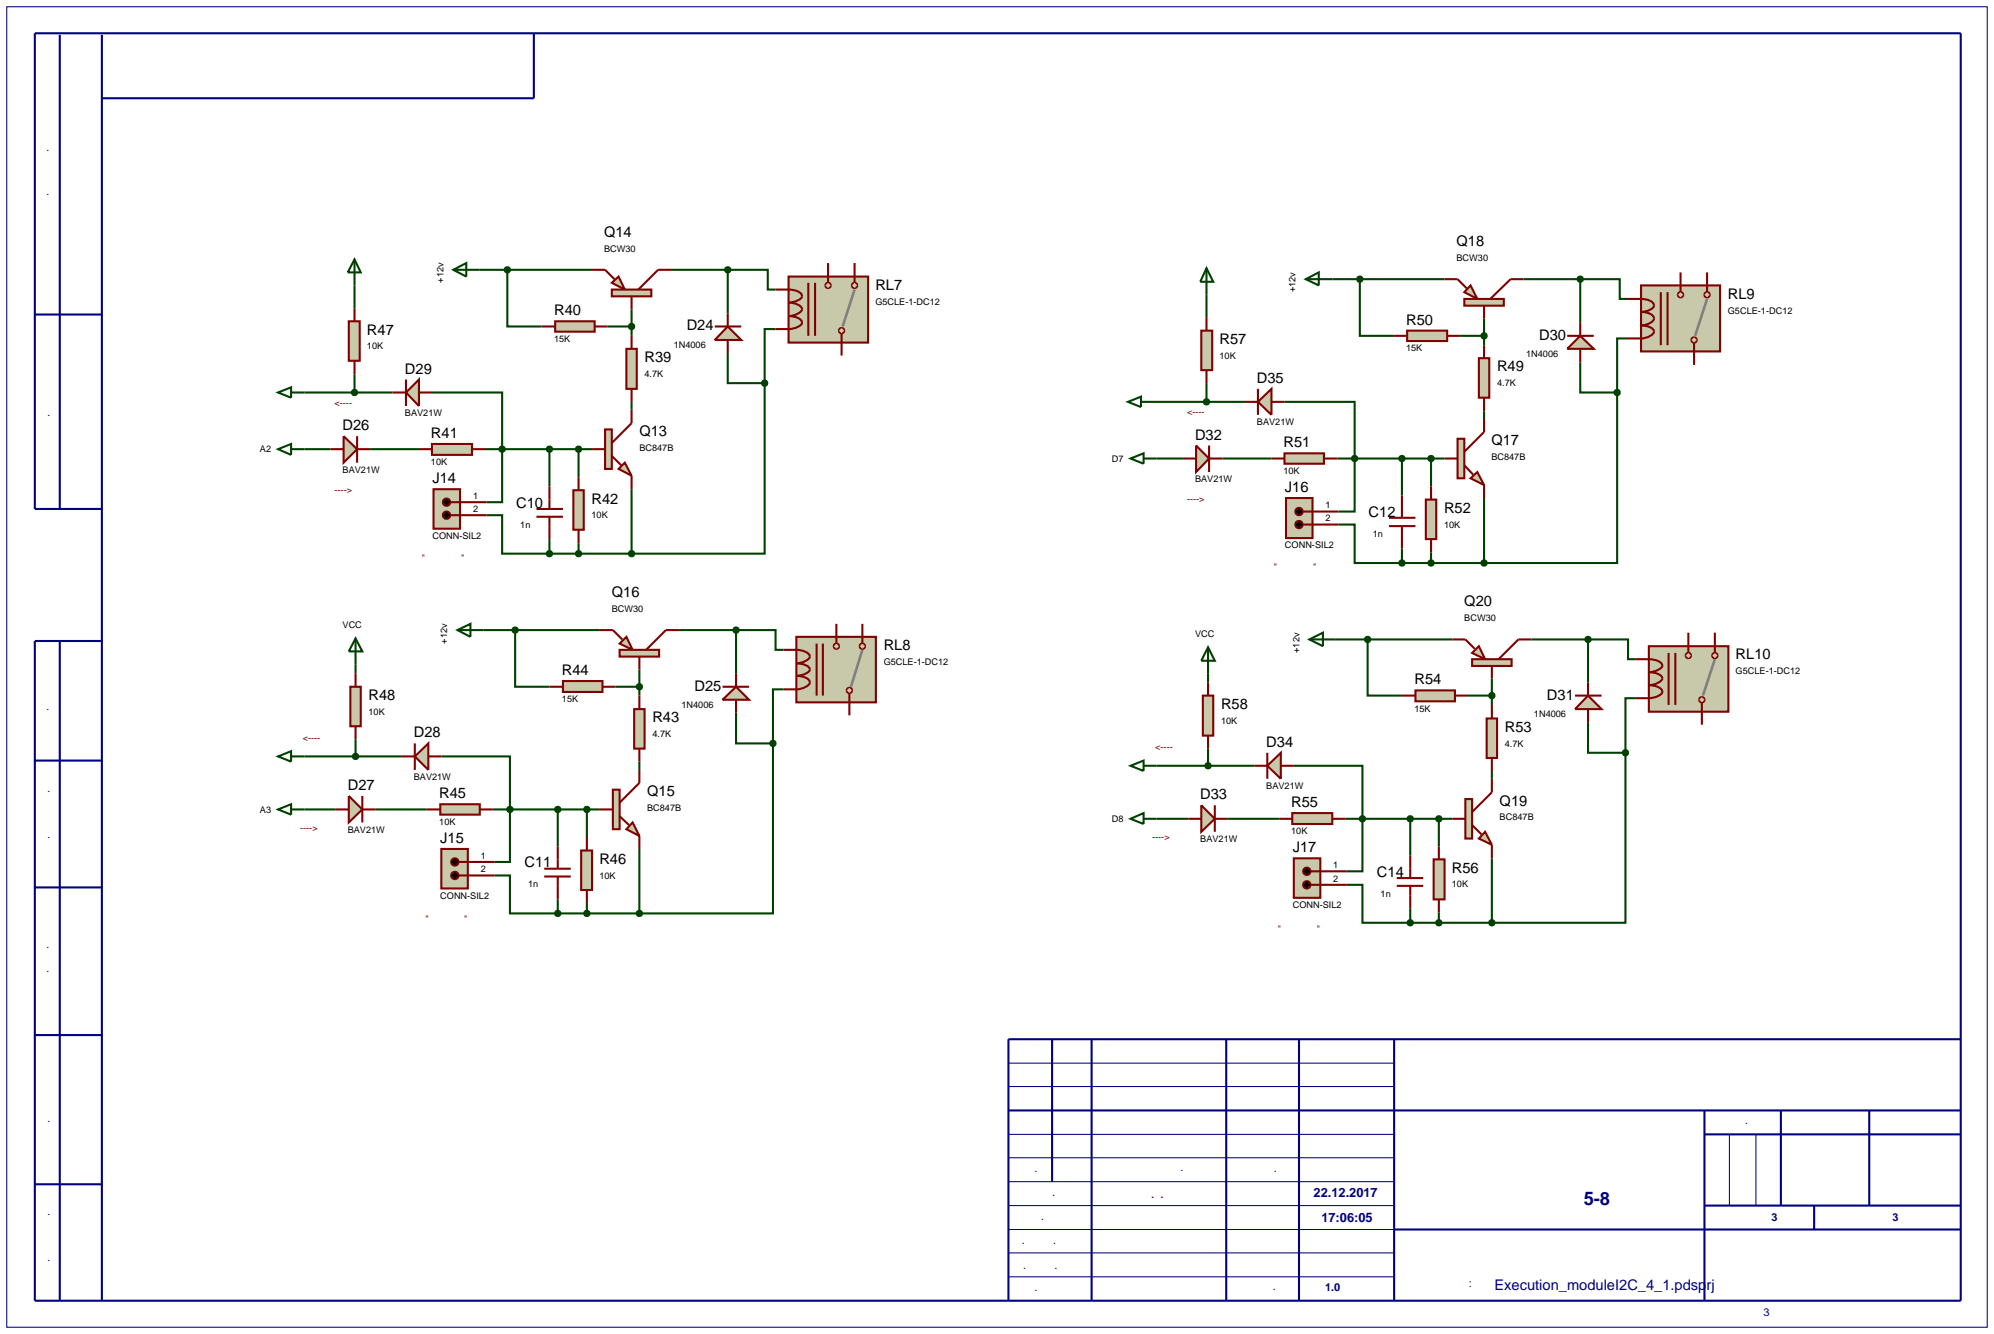
[picture p84: page 3]

Инв. № подл. Подп. и дата Взам. инв. № Инв. № дубл. Справ. № Перв. примен. Подп. и дата

Многофункциональный контроллер

Лит. | Масса | Масштаб

Изм. | Лист | № докум. | Подп. | Дата

Разраб. | | | | 22.12.2017 | Блок реле 5-8 Мосейчук А.В.
Пров. | | | 17:06:05 | | Лист 3 3 | Листов
