albaniac/Teplica/Proteus TeplicaMotor/TeplicaMotor2_a.PDF

RL1

Q2

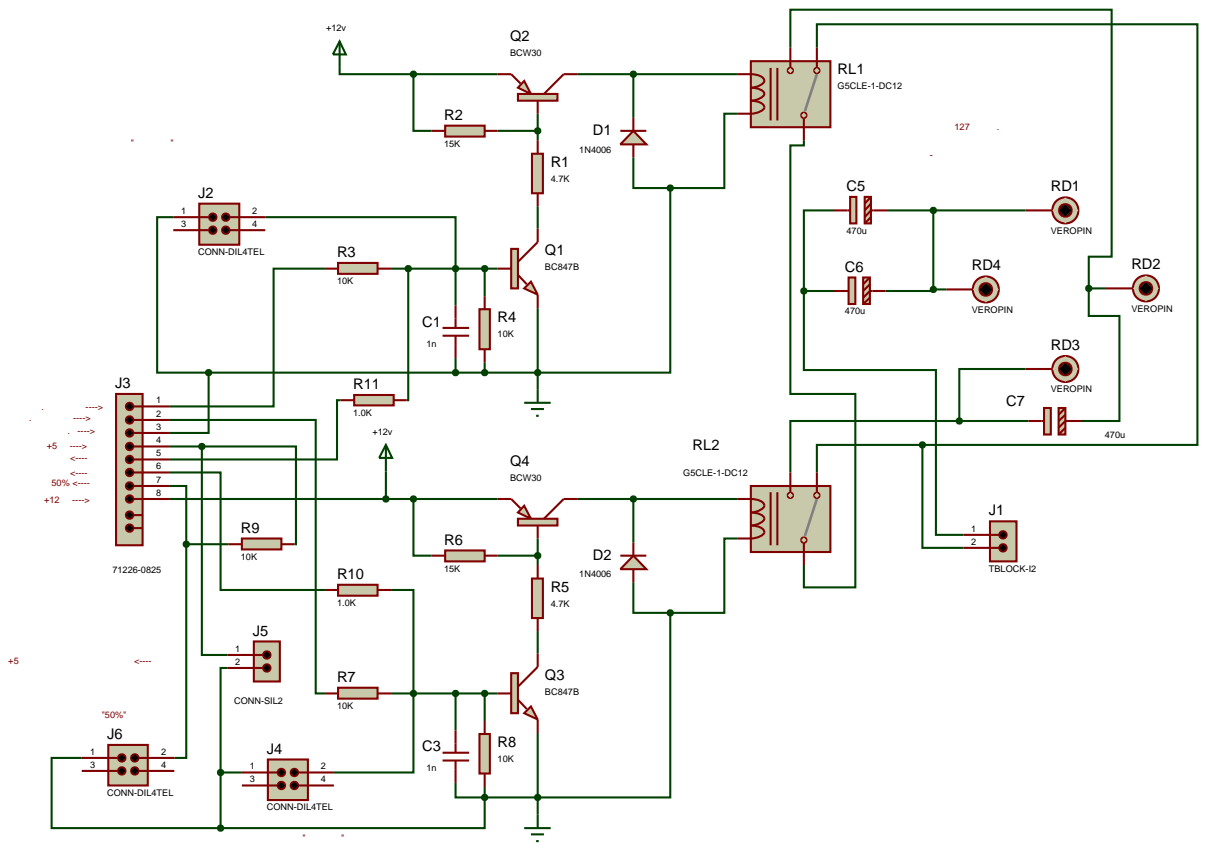
[picture p85: page 1]

Мотор типа РД 127 вольт.

При подключении иного - конденсаторы исключить

Питание +5 в для внешних устройств <----
