albaniac/Teplica/Proteus_USB_Distance/Proteus_USB_Distance.PDF

J2

R3

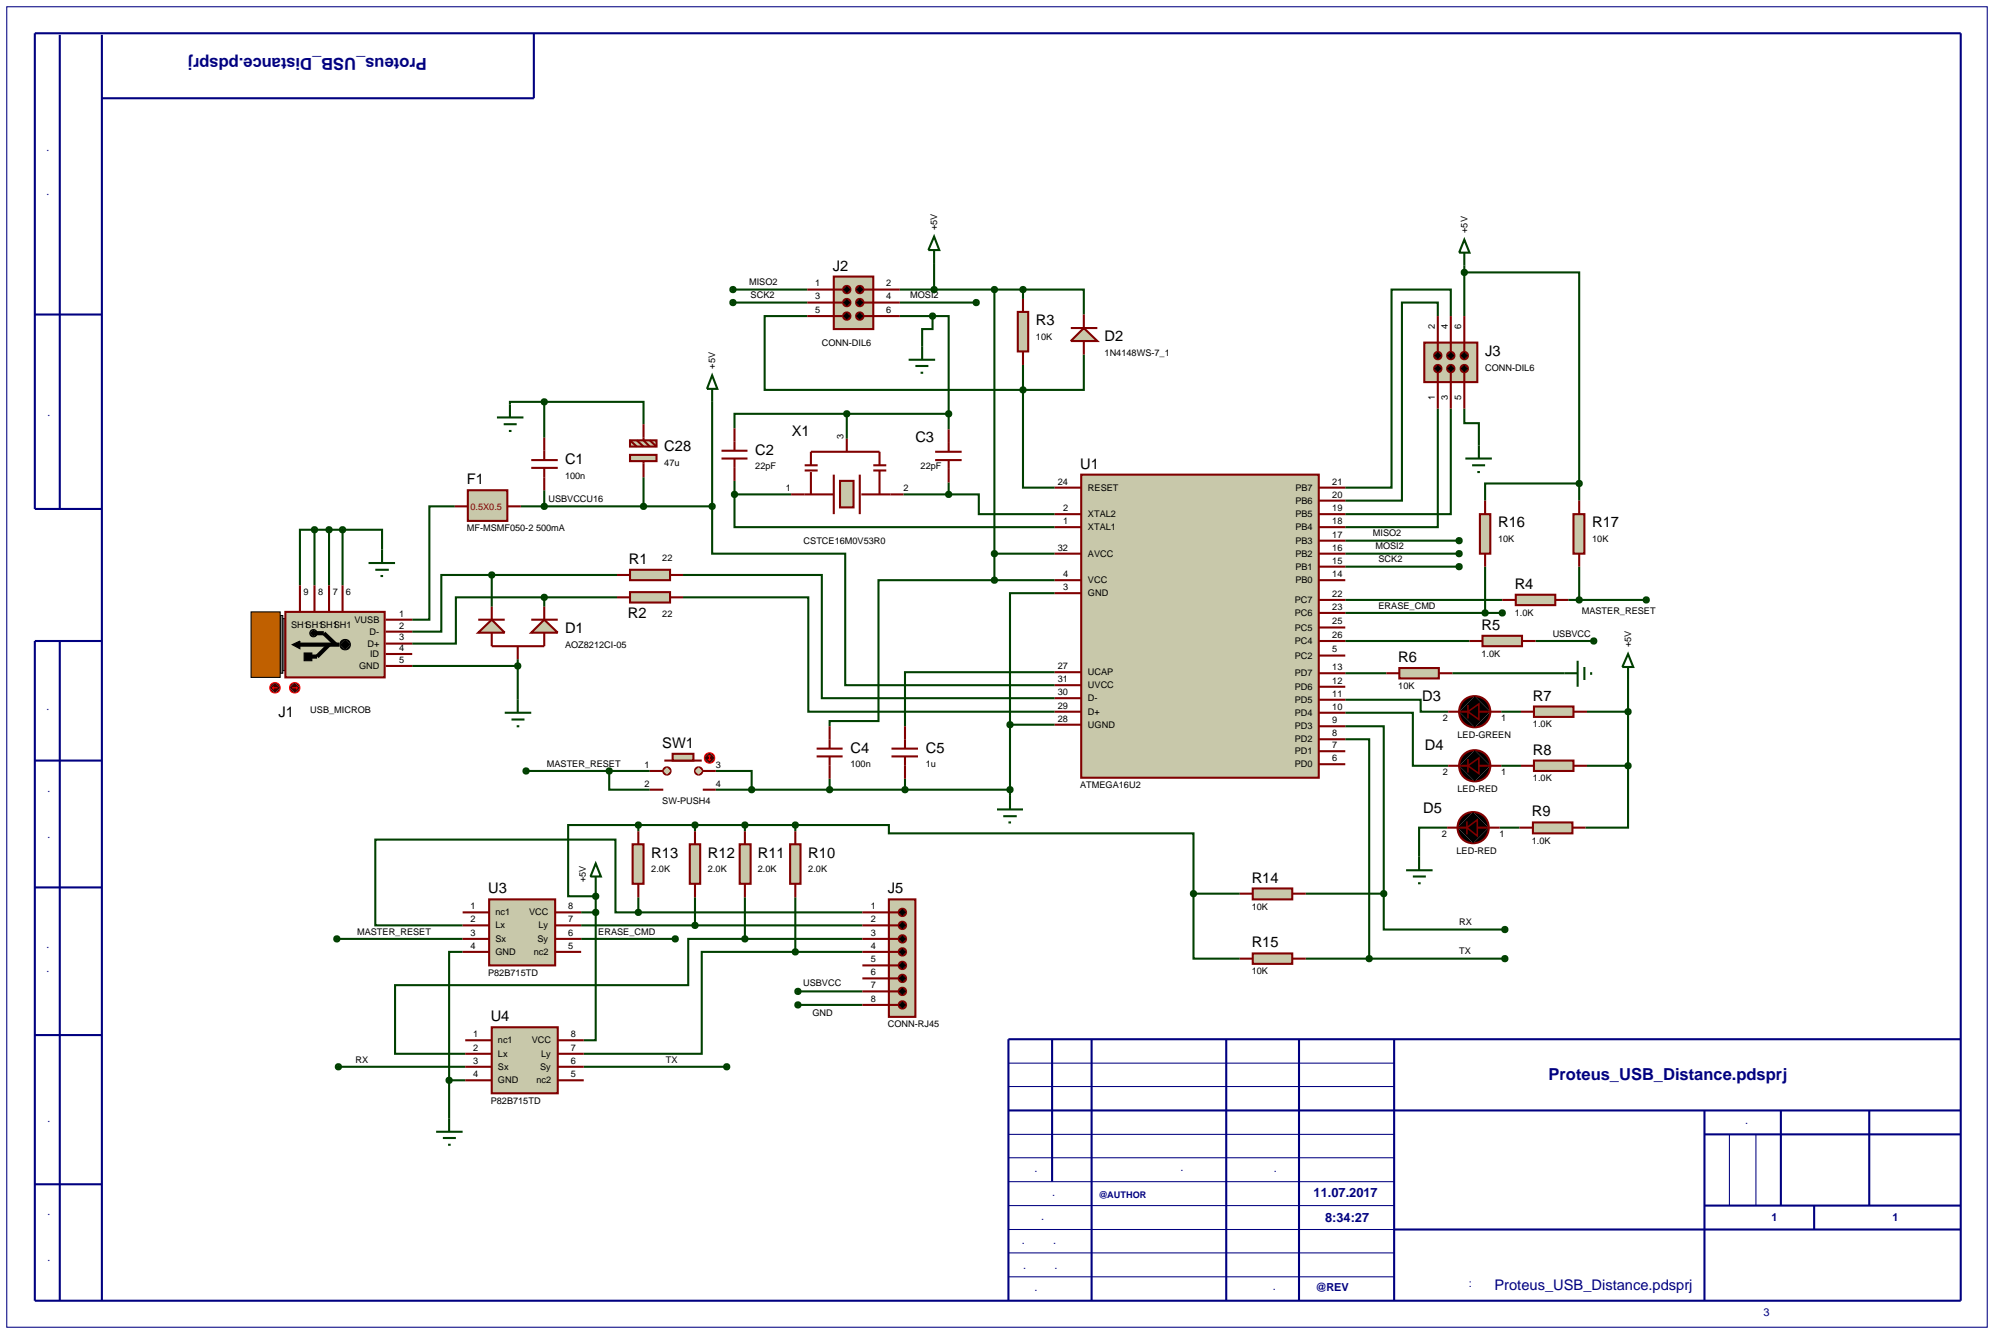
[picture p86: page 1]

Инв. № подл. Подп. и дата Взам. инв. № Инв. № дубл. Справ. № Перв. примен. Подп. и дата

Proteus_USB_Distance.pdsprj

Лит. | Масса | Масштаб

Изм. | Лист | № докум. | Подп. | Дата
Разраб. | | @AUTHOR | | 11.07.2017
Пров. | | | 8:34:27 | | Лист 1 1 | Листов
Т.контр. | | | | Файл проекта: Proteus_USB_Distance.pdsprj

Н.контр.
Утв. | | Ревиз. | @REV
