albaniac/Teplica/ProteusGreenhouseDUE0_1/DOC/Сторожевой таймер.pdf

Q10

R79

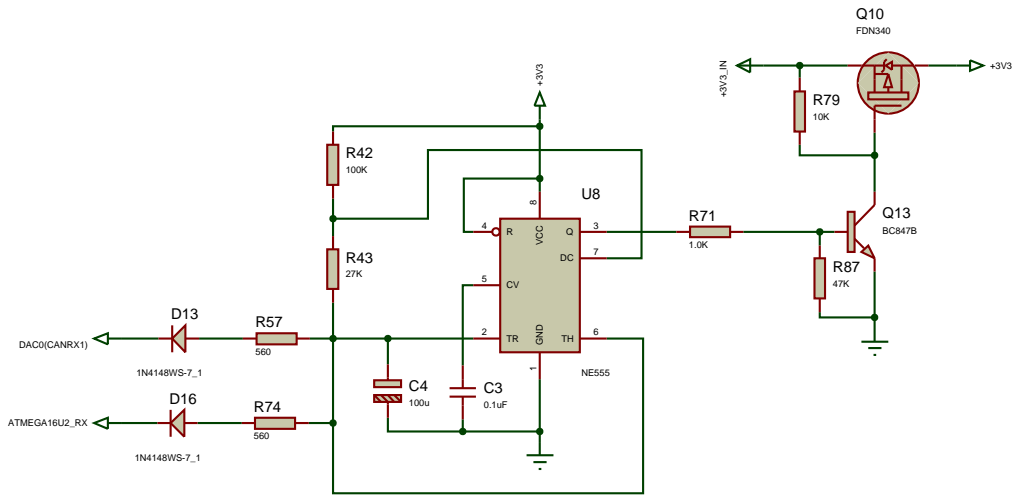
[picture p87: page 1]
