albaniac/Teplica/ProteusGreenhouseDUE0_1/DOC/ProteusGreenhouseDUE0_7.pdf

J26

J22

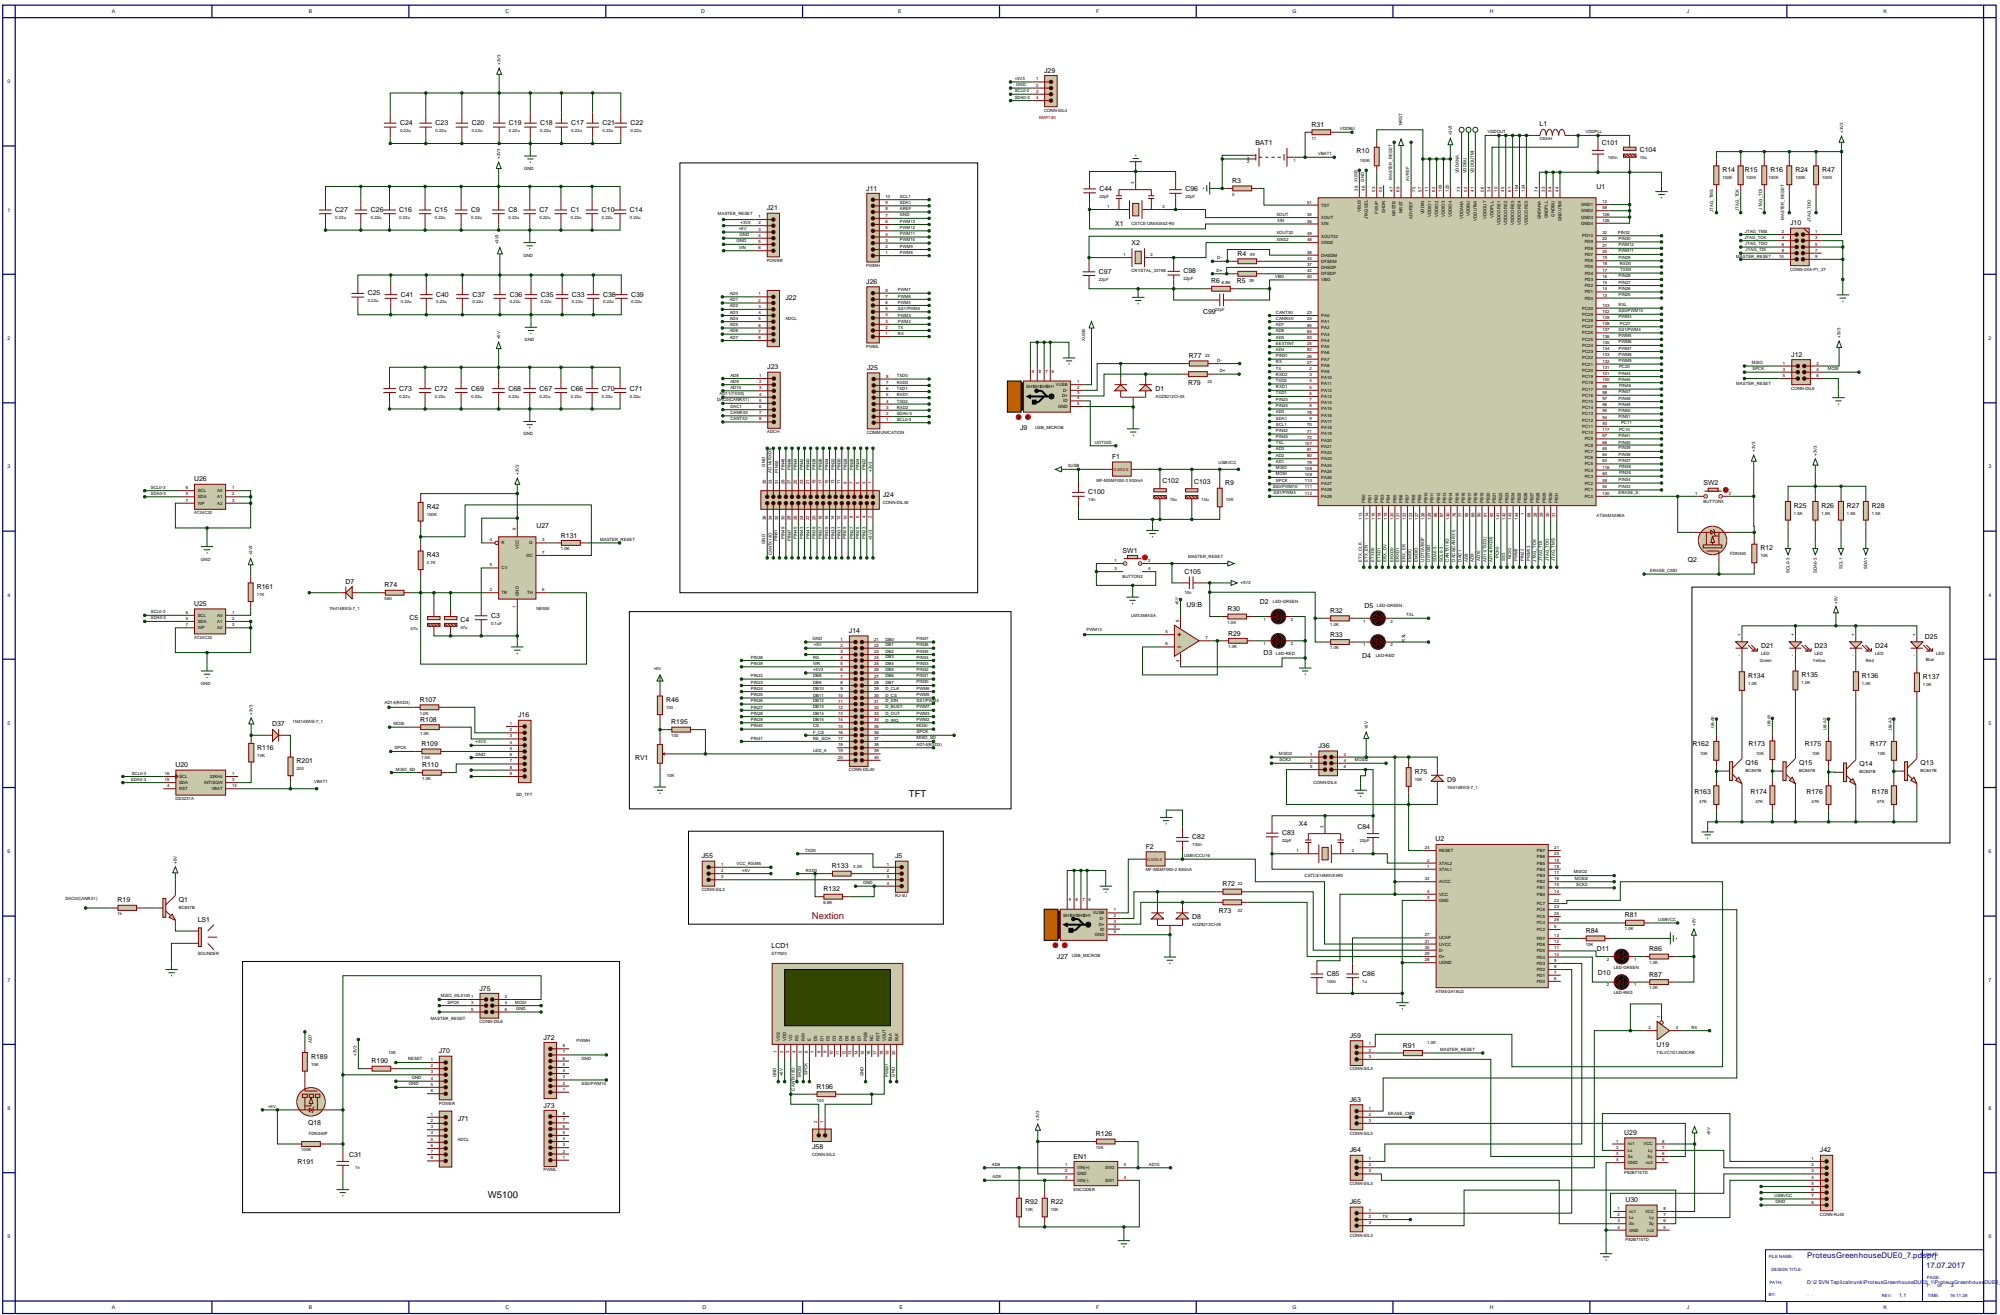
[picture p88: page 1]

## J1_RJ45

## J2_RJ45

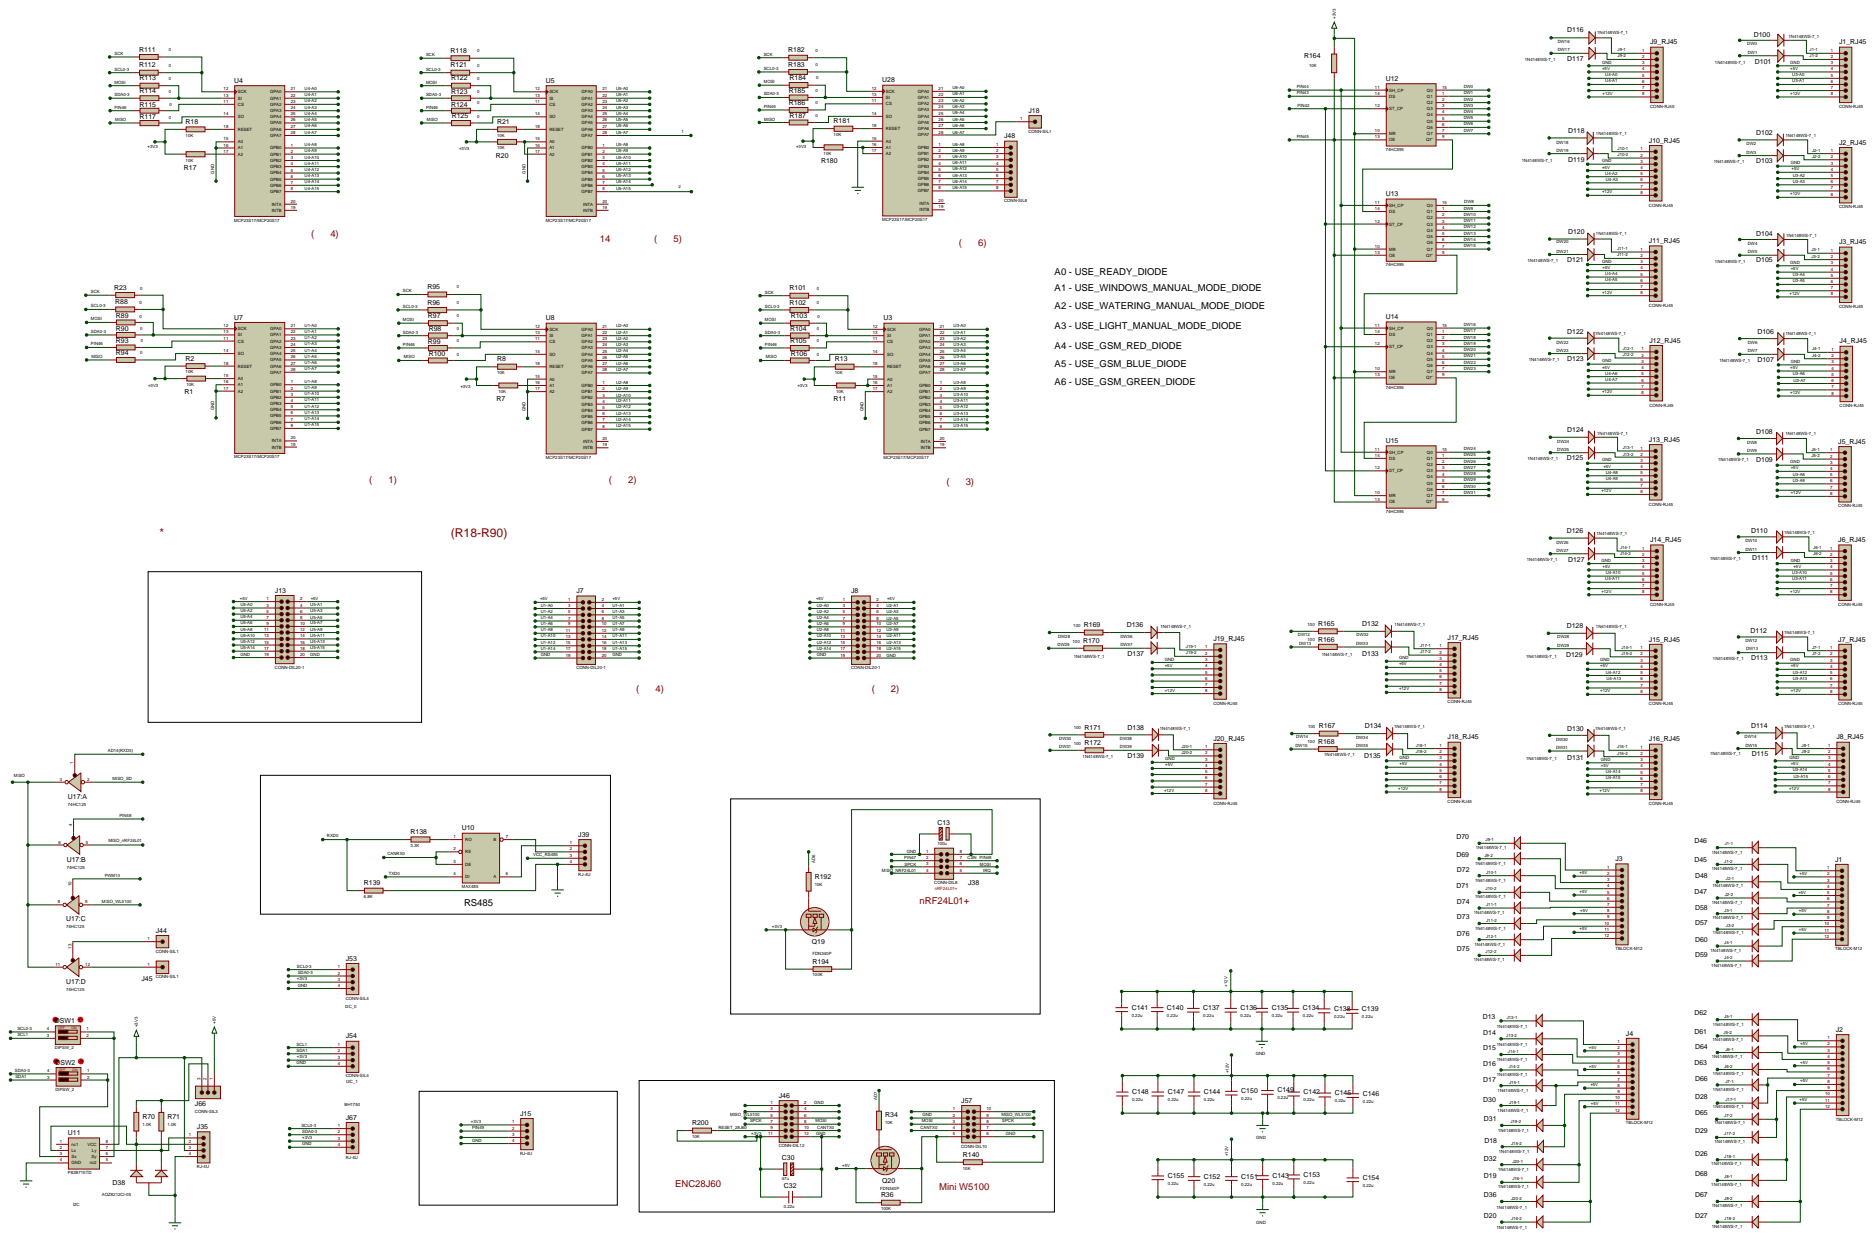
[picture p89: page 2]

* Устанавливать резисторы управляющих сигналов(R18-R90) в зависимости от типа микросхем

C106

C107

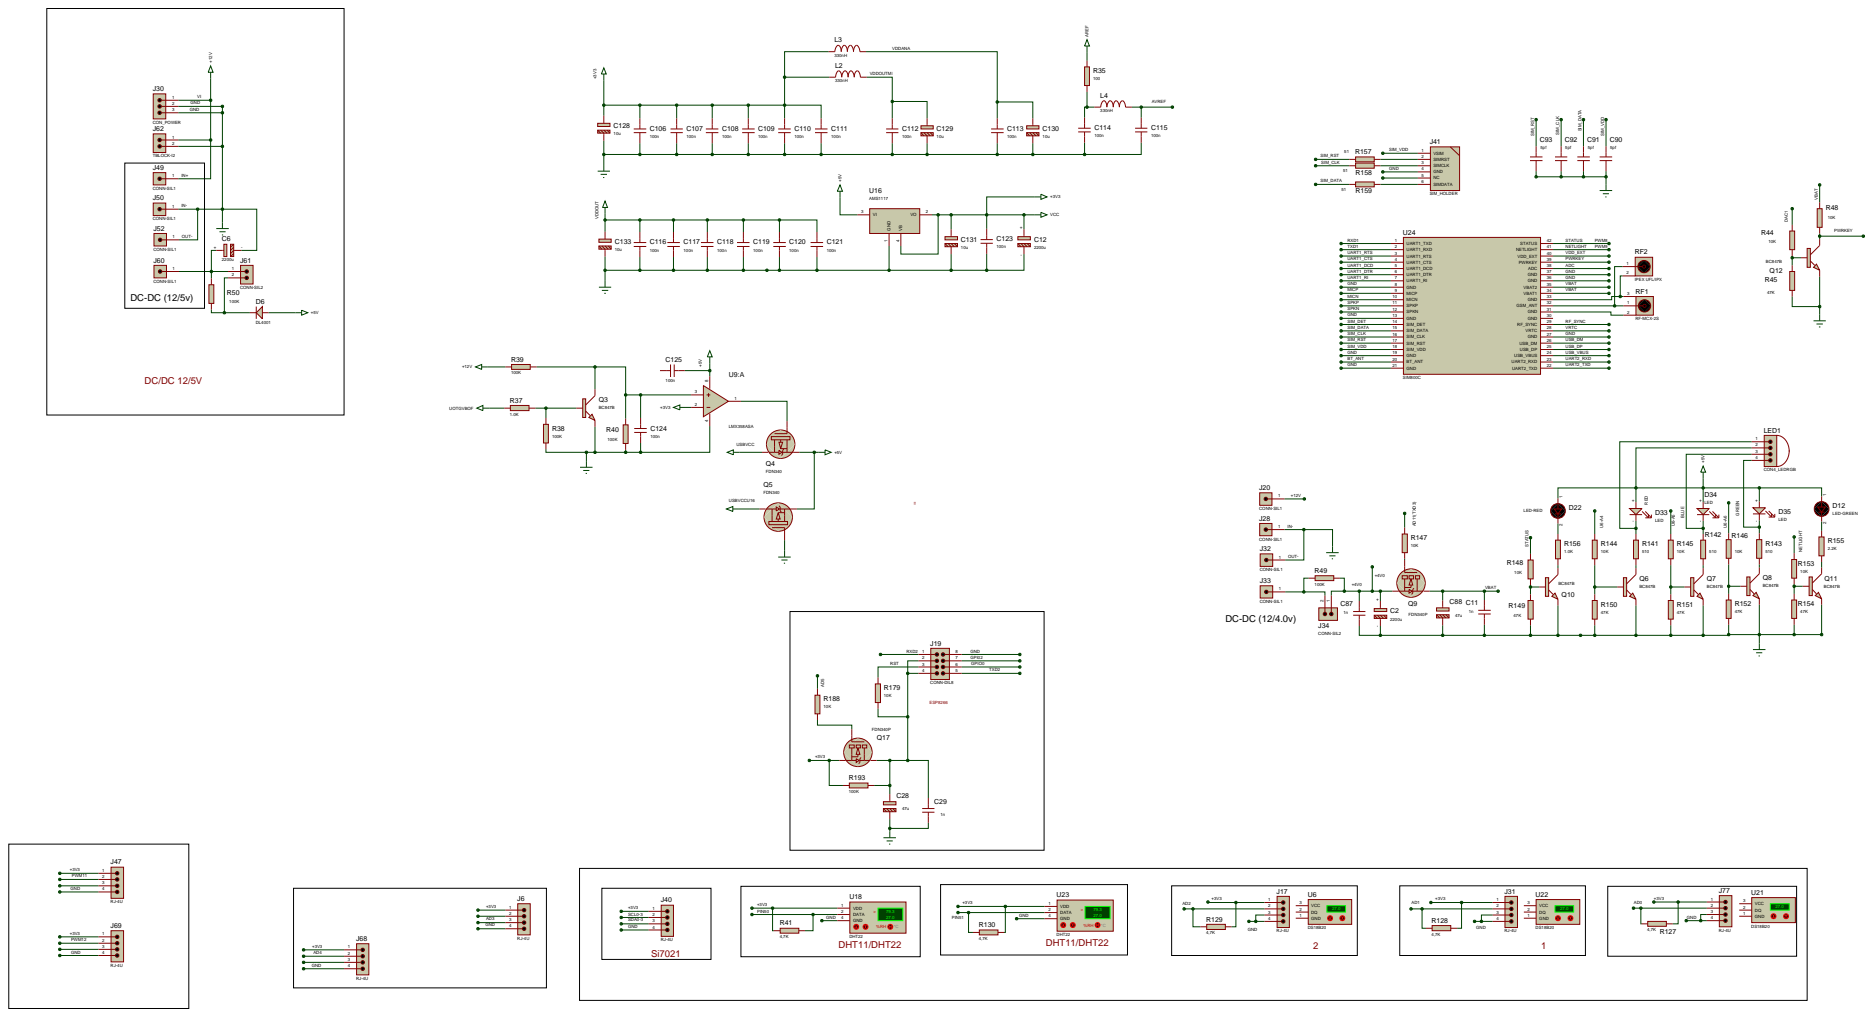
[picture p90: page 3]
