albaniac/Teplica/(list of files, drawings)

Other design files:
External_module/Execution_moduleI2C_4.pdsprj
External_module/Execution_moduleI2C_4_1.pdsprj
External_module/External_module.pdsprj
Port_extender/Port_extender_01.pdsprj
Proteus TeplicaMotor/TeplicaMotor1.pdsprj
Proteus TeplicaMotor/TeplicaMotor2.pdsprj
Proteus TeplicaMotor/TeplicaMotor2_a.pdsprj
Proteus TeplicaMotor/TeplicaMotor.pdsprj
Proteus Teplitca1/Teplitca1_1_3.pdsprj
Proteus Teplitca1Mod/Teplitca1_1Mod.pdsprj
Proteus Teplitca2/Teplitca2_1.pdsprj
Proteus Teplitca2_3Mod/Teplitca2_3Mod.pdsprj
Proteus Teplitca2Mod/Teplitca2_1Mod.pdsprj
Proteus Teplitca2Mod/Teplitca2_2Mod.pdsprj
Proteus universal module DUE/Universal controller_SAM3X8E_01.pdsprj
Proteus_Sun_Base/ProteusSunBase.pdsprj
Proteus_Sun_rele/Sun_rele1.pdsprj
Proteus_USB_Distance/Proteus_USB_Distance.pdsprj
ProteusGreenhouseDUE0_1/ProteusGreenhouseDUE0_7.pdsprj
ProteusGreenhouseDUE0_1/ProteusGreenhouseDUE0_7_1.pdsprj
ProteusGreenhouseDUE0_1/ProteusGreenhouseDUE0_7_2_1.pdsprj
ProteusGreenhouseDUE_Base/ProteusGreenhouseDUE_Base_1.pdsprj
ProteusGreenhouseDUE_Base/ProteusGreenhouseDUE_Base_1_R.pdsprj
ProteusGreenhouseDUE_Base/ProteusGreenhouseDUE_Base_2.pdsprj
ProteusGreenhouseDUE_Base/WatchDogNE555.pdsprj
ProteusGreenhouseDUE_Base_02/GreenhouseDUE_Base_Maxi.pdsprj
ProteusGreenhouseDUE_Base_02/GreenhouseDUE_Base_Maxi_R.pdsprj
ProteusGreenhouseDUE_Base_02/GreenhouseDUE_Base_Maxi_Shustov.pdsprj
ProteusGreenhouseSTM32_Base_01/Proteus_STM32F103ZET6_SSD1963.pdsprj
ProteusGreenhouseSTM32_Base_01/Universal controller_STM32F103ZET6_01.pdsprj
Внешний сторожевой таймер/NE555_Dog.pdsprj
Внешний сторожевой таймер/ProteusWatchDog1.pdsprj
Схема водоснабжения/Poliv.pdsprj
