albaniac/Teplica/ProteusGreenhouseDUE0_1/DOC/arduino-Due-Reference-design/arduino-Due-Reference-design/Arduino-DUE-V03.brd

## EAGLE design ProteusGreenhouseDUE0_1/DOC/arduino-Due-Reference-design/arduino-Due-Reference-design/Arduino-DUE-V03.brd (2017-05-28)



Parts:
ADCH: 8x1F-H8.5; 1X08
ADCL: 8x1F-H8.5; 1X08
BR1: NM; J0402
C1, C2, C3, C11, C27, C29, C33, C35, C41: 10u; SMC_B
C4, C5, C6, C7, C8, C9, C10, C12, C13, C14, C15, C16, C17, C18, C19, C28, C30, C31, C32, C34, C36, C37: 100n; C0402
C20, C26: 10n; C0402
C21, C22, C25, C39, C40: 22p; C0402
C23, C24: 22pF_NM; C0402
C38: 1u; C0402
C42: 10n; C0603-ROUND
COMMUNICATION: 8x1F-H8.5; 1X08
D2, D3: CD1206-S01575; MINIMELF
D4, D5: SS1P3L; DO220AAL
DEBUG: STRIP 4x1V M; 1X04
ERASE: MYSMD_PB157; SMD_157SW
F1, F2: MF-MSMF050-2 500mA; L1812
FID1, FID2, FID3, FID4: FIDUCIALMOUNT; FIDUCIA-MOUNT
IC1: LMV358IDGKR; MSOP08
IC2: LM2734Y; SOT23-6
IC4: NCP1117ST33T3G -3V3; SOT223
IC6: ATMEGA16U2-MU; MLF32
IC10: 74LVC1G125DCK; SC70-5
ICSP1: 3x2M; 2X03
J3: USB-MICRO B; CON2_USB_MICRO_B_AT
JP5: 2x2M - NM; 2X02
JR1: 0R; R0402
JTAG: PINHEAD_PINHD-2X5PASSO127; PINHEAD_2X05_127
L: YELLOW; CHIP-LED0805
L1, L2, L3, L5, L6: MH2029-300Y; 0805
L4: 10u SRR0604-100ML; SRR0604
ON: GREEN; CHIP-LED0805
PC1, PC2: 47u; PANASONIC_D
POWER: 8x1F-H8.5; 1X08
PWMH: 10x1F-H8.5; 1X10
PWML: 8x1F-H8.5; 1X08
Q2: BC847BSMD; SOT23
R1: 0R; R0402
R2, R13, R18, R99: 10K; R0402
R3, R14, R15, R21, R23: 1K; R0402
R4: 100K; R0402
R5, R6: 39R 1%; R0402
R7: 6k8 1%; R0603-ROUND
R8: 0R_NM; R0402
R9: 1M_NM; R0402
R10: 10k; R0402
R11: 10K; R0603-ROUND
R12: 52K3; R0603-ROUND
R19, R20: 22R; R0402
RESET: TS42
RN1, RN2, RN4: 100K; CAT16
RN3: 1k; CAY16
RN5: 1K5; CAT16
RX, RX1: YELLOW; CHIP-LED0805
SPI: 3x2M; 2X03
T1, T2, T3: FDN340P; SOT-23
TX, TX1: YELLOW; CHIP-LED0805
U1: ATSAM3X8EA-AU; LQFP144
USB1: MICRO-USB-AB1; MCR-AB1-S-RA-SMT
X2: POWERSUPPLY_DC21MMX; POWERSUPPLY_DC-21MM
XIO: 18x2F-H8.5; 2X18
Y1: 12MHz KX-7 20pF; CRYSTAL-3.2-2.5
Y2: 32.768Khz; RESONATOR_EPSON_FC_145
Y4: 16MHz KX-7 20pF; CRYSTAL-3.2-2.5
Z1, Z2, Z3, Z4, Z5: CG0603MLC-05E; CT/CN0603

Connections:
5-GND: RESET.5 (5-GND)
8PB4: IC6.18 ((T1/PCINT4)PB4), JP5.1
8PB5: IC6.19 ((PCINT5)PB5), JP5.3
8PB6: IC6.20 ((PCINT6)PB6), JP5.2
8PB7: IC6.21 ((PCINT7/OC0A/OC1C)PB7), JP5.4
16U2-TX: IC6.9 ((TXD1/INT3)PD3), IC10.1 (OE), IC10.2 (I)
+3V3: BR1.3 (2), C1.+, C4.2, C5.2, C6.2, C7.2, C8.2, C18.2, C20.2, C29.+, C37.1, ERASE.1, IC1.6 (-IN), IC4.2 (OUT), IC4.4 (OUT), IC10.5 (VCC), JR1.1, JTAG.1, L1.1, L2.1, POWER.2, POWER.4, R4.2, R99.2, RN1.5 (2), RN1.6 (2), RN2.2 (1), RN2.3 (1), RN3.5 (2), RN3.7 (2), RN3.8 (2), RN5.1, RN5.2 (1), T3.2 (S), U1.11 (VDDIO1), U1.52 (VDDBU), U1.57 (VDDIN), U1.62 (VDDIO2), U1.105 (VDDIO3), U1.125 (VDDIO4)
+5V: C30.2, C36.1, D2.C, D3.A, IC1.8 (V+), IC4.3 (IN), IC6.4 (VCC), IC6.32 (AVCC), ICSP1.2, L4.P$2 (2), PC2.+, POWER.5, R12.1, R13.2, R14.1, R15.1, SPI.2, T1.2 (S), T2.2 (S), XIO.1, XIO.2
AD0: ADCL.1, U1.78 (PA16)
AD1: ADCL.2, U1.79 (PA24)
AD2: ADCL.3, U1.80 (PA23)
AD3: ADCL.4, U1.81 (PA22)
AD4: ADCL.5, U1.82 (PA6)
AD5: ADCL.6, U1.83 (PA4)
AD6: ADCL.7, U1.84 (PA3)
AD7: ADCL.8, U1.85 (PA2)
AD8: ADCH.1, U1.88 (PB17)
AD9: ADCH.2, U1.89 (PB18)
AD10: ADCH.3, U1.90 (PB19)
AD11(TXD3): ADCH.4, U1.91 (PB20)
AD14(RXD3): U1.92 (PB21), XIO.33
AREF: BR1.1, PWMH.8
AVREF: C19.2, L3.2, U1.75 (ADVREF)
AVREFL: BR1.2 (C), C34.2, JR1.2, L3.1
BD+: J3.P3 (D+), R20.2, Z4.2
BD-: J3.P2 (D-), R19.2, Z3.2
BOOST: C42.1, D3.C, IC2.1 (BOOST)
CANRX0: ADCH.7, U1.24 (PA1)
CANTX0: ADCH.8, U1.23 (PA0)
CANTX1/IO: U1.140 (PB14), XIO.34
CMP: C31.2, IC1.5 (+IN), Q2.3 (C), RN4.3 (1), RN4.4 (1)
D+: R6.1, U1.37 (DHSDP), USB1.3 (D+), Z1.1
D-: R5.1, U1.38 (DHSDM), USB1.2 (D-), Z2.1
DAC0(CANRX1): ADCH.5, U1.76 (PB15)
DAC1: ADCH.6, U1.77 (PB16)
DTR: IC6.13 ((CTS/HWB/AIN6/TO/INT7)PD7), R18.1
EEXTINT: U1.25 (PA5)
EMDC: U1.123 (PB8)
EMDIO: U1.127 (PB9)
EN: IC2.4 (EN), R10.2
ERASE_CMD: IC6.23 ((OC1A/PCINT8)PC6), R99.1, T3.3 (G)
ERASE_S: ERASE.2, T3.1 (D), U1.130 (PC0)
ERXD0: U1.120 (PB5)
ERXD1: U1.121 (PB6)
ERX_DV: U1.119 (PB4)
ERX_ER: U1.122 (PB7)
ETXD0: U1.115 (PB2)
ETXD1: U1.118 (PB3)
ETX_CLK: U1.113 (PB0)
ETX_EN: U1.114 (PB1)
FB: IC2.3 (FB), R11.1, R12.2
GATE_CMD: IC1.7 (OUT), T1.3 (G)
GND: C1.-, C2.-, C3.-, C4.1, C5.1, C6.1, C7.1, C8.1, C9.1, C10.1, C11.-, C12.1, C13.1, C14.1, C15.1, C16.1, C17.1, C18.1, C19.1, C21.2, C22.2, C23.2, C24.2, C25.2, C26.2, C27.-, C28.2, C29.-, C30.1, C31.1, C32.1, C33.-, C34.1, C35.-, C36.2, C37.2, C38.2, C39.2, C40.2, C41.-, D4.P$2 (A), DEBUG.1, IC1.4 (V-), IC2.2 (GND), IC4.1 (GND/ADJ), IC6.3 (GND), IC6.28 (UGND), IC6.33 (PAD), IC10.3 (GND), ICSP1.6, J3.P5 (GND), J3.P$1 (SH7), J3.P$2 (SH8), J3.P$3 (SH9), J3.P$4 (SH10), J3.P$5 (SH11), J3.P$6 (SH12), J3.P$7 (SH13), J3.P$8 (SH14), J3.S1 (SH1), J3.S2 (SH2), J3.S3 (SH3), J3.S4 (SH4), J3.S5 (SH5), J3.S6 (SH6), JTAG.3, JTAG.5, JTAG.9, L.C, ON.C, PC1.-, PC2.-, POWER.6, POWER.7, PWMH.7, Q2.2 (E), R2.1, R7.1, R8.1, R11.2, R18.2, RESET.1, RESET.2, RN1.1, RN1.2 (1), RN1.7 (2), RN1.8 (2), RN2.1, RN2.4 (1), RN2.5 (2), RN2.8 (2), RN4.1, RN4.2 (1), RN4.5 (2), RN4.7 (2), SPI.6, T2.3 (G), U1.12 (GND1), U1.33 (GNDPLL), U1.44 (GNDUTMI), U1.46 (JTAGSEL), U1.54 (GNDBU), U1.58 (GND2), U1.74 (GNDANA), U1.106 (GND3), U1.126 (GND4), USB1.5 (UGND), USB1.P$1 (G1), USB1.P$2 (G2), USB1.P$3 (G3), USB1.P$4 (G4), USB1.P$5 (G5), USB1.P$6 (G6), USB1.P$7 (G7), USB1.P$8 (G8), USB1.P$9 (G9), USB1.P$10 (G10), USB1.P$11 (G11), USB1.S1 (SH1), USB1.S2 (SH2), USB1.S3 (SH3), USB1.S4 (SH4), X2.1, X2.3, XIO.35, XIO.36, Y1.2 (GND), Y1.4 (GND), Y4.2 (GND), Y4.4 (GND), Z1.2, Z2.2, Z3.1, Z4.1, Z5.1
JTAG_RESET: JTAG.10, R1.1, RN1.4 (1)
JTAG_TCK: DEBUG.2, JTAG.4, RN2.7 (2), U1.28 (PB28)
JTAG_TDI: JTAG.8, RN1.3 (1), U1.29 (PB29)
JTAG_TDO: JTAG.6, U1.30 (PB30)
JTAG_TMS: DEBUG.3, JTAG.2, RN2.6 (2), U1.31 (PB31)
L13: IC1.1 (OUT), IC1.2 (-IN), RN3.6 (2)
MASTER-RESET: C20.1, DEBUG.4, POWER.3, R1.2, R23.2, RESET.3, RESET.4, SPI.5, U1.47 (NRSTB)
MISO: SPI.1, U1.108 (PA25)
MISO2: IC6.17 ((PD0/MISO/PCINT3)PB3), ICSP1.1
MOSI: SPI.4, U1.109 (PA26)
MOSI2: IC6.16 ((PDI/MOSI/PCINT2)PB2), ICSP1.4
unnamed: IC6.26 ((PCINT10)PC4), R21.1
unnamed: L.A, RN3.3 (1)
unnamed: ON.A, RN3.4 (1)
unnamed: R15.2, RX1.A
unnamed: R8.2, U1.51 (TST)
unnamed: Q2.1 (B), R3.2, RN4.8 (2)
unnamed: R4.1, U1.53 (FWUP)
unnamed: D5.P$2 (A), L6.1
unnamed: R5.2, U1.43 (DFSDM)
unnamed: R6.2, U1.42 (DFSDP)
unnamed: R14.2, TX1.A
unnamed: RN3.1, RX.A
unnamed: RN3.2 (1), TX.A
PIN22: U1.1 (PB26), XIO.3
PIN23: U1.7 (PA14), XIO.4
PIN24: U1.8 (PA15), XIO.5
PIN25: U1.13 (PD0), XIO.6
PIN26: U1.14 (PD1), XIO.7
PIN27: U1.15 (PD2), XIO.8
PIN28: U1.16 (PD3), XIO.9
PIN29: U1.19 (PD6), XIO.10
PIN30: U1.22 (PD9), XIO.11
PIN31: U1.26 (PA7), XIO.12
PIN32: U1.32 (PD10), XIO.13
PIN33: U1.55 (PC1), XIO.14
PIN34: U1.59 (PC2), XIO.15
PIN35: U1.60 (PC3), XIO.16
PIN36: U1.116 (PC4), XIO.17
PIN37: U1.63 (PC5), XIO.18
PIN38: U1.64 (PC6), XIO.19
PIN39: U1.65 (PC7), XIO.20
PIN40: U1.66 (PC8), XIO.21
PIN41: U1.67 (PC9), XIO.22
PIN42: U1.71 (PA19), XIO.23
PIN43: U1.72 (PA20), XIO.24
PIN44: U1.101 (PC19), XIO.25
PIN45: U1.100 (PC18), XIO.26
PIN46: U1.99 (PC17), XIO.27
PIN47: U1.98 (PC16), XIO.28
PIN48: U1.97 (PC15), XIO.29
PIN49: U1.96 (PC14), XIO.30
PIN50: U1.95 (PC13), XIO.31
PIN51: U1.94 (PC12), XIO.32
PWM2: PWML.3, U1.144 (PB25)
PWM3: PWML.4, U1.139 (PC28)
PWM5: PWML.6, U1.136 (PC25)
PWM6: PWML.7, U1.135 (PC24)
PWM7: PWML.8, U1.134 (PC23)
PWM8: PWMH.1, U1.133 (PC22)
PWM9: PWMH.2, U1.132 (PC21)
PWM11: PWMH.4, U1.20 (PD7)
PWM12: PWMH.5, U1.21 (PD8)
PWM13: IC1.3 (+IN), PWMH.6, U1.68 (PB27)
RD+: IC6.29 (D+), R20.1
RD-: IC6.30 (D-), R19.1
RESET2: D2.A, IC6.24 (RESET(PC1/DW)), ICSP1.5, R13.1
RESET_CMD: IC6.22 ((INT4/ICP1/CLK0)PC7), R23.1
RX: IC10.4 (O), PWML.1, U1.27 (PA8)
RXD0: COMMUNICATION.2, U1.18 (PD5)
RXD1: COMMUNICATION.4, U1.5 (PA12)
RXD2: COMMUNICATION.6, U1.3 (PA10)
RXL: RX.C, U1.103 (PC30)
RXL-U2: IC6.10 ((INT5/AIN3)PD4), RX1.C
SCK2: IC6.15 ((SCLK/PCINT1)PB1), ICSP1.3
SCL0-3: COMMUNICATION.8, RN5.7 (2), U1.87 (PB13)
SCL1: PWMH.10, U1.70 (PA18)
SDA0-3: COMMUNICATION.7, RN5.8 (2), U1.86 (PB12)
SDA1: PWMH.9, U1.9 (PA17)
SPCK: SPI.3, U1.110 (PA27)
SS0/PWM10: PWMH.3, U1.102 (PC29), U1.111 (PA28)
SS1/PWM4: PWML.5, U1.112 (PA29), U1.137 (PC26)
SS3: U1.142 (PB23)
SW: C42.2, D4.P$1 (K), IC2.6 (SW), L4.P$1 (1)
TX: IC6.8 ((RXD1/AIN1/INT2)PD2), PWML.2, U1.2 (PA9)
TXD0: COMMUNICATION.1, U1.17 (PD4)
TXD1: COMMUNICATION.3, U1.6 (PA13)
TXD2: COMMUNICATION.5, U1.4 (PA11)
TXL: TX.C, U1.107 (PA21)
TXL-U2: IC6.11 ((XCK/AIN4/PCINT12)PD5), TX1.C
UOTGID: U1.129 (PB11), USB1.4 (ID), Z5.2
UOTGVBOF: R3.1, U1.128 (PB10)
USBVCC: C27.+, C35.+, F1.1, R2.2, R21.2, T1.1 (D)
USBVCCU2: C28.1, F2.1, IC6.31 (UVCC), T2.1 (D)
VBG: C25.1, R7.2, U1.40 (VBG)
VDDANA: C3.+, C10.2, L1.2, U1.73 (VDDANA)
VDDOUT: C11.+, C12.2, C13.2, C14.2, C15.2, C16.2, C17.2, L5.1, U1.10 (VDDCORE1), U1.45 (VDDCORE2), U1.56 (VDDOUT), U1.61 (VDDCORE3), U1.104 (VDDCORE4), U1.124 (VDDCORE5)
VDDOUTMI: C2.+, C9.2, L2.2, U1.41 (VDDUTMI)
VDDPLL: C32.2, C33.+, L5.2, U1.34 (VDDPLL)
VIN: C41.+, D5.P$1 (K), IC2.5 (VIN), PC1.+, POWER.8, R10.1, RN4.6 (2)
VIN+: L6.2, X2.2
VUCAP: C38.1, IC6.27 (UCAP)
XIN: C22.1, U1.36 (XIN), Y1.1 (C1)
XIN32: C24.1, U1.48 (XIN32), Y2.P$2 (2)
XOUT: C21.1, U1.35 (XOUT), Y1.3 (C2)
XOUT32: C23.1, U1.49 (XOUT32), Y2.P$1 (1)
XT1: C39.1, IC6.1 (XTAL1), R9.1, Y4.1 (C1)
XT2: C40.1, IC6.2 (XTAL2(PC0)), R9.2, Y4.3 (C2)
XUSB: C26.1, F1.2, U1.39 (VBUS), USB1.1 (VUSB)
XVCC: F2.2, J3.P1 (VBUS)

Notes on the sheet:
TWI pullups
TWCK1
TWD1
IOREF
TWCK0
TWD0
AD1
AD2
AD3
AD4
AD5
AD6
AD0
USB AB
AREF
AD7
SD-CS
Forces OFF the power supply to USB port
when the USB port is in HOST mode
(board powered from external power supply)
N.C.
JTAG
ERASE
CONNECT
VBUSPO: VBus Polarity Off
0: The UOTGVBOF output signal is in its default mode (active high)
1: The UOTGVBOF output signal is inverted (active low)
ETH
UTXD
URXD
(ETH)
(SD)
ETH-CS
I2C Voltage Translator
USB boot En
IF LM2736Y
R2=1K
R3=330R
PRIMA COSA DA TOGLIERE SE MANCA SPAZIO
CONFIG 5V
USB B
N.C. - internal pullup
Arduino DUE
Reference Designs ARE PROVIDED "AS IS" AND "WITH ALL FAULTS". Arduino DISCLAIMS ALL OTHER WARRANTIES, EXPRESS OR IMPLIED, REGARDING PRODUCTS, INCLUDINF BUT NOT LIMITED TO, ANY IMPLIED WARRIENTIS OR MERCHANTABILITY OR FITNESS FOR A PARTICULAR PURPOSE Arduino may make changes to specifications and pr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


Board: 2 copper layers, 101.6 x 53.3 mm, 129 parts (0 on the bottom side), 150 nets.
