albaniac/Teplica/(commit log)

2018-03-30 Переход на Git
2018-03-30 Добавил MainBaseDemo
    [Configuration_DEBUG.h, Configuration_DUE.h, Configuration_MEGA.h, Configuration_MEGA_MiniBoard.h, Configuration_Shared.h]
2018-04-02 Подключил DHT11
    [Configuration_DUE.h]
2018-04-03 Удалил файл
    [Configuration_DUE.h, Назначение выводов DUE.xls]
2018-04-03 Тест
    [Configuration_DUE.h]
2018-04-05 Новый вариант Базовой платы
    [ProteusGreenhouseDUE_Base_02.pdsprj, Назначение выводов DUE_Base.xls]
2018-04-06 Внешний модуль
    [External_module.pdsprj]
2018-04-09 Новые файлы.
    [ProteusGreenhouseDUE_Base_02.pdsprj]
2018-04-11 Файл Base_02
    [ProteusGreenhouseDUE_Base_02.pdsprj, ProteusGreenhouseDUE_Base_02_Big.pdsprj, Разъем дисп4,3.xls]
2018-04-11 Проект 02
    [ProteusGreenhouseDUE_Base_02.pdsprj]
2018-04-18 Синхронизация
    [Configuration_DUE.h]
2018-04-18 Синхро
    [Configuration_DUE.h, ProteusGreenhouseDUE0_7_2_1.pdsprj]
2018-04-19 Настройки
    [ProteusGreenhouseDUE0_7_2_1.pdsprj]
2018-04-20 Новая версия
    [ProteusGreenhouseDUE_Base_02.pdsprj, ProteusGreenhouseDUE_Base_02_Big.pdsprj]
2018-04-20 Дисплей 4.3
    [ProteusGreenhouseDUE_Base_02.pdsprj]
2018-04-22 Новая версия MainBase
    [Configuration_DEBUG.h, Configuration_DUE.h, Configuration_MEGA.h, Configuration_MEGA_MiniBoard.h]
2018-04-26 Неверов
2018-05-09 Добавил Main_Mos2_3
    [Configuration_DEBUG.h, Configuration_DUE.h, Configuration_MEGA.h, Configuration_MEGA_MiniBoard.h, Configuration_Shared.h, ProteusGreenhouseDUE0_7_2_1.pdsprj]
2018-05-28 MainBaseRTS_In Настройка MainBase
    [Configuration_DEBUG.h, Configuration_DUE.h, Configuration_MEGA.h, Configuration_MEGA_MiniBoard.h, Configuration_STM32.h, Configuration_Shared.h]
2018-05-28 Исправлен ввод даты.
2018-05-30 Внешний сторожевой таймер
    [NE555_Dog.pdsprj]
2018-06-24 Новая версия 06_24
    [Configuration_DEBUG.h, Configuration_DUE.h, Configuration_MEGA.h, Configuration_MEGA_MiniBoard.h, Configuration_STM32.h, Configuration_Shared.h]
2018-08-21 pin 595
    [Configuration_DUE.h]
2018-09-21 Новый контроллер
    [GreenhouseDUE_Base_Maxi_R.pdsprj, ProteusGreenhouseSTM32_Base_01.pdsprj, Назначение выводов DUE_Base.xls, Назначение выводов DUE_Maxi.xls, Назначение выводов STM32.xls, Назначение выводов STM32_Base_01.xls, Разъем дисп4,3.xls]
2018-11-15 Universal controller_SAM3X8E_01
    [Universal controller_SAM3X8E_01.pdsprj]
